daharoni/photodiode-lvds-receiver/docs/schematic/connector.md

# Connector sheet (as built, revision 4, decision 14)

Generated by `hardware/pcb/receiver-module/gen/connector.py`. Spec: `rev-a-sheet-specs.md` section 6 (revision 4, 2026-10-09). Nothing here is simulated or measured. Labels: VERIFIED / PROPOSED / UNRESOLVED. Citations as in the spec and `docs/research/decision-14-draft-usbc-single-connector.md` (TC = USB Type-C R2.5, WE = Wuerth rev 003.000, LVDS104 = TI SLLS396G, TPD = TI SLVSBO7O).

## Hierarchical pins
Outputs VBUS, CC1_SENSE, CC2_SENSE; bidirectional USB_DP, USB_DN, CAN_P, CAN_N (CANH/CANL; renamed from CAN_H/CAN_L 2026-10-16 so the KiCad diff-pair router pairs them), AUX; inputs LVDS_P, LVDS_N, RSSI, HV_MON, 3V3, 3V3_D (RSSI, HV_MON, 3V3, 3V3_D only feed test points TP50-TP53, as before). Removed in revision 4: +5V_CABLE, AUX2.

## J50 (AharoniLab_Connector:632723300011, Wuerth 24-pin horizontal Type-C receptacle; WE p.1, p.3 VERIFIED)
Footprint is the library symbol's own (`Wuerth_632723300011`). All four VBUS pins (A4, A9, B4, B9) on `VBUS`; all GND pins (A1, A12, B1, B12) on GND; shield S1 (the four shell posts, eight S1 pads) directly on GND since 2026-10-22 (C181 1 nF and R170 1 M DNP removed, PROPOSED; see the revision note below). Plug orientation does not matter (TC Table 3-10 p.83): N to SSTXp and P to SSTXn on both pairs (flipped 2026-10-09, see the fan-out note below).

| Pin | Net | Pin | Net |
|---|---|---|---|
| A2 SSTXP1 | LVDS_OUT2_N (U50 2Z) | B11 SSRXP1 | CAN_P |
| A3 SSTXN1 | LVDS_OUT2_P (U50 2Y) | B10 SSRXN1 | CAN_N |
| A5 CC1 | CC1 (R181 Rd, R185 tap, U51 D1+) | B5 CC2 | CC2 (R184 Rd, R188 tap, U52 D3+) |
| A6 DP1, B6 DP2 | USB_DP (tied) | B2 SSTXP2 | LVDS_OUT1_N (U50 1Z) |
| A7 DN1, B7 DN2 | USB_DN (tied) | B3 SSTXN2 | LVDS_OUT1_P (U50 1Y) |
| A8 SBU1, B8 SBU2 | AUX_CAB (tied) | A10 SSRXN2 | CAN_N |
| A11 SSRXP2 | CAN_P | | |

The ties are made by same-name local labels on the pins (nets USB_DP, USB_DN, AUX_CAB, VBUS, CAN_P, CAN_N); layout rule, not schematic: Dp/Dn ties within 3.5 mm of J50 (TC Table 3-4 note 1 p.77). A5/B5 are labelled CC/VCONN by Wuerth (WE p.3) and wired as CC1/CC2 (PROPOSED reading). Whether J50 is top- or mid-mount: UNRESOLVED.

## Parts
| Ref | Part | Note |
|---|---|---|
| J50 | 632723300011 | above |
| J51 "DEBUG / scope" | Conn_01x06 | 1 GND, 2 LVDS_DBG_N (U50 pin 11, 3Z), 3 LVDS_DBG_P (U50 pin 12, 3Y), 4 CAN_P, 5 CAN_N, 6 AUX (pair flipped 2026-10-16, VERIFIED against the exported netlist; otherwise PROPOSED) |
| U50 | SN65LVDS104PW (TSSOP-16) | A = LVDS_P, B = LVDS_N; 1Y/1Z -> J50 B3/B2, 2Y/2Z -> J50 A3/A2 (output swap and polarity flip 2026-10-09, see below), 3Z/3Y -> J51 2/3 (3Z = LVDS_DBG_N on pin 2, 3Y = LVDS_DBG_P on pin 3), 4Y/4Z no_connect; EN1-EN3 to 3V3, EN4 to GND (enables active high, LVDS104 section 9.4 Table 2, VERIFIED); VCC (4) 3V3 with C184 100 nF 0402 + C185 1 uF 0603; 23 mA typ / 35 mA max (p.5) |
| R180 | 100R 0.1 % 0603, fitted | across U50 A/B; the buffer has no on-chip termination (LVDS104 p.16 Fig. 25). Absorbs the old DNP bench pad of the same designator |
| R177 | 100R 0603, DNP | across LVDS_DBG_P/N (J51 scope load). UNRESOLVED: whether an unloaded output 3 is acceptable |
| U51 | TPD6E05U06 (USON-14, footprint Texas_R-PUSON-N14) | lower end of J50, I/O side facing J50, pin 14 uppermost: 14 = CC1 (A5), 13 no_connect (spare), 12 = LVDS_OUT2_P (A3, U50 2Y), 11 = LVDS_OUT2_N (A2, U50 2Z), 9 = CAN_P (B11), 8 = CAN_N (B10); swapped 2026-10-22, was 9 = CAN_N, 8 = CAN_P |
| U52 | TPD6E05U06 | upper end of J50, same orientation: 14 = LVDS_OUT1_P (U50 1Y, to B3), 13 = LVDS_OUT1_N (U50 1Z, to B2), 12 = CAN_P (A11), 11 = CAN_N (A10), 9 = CC2 (B5), 8 = AUX_CAB (A8/B8) |
| R181, R184 | 5.1k 1 % | Rd on CC1, CC2 (Type-C R2.0 Table 4-25 p.236) |
| R185/R187/C182 | 100k / 100k / 100 nF | CC1 tap -> CC1_SENSE |
| R188/R189/C183 | 100k / 100k / 100 nF | CC2 tap -> CC2_SENSE |
| R186 | 1k | AUX_CAB -> hierarchical AUX |
| R182, R183, C180 | 60.4R 1 %, 4.7 nF, DNP | CAN split termination, single-module bench only |
| TP50-TP55 | TestPoint | 3V3, 3V3_D, RSSI, HV_MON, GND, GND |

U51/U52 pins 1, 2, 3, 4, 6, 7 are NC pins in TI SLVSBO7O rev O (Aug 2024) Table 4-3 p.5: "Not connected; used for optional straight-through routing. Can be left floating or grounded." They are not internally connected to the I/O pins (VERIFIED, datasheet). Straight-through routing means the protected trace enters the I/O pad and leaves under the package body through the opposite NC pad (TI Fig. 7-11 p.17 layout example, drawn for the TPD4E05U06). Since 2026-10-16 the lab-library symbol (AharoniLab_Misc:TPD6E05U06, lab library branch tpd6e05u06-straight-through-pins, PR pending) draws the six NC pins as hidden passive pins stacked on the I/O pins (1 on 14, 2 on 13, 3 on 12, 4 on 11, 6 on 9, 7 on 8; KiCad library convention KLC S4.3), so each NC pad carries the same net as its opposite pad. Netlist (VERIFIED): U52 pads 1/2/3/4/6/7 = LVDS_OUT1_P / LVDS_OUT1_N / CAN_P / CAN_N / CC2 / AUX_CAB; U51 pads 1/3/4/6/7 = CC1 / LVDS_OUT2_P / LVDS_OUT2_N / CAN_P / CAN_N (6/7 swapped 2026-10-22; were CAN_N / CAN_P); U51 pad 2 shares the unconnected net of the spare pin 13 (the no_connect flag sits on the stacked pair; ERC 0/0). Layout rule (PROPOSED): route each protected line connector pad -> clamp I/O pad -> under the body -> opposite pad -> onward; this is what the 2026-10-09 "straight top-layer traces in pad order" note intended. The straight-through pads add 12 pad connections to the DRC unconnected list until routed.

ESD channel split by position (hand edit 2026-10-09, after placement started; generators frozen): the revision-4 split (U51 = both TX pairs + both CC, U52 = both CAN pairs + SBU) made half the protected lines run the length of the J50 pad rows past the other device before reaching their clamp, because the two plug orientations put the same function at opposite ends of the receptacle. U51 now clamps the lower-end pins (A5, A3/A2, B10/B11) and U52 the upper-end pins (B2/B3, A11/A10, B5, A8/B8), each pin level with its pad: A-row SMD pads get straight top-layer traces in pad order, B-row through-hole pins arrive on an inner layer with a via at the clamp pad, and pair polarity follows the pad order (ESD channels are identical). Nets unchanged; ERC 0/0; 223 components. PROPOSED.

Fan-out output swap (hand edit 2026-10-09): U50 output 1 (pins 16/15, the upper pair on the TSSOP) now feeds the upper end of J50 (B2/B3 through U52) and output 2 (pins 14/13) the lower end (A2/A3 through U51), so the two pairs no longer cross between U50 and the clamps. Polarity flip at J50 (Daniel, same day): N to SSTXp and P to SSTXn on both pairs. The lower pair now matches the package order (2Y above 2Z onto A3 above A2) with no crossing from U50 through U51 to the pads, all on the top layer. The upper pair reaches U52 uncrossed (1Y on pin 14, 1Z on pin 13) and swaps between the clamp pins and the B2/B3 barrels, where the lines already leave the top layer to get past the A-row pads. The polarity is consistent on both pairs, so plug orientation still does not matter; the cable carries the fan-out output inverted, and with LVDS_P low for a logic one (frontend.md) SSTXp is high for a one. The FPGA-end inversion constant moves accordingly (gateware, breakout docs). PROPOSED.

## Rules and citations
- Fan-out margin: TLV3605 VOD 250/350/450 mV (TLV p.7) against the buffer threshold +-100 mV: 150 mV at minimum VOD (VERIFIED arithmetic). Fail-safe static high with no TLV3605 power (LVDS104 p.15-16). Supply 3V3 up to about 101 mA total (66 mA estimate + 35 mA), inside the TPS79901 200 mA rating (rating not rechecked: UNRESOLVED). The ECP5 end is still terminated on-die (DIFFRESISTOR 100, `docs/research/ulx3s-lvds-input.md`); R180 sits at U50, not the FPGA.
- CC taps: 100k/100k keeps the pin below 3.3 V with 5.5 V VCONN on the unused CC (2.75 V, TC R2.5 p.155); a compliant source maximum 2.04 V becomes 1.02 V (TC R2.0 Table 4-36 p.241); the tap lowers effective Rd by about 2.5 %, Thevenin 50 k with 100 nF is 5 ms.
- SBU/AUX: single-ended, <= about 1 MHz (TC Table 3-24 p.113); a driven AUX line against TC section 4.3 p.150 (SBU open or weakly pulled down) is accepted; firmware holds AUX high-Z until LINK_ALL or the host class is known. UNRESOLVED: laptop alternate-mode SBU drive, SBU voltage limits.
- CAN: no termination on the module (SLLA270 p.4, p.8 Fig. 10); bus on both RX pairs gives about 45 ohm in parallel (PROPOSED). 125 kbit/s PROPOSED.
- ESD (TPD Table 5.4 p.7, VERIFIED): 0.47 pF typ, VRWM 5.5 V; place within a few mm of J50 (TPD p.5). UNRESOLVED: unidirectional clamp near -0.7 V against cable ground drop on CAN; USON-14 footprint versus the TI drawing.
- ULX3S targets gp/gn[8..13] (bank 7) then [14..21]: VERIFIED, ULX3S v3.1.7 p.2; Lattice FPGA-TN-02032 v1.4 p.14, p.26.
- HV rule: no bare APD_BIAS pad; HV_MON (about Vout/101) is the only HV observation point (PROPOSED).
- Cable rule and labelling text are on the sheet (passive full-featured USB 3.2 Gen 1, 3 A, e-marked, <= 2 m; the SuperSpeed pairs carry proprietary LVDS/CAN, not USB 3).

## Mounting holes (added 2026-10-09, hand-edited after the generators were frozen)
H1-H4 `AharoniLab_Connector:MountingHole_Pad` (footprint `AharoniLab_Connector:MountingHole_2.2mm_M2_Pad_Via`) are placed in a row at the right of the sheet (x 350-396 mm, y 150 mm), each pin 1 wired 2.54 mm to a `GND` global label (this sheet ties GND with global labels, not power symbols, so there are no new #PWR references). A text note reads "Mounting holes: M2 plated, GND tie to housing (decision: 2026-10-09)". The sheet file was edited directly (generator `gen/connector.py` is frozen and does not contain H1-H4; regenerating would drop them). PROPOSED; ERC 0/0 and the netlist shows H1-H4 pin 1 on GND, nothing measured. Requires lab-library PR #62 (symbol and footprint) merged or its branch checked out. Connector sheet now has 33 components.

Revision note (2026-10-16, Daniel, KiCad GUI, for layout): J51 debug pair flipped (pin 2 = LVDS_DBG_N, pin 3 = LVDS_DBG_P); nets CAN_H/CAN_L renamed CAN_P/CAN_N and USB_DM renamed USB_DN (no electrical change; CAN_P is CANH, U64 pin 7, CAN_N is CANL, U64 pin 6); U51/U52 straight-through NC pins stacked on the I/O pins (see the ESD note above). Net names elsewhere in this file use the new names.

Revision note (2026-10-22, Daniel): (A) J50 shell tied directly to GND (PROPOSED). C181 (1 nF) and R170 (1 M, DNP) were deleted from this sheet and the PCB; the eight J50 S1 pads are on net GND and the net /Connector/SHIELD no longer exists. Rationale: a compliant Type-C cable already ties shield to GND inside each plug (USB Type-C spec Table 3-10 note 6, as cited in `docs/research/usbc-connector-and-cable.md` line 91), so the RC never isolated anything; 1 nF is about 24 ohm at the 6.63 MHz QSCR field (arithmetic, ESL ignored), a poor bond for the cable braid around the SuperSpeed pairs; ESD on the shell should go straight to the plane. Layout rule (PROPOSED): every shell post to the GND planes with a solid (not thermal-relieved) zone connection on every layer; the plated post barrels tie the planes, no extra vias (reworded 2026-10-22, review P7), housing bonded at the connector end. Connector sheet 33 -> 31 components (board 223 -> 221). After a zone refill (kicad-cli pcb drc --refill-zones on a copy) the shield pads connect to the GND pours with 0 unconnected S1 items; the zones were not refilled in the file. ERC 0 violations. (B) Routing-only change in the KiCad GUI: on U51 the CAN clamp channels were swapped, so pin 9 (and stacked NC pin 6) = CAN_P (J50 B11) and pin 8 (and stacked NC pin 7) = CAN_N (J50 B10). J50 pin nets are unchanged and the clamp channels are identical and independent, so it is electrically neutral. U52 unchanged.

## Validation (revision 4, 2026-10-09, kicad-cli 10.0.5, root project)
D50 VBUS transient suppressor (added 2026-10-25, decision 34, hand edit with KiCad closed, PROPOSED): `AharoniLab_Passive:SMF5.0A`, unidirectional TVS, 200 W, VRWM 5 V, VBR 6.4 to 7.0 V, VC 9.2 V at 21.7 A, SOD-123FL (footprint `AharoniLab_Diode_SMD:D_SOD-123F`; lab PR #66). Pin 1 (cathode) on a `VBUS` local label, pin 2 (anode) on a GND global label, drawn left of the J50 pin-label column at (226.06, 121.92). Numbers VERIFIED against docs/datasheets/smf5.0a-panjit.pdf (Panjit SMF5.0A series REV.13; the Littelfuse SMF part is the intended vendor, LCSC C151296). Breakdown stays above the eFuse OVLO trip (5.76 to 6.20 V) and the clamp is below the TPS2596 21 V absolute maximum. ERC 0/0 after the edit; the Connector sheet designator range gains D50-D59.

ERC: 0 errors, 0 warnings. Netlist: 29 components on /Connector/ at that date (J50, J51, U50-U52, R170 [removed 2026-10-22], R177, R180-R189, C180-C185 [C181 removed 2026-10-22], TP50-TP55; 27 after the removal). Net checks: VBUS = J50 A4/A9/B4/B9, Power U5 pin 4, R35, C33, Controller U61 pin 5; USB_DP = J50 A6/B6 and U61 pin 1; USB_DN = J50 A7/B7 and U61 pin 3; CC1_SENSE = R185, R187, C182, U60 pad 9; CC2_SENSE = R188, R189, C183, U60 pad 10; AUX = R186, R204, J51 6; CAN_P = J50 A11/B11, U52 12/14, J51 4, R182, U64 7. Not simulated or measured. Revision history: revision 2 (decision 12) and revision 3 (decision 13) described the 12-pin J50 and +5V_CABLE, all removed here.
