daharoni/photodiode-lvds-receiver/docs/schematic/rev-a-sheet-specs.md

# Rev A schematic specifications, sheet by sheet

**Frozen 2026-10-09 (layout started): the generators are disabled (`hardware/pcb/receiver-module/gen/FROZEN`); this spec is now updated to describe GUI edits rather than drive regeneration.**

Status labels: VERIFIED (cited datasheet or measurement), PROPOSED (design intent), UNRESOLVED (open). Nothing on this page is measured or simulated. These specs are the brief for populating `hardware/pcb/receiver-module/*.kicad_sch`; the as-built notes live in `docs/schematic/<sheet>.md`. Authority: `docs/decision-log.md` (14 standing corrections), `docs/calculations/apd-bias-design.md`, `docs/research/ulx3s-lvds-input.md`.

Conventions for every sheet:
- Symbols only from the lab library (`${AHARONI_LAB_KICAD_LIB}`); generic R/C/L get an explicit footprint. Default passives 0603 (`R_0603_1608Metric_N`, `C_0603_1608Metric_N`); 0402 only for local decoupling at fast ICs; HV parts 1206/1210 as noted.
- GND is a global label on every sheet. Rails arrive as hierarchical labels (VBUS on Power, 3V3, 3V3_D, APD_BIAS).
- Routing targets (PROPOSED, Daniel 2026-10-09): 90 ohm differential for the four SuperSpeed pairs between U50/J50 and for `CAN_P`/`CAN_N` to J50 (they ride on 90 ohm USB-C cable pairs; TC R2.5 cable pair impedance), 90 ohm differential for `USB_DP`/`USB_DN` between J50 and U61/R193/R194; intra-pair length match within 1 mm (UI 20 ns; relaxed 2026-10-22 to 2.5 mm on DIFF90 only, CAN/USB/LVDS_P/N not skew-checked, see the PCB README); 100 ohm differential for `LVDS_P`/`LVDS_N` from U20 to the R180 termination at U50 (short run). Stackup chosen 2026-10-09: JLCPCB JLC06161H-3313, 6 layers; the trace geometries (DIFF90/USB90/CAN90 0.145/0.15 mm, DIFF100 0.11/0.15 mm) are 2D-solver values in `hardware/pcb/receiver-module/README.md`, PROPOSED until confirmed in the JLCPCB calculator.
- Nets at or above 50 V are prefixed `HV_` (plus `APD_BIAS`); the project netclass `HV` (set in the .kicad_pro by the orchestrator) uses a 1.0 mm clearance.
- Every sheet carries a text block "Design intent" with the status labels, and every value that comes from a datasheet or the calculation docs cites it in the as-built note.
- Reference designator ranges (so sheets never collide): Power U1-U9/R1-R49 (R35-R39 used by U5, see 1.1; R40-R44 free)/C1-C49 (C32-C33 used by U5)/D1-D9/L1-L9/Q1-Q9/J1-J2/RV1-RV2/TH1/FB1-FB2/TP1-TP9; Front end U10-U19/R50-R79/C50-C79/D10-D19/JP10-JP19/TP10-TP19; Slicer U20-U29/R80-R99/C80-C99/TP20-TP29; Monitor U30-U39/R100-R149/C100-C129/D30-D39/JP30-JP39/RV30-RV39/TP30-TP39; Connector J50-J59/H1-H9 (mounting holes, reserved for this sheet; H1-H4 used)/R170-R189/C180-C189/D50-D59 (added 2026-10-25 for the VBUS TVS D50, decision 34)/U50-U59/TP50-TP59 (revision 4 extends R180-R189 down to R170-R179 for the shield and J51 termination; R170 and C181 were removed 2026-10-22 with the shield tie to GND; U50 widens to U50-U59 for the two ESD arrays; R150-R169 stay unallocated); Controller U60-U69/R190-R229 (R200-R202, R215, R216 freed by revision 4)/C190-C219 (C193, C205 freed; C206-C207 stay the DNP D+/D- caps)/D60-D69/J61/SW60-SW61 (RESET, BOOT)/TP60-TP69. The Slicer's R56-R59/C53-C55/R87/C87 style parts belong to the Front End/Slicer ranges above and are not touched by the Connector sheet.

Hierarchical nets (revision 4): rails `3V3`, `3V3_D`, `APD_BIAS` (Power -> users); `VBUS` (Connector -> Power and Controller; the single 5 V input, decision 14); `DAC_HV`, `HV_DIS` (Controller -> Power); `HV_MON` (Power -> Controller, Connector); `TIA_CTRL` (Controller -> Front End); `TIA_TAP` (Front End -> Monitor, RSSI pick-off); `SDET_P` (Front End -> Slicer; `SDET_N` is built on the Slicer sheet and is not hierarchical); `VCM_REF` (Monitor -> Front End, Slicer); `RSSI` (Monitor -> Controller, Connector); `DAC_TH` (Controller -> Slicer); `VTH_MON` (Slicer -> Controller); `SHDN_N`, `LE_HYS` (Controller -> Slicer); `LVDS_P/N` (Slicer -> Connector; now the input of the fan-out buffer U50); `CAN_P`, `CAN_N` (Controller <-> Connector); `AUX` (Connector <-> Controller, one net: SBU1 and SBU2 tied); `USB_DP`, `USB_DN` (Connector <-> Controller, bidirectional); `CC1_SENSE`, `CC2_SENSE` (Connector -> Controller, divided CC levels to ADC pins). Removed in revision 4: `+5V_CABLE`, `PWR_SRC`, `AUX2`, the Controller -> Power `VBUS`. `+5V` is the internal rail (U5 OUT) inside the Power sheet and is not a hierarchical net. Root: PWR_FLAG `#FLG04` moves from the `+5V_CABLE` net to the `VBUS` net; `#FLG60` (inside the Controller sheet) is removed so there is exactly one flag on VBUS.

| Net | From | To | Revision 4 status |
|---|---|---|---|
| `VBUS` | Connector (J50 VBUS pins) | Power (U5 IN), Controller (U61 pin 5) | new direction; was Controller -> Power |
| `USB_DP`, `USB_DN` | Connector (J50 Dp1/Dp2 tied, Dn1/Dn2 tied) | Controller (R193/R194 side) | new hierarchical pins |
| `CC1_SENSE`, `CC2_SENSE` | Connector (CC taps) | Controller (IO4, IO5) | new |
| `AUX` | Connector (R186 after the SBU tie) | Controller (IO7 via R204) | kept; `AUX2` removed |
| `LVDS_P`, `LVDS_N` | Slicer | Connector (U50 A/B) | unchanged name |
| `CAN_P`, `CAN_N` | Controller | Connector (both RX pairs, U51/U52 clamps) | unchanged name |
| `+5V_CABLE`, `PWR_SRC` | | | removed |

**Revision 4 (decision 14, 2026-10-09, approved by Daniel):** one 24-pin USB-C receptacle (Wuerth 632723300011, horizontal) replaces the 16-pin USB-C J60 and the 12-pin system header J50; the TPS259631DDAR eFuse replaces the TPS2121 mux U5; the SN65LVDS104PW fan-out U50 drives both SuperSpeed TX pairs; CAN is bused on both RX pairs; SBU1 and SBU2 are tied as `AUX`; CC1 and CC2 are read on IO4 and IO5. Removed: TPS2121 two-source mux, `+5V_CABLE`, `PWR_SRC`, VBUS_SENSE divider, J60, the 12-pin J50, AUX2. Source: `docs/research/decision-14-draft-usbc-single-connector.md` (adopted) and `docs/research/usbc-connector-and-cable.md`, `usbc-power-path.md`, `lvds-fanout-and-foreign-host.md`. Everything PROPOSED unless labelled; nothing simulated or measured. The decision-13 USB-standalone requirement is kept (realised by this single connector).

**Revision 3 (decision 13, 2026-10-09; the power-mux parts are superseded by revision 4):** USB-standalone power and programming: TPS2121 source mux U5 on the Power sheet (cable priority, USB-C fallback), RESET/BOOT switches, 22 ohm D+/D- series resistors, VBUS_SENSE on IO4 and PWR_SRC on IO5. `+5V` becomes `+5V_CABLE` on the cable side; `+5V` remains the merged internal rail (mux OUT). Facts and citations: docs/research/usb-standalone-power.md. All of it PROPOSED, nothing simulated or measured.

**Revision 2 (decision 12, 2026-10-08):** the VCA821 VGA, AGC loop, detector coupon, +/-3.7 V and 5V_A rails are removed; the chain is TIA -> AC coupling -> OPA855 x7 -> low-pass -> AC coupling to a 1.65 V baseline -> TLV3605. The Control sheet becomes the Monitor sheet (reference and RSSI); the Detector sheet is deleted. Sections 2, 3, 4 and 7 below are rewritten; section 5 is gone. Facts: docs/research/post-amp-slicer.md.

**Revision 1 (decision 11):** the external-MCU header is replaced by an on-module ESP32-C6 controller sheet (section 7) with on-board I2C DAC/ADC, a CAN link in the module cable (section 6), a 3V3_D rail (section 1.5) and an HV disable gate (section 1.4). Facts and citations: docs/research/module-controller.md.

---

## 1. Power sheet (`power.kicad_sch`)

Pins: in VBUS, DAC_HV, HV_DIS; out 3V3, 3V3_D, APD_BIAS, HV_MON. (Revision 2: the LM27762 +/-3V7 block, the 5V_A bead/caps, PGOOD_VGA and TP1 are removed. Revision 4: `+5V_CABLE` and `PWR_SRC` are removed.)

### 1.1 Input: eFuse U5 (TPS259631DDAR)
- U5 `AharoniLab_Power:TPS259631DDAR`, footprint `AharoniLab_Package_SO:Texas_DDA0008B_SO-PowerPAD-8` (the exact footprint name is TO BE CONFIRMED by the lab-library PR; candidate geometry from bundled `Package_SO:HSOP-8-1EP_3.9x4.9mm_P1.27mm_EP2.41x3.1mm` or `Package_SO:TI_SO-PowerPAD-8`, compare against the DDA land pattern, TPS2596 SLVSET8A p.46: UNRESOLVED until the PR). [Resolved 2026-10-09: lab-library PR #61 supplies `AharoniLab_Package_SO:Texas_DDA-R-PDSO-G8_SO-PowerPAD-8_3.9x4.9mm_P1.27mm_EP2.4x3.1mm` (power.md); the land pattern versus the TI drawing stays a G4 footprint check.] New lab-library symbol and footprint required. Variant chosen for x1 auto-retry (TPS2596 Device Comparison p.3); fixed-clamp variants rejected (a sustained 12 V input would dissipate about 1.6 W in the FET, arithmetic). Pin map (TPS2596 p.4, VERIFIED per the draft): 1 GND, 2 dVdt, 3 EN/UVLO, 4 IN, 5 OUT, 6 FLT, 7 ILM, 8 OVLO, exposed pad GND. Abs max on IN 21 V (TPS2596 p.1, p.5).
- IN (pin 4) = `VBUS` directly (hierarchical input, source on the Connector sheet). OUT (pin 5) = `+5V`, the internal rail used by U1, U3 (via the L2 pi filter) and U4; C1 10 uF 0805 and C2 100 nF stay on `+5V`.
- Divider (all 1 %, 0603): R35 357 k from IN to EN/UVLO, R36 43.2 k from EN/UVLO to OVLO, R37 100 k from OVLO to GND. Thresholds (PROPOSED, calculated with datasheet tolerances and 1 % resistors, not simulated; draft section 3d and `docs/research/usbc-power-path.md` item 1): overvoltage cut-off 5.76-6.20 V rising (below the 7.0 V abs max of the TPS79901, TPS799 SBVS056L p.4); UVLO 4.06-4.32 V rising, 3.72-4.00 V falling.
- ILM (pin 7): R38 1.21 k 1 % to GND, never open: ILIM 0.68 / 0.76 / 0.84 A min/typ/max (TPS2596 Eq. 5 p.22, +-10.4 %; PROPOSED arithmetic). The ILM node is also a test point TP3 "IMON" (about 0.79 V/A, usbc-power-path.md 1.4). The 0.76 A limit is a real current limit, not a USB budget: a laptop port still decides the USB 0.5 A budget.
- dVdt (pin 2): C32 47 nF X7R 10 V 0603 to GND: about 0.94 V/ms, 5.3 ms ramp, about 23 mA inrush into the assumed 25 uF on +5V (25 uF is an estimate, PROPOSED, measure in G1).
- VBUS input capacitor C33 4.7 uF 25 V X5R 0805, as close to IN as possible. C34 removed.
- FLT (pin 6): open-drain, test point TP4 "FLT"; optional R39 100 k pull-up, DNP (draft: to +5V; the brief said 3V3_D). UNRESOLVED: both rails are off while the eFuse is cut off, so a pull-up to either reads 0 V and cannot separate fault from no power; a pull-up to VBUS would read correctly. Fit only for bench use, pick the rail at generator time and check the FLT pin abs max (not read). FLT is NOT routed to the ESP32 (unpowered during cut-off). VBUS-present is implied by the MCU running; no VBUS monitor in Rev A (the ADS1115 AIN3 stays the ADC zero check).
- Margin (PROPOSED arithmetic, draft 3d): a Type-C source is 4.75-5.5 V; a compliant 3 A cable drops at most 75 mV loop at 0.3 A (TC R2.5 4.4.1 p.151), so the module sees at least about 4.66 V against UV rising 4.06-4.32 V. A non-compliant 28 AWG 3 m cable would drop about 0.38 V at 0.3 A (computed), leaving about 4.37 V against the 4.32 V maximum rising threshold: UNRESOLVED, the reason for the cable rule (decision 14: <= 2 m certified passive full-featured; 3 m only after a bench check).
- Removed: TPS2121 U5, old R35/R36 priority divider, old R37 ST pull-up, old R39-R42 OV dividers, C34, nets `+5V_CABLE` and `PWR_SRC`, PWR_FLAG on `+5V_CABLE` (the flag moves to `VBUS` at the root). TPS2121 settling/inrush G1 items are replaced (gates.md).
- Budget: worst case about 0.19 A (0.24 A with 25 % margin) from `+5V`, against the 0.5 A USB default (docs/research/usb-standalone-power.md section 1.5; datasheet maxima plus an assumed 70 % LT8365 efficiency, not measured), plus up to 35 mA on 3V3 for U50 (LVDS104 SLLS396G p.5, all four outputs loaded). Radio must stay disabled. UNRESOLVED: whether a bus-powered hub holds a module to 100 mA; document "use a laptop root port or a powered hub".
- Fallback only if Daniel withdraws the new-part approval (not planned): TPS2121 with IN1 = VBUS and IN2, OV2, CP2, PR1, ST tied to GND (draft section 3d).

### 1.2 3V3: TPS79901DDCT (U1)
- IN = +5V with 1 uF 0603 at the pin; EN tied to IN; GND.
- FB divider: VOUT = VFB x (1 + R1/R2), VFB 1.193 V typ (TPS799 SBVS056L). R1 17.8 k, R2 10.0 k, 1 %, 0603 -> 3.316 V. CFB 1 nF across R1 (value UNRESOLVED, see power.md). OUT = 3V3: 2 x 4.7 uF 0805 X7R 10 V.
- Load estimate: OPA857 26.8 mA max + OPA855 (SBOS622D, check Iq at 3.3 V) + TLV3605 17.5 mA max + OPA2320 ~2 mA ~ 65 mA. PROPOSED.

### 1.5 3V3_D digital rail: TPS7A2033PDBV (U4)
- As built: IN = +5V with 1 uF; OUT = 3V3_D with 10 uF 0805 + 1 uF; EN tied to IN. Radio must stay disabled (300 mA LDO). PROPOSED.

### 1.4 APD bias: LT8365EMSE (U3)
- As built per `docs/calculations/apd-bias-design.md` sections 3.2 and 4, with the HV disable gate (Q3 on EN/UVLO, gate pulled up to 3V3_D, driven by HV_DIS, J1 "HV FORCE ON" DNP jumper) and the HV_MON divider. Unchanged in revision 2; input from +5V (U5 OUT, the eFuse output in revision 4). Revision 3: USB-alone, HV_DIS default-off and the DAC_HV safe-end rule are unchanged; firmware starts HV at the low-bias end of DAC_HV in steps, watching HV_MON and supply sag (a faulted HV start can trip a USB port; PROPOSED). The LT8365 EN/UVLO (R22/R23, rising 3.15-3.80 V) does not guard against USB sag in the legal range.

---

## 2. Front end (`frontend.kicad_sch`)

Pins: in APD_BIAS, 3V3, TIA_CTRL, VCM_REF; out SDET_P, SDET_N, TIA_TAP.
- Stage 2 filter: R50 10 k 1206 (>= 200 V) from APD_BIAS to `HV_K`; C50 10 nF >= 400 V C0G 1210 from HV_K to GND, at the cathode. D10 S12023-10: 1 A = `TIA_IN`, 3 K = HV_K, 2 CASE = GND. D11 (FDS010 bench fallback, DNP) was dropped from Rev A on 2026-10-09 (Daniel); reference D11 is retired. Standing correction 2.
- U10 OPA857 (SBOS630D): IN (15) = TIA_IN; VS+ (9, 10, 11) = 3V3 with 2 x 100 nF 0402 + 1 uF 0603; GND pins and PAD = GND; Test_SD (13) = GND; Test_IN (14) = 3V3; NC (16) no_connect. CTRL (2) = hierarchical input `TIA_CTRL` from the ESP32 (logic 1 = 20 k, 0 = 5 k; VIH 2 V) with R57 100 k pull-up to 3V3 so an unprogrammed ESP32 gives 20 k; JP10 SolderJumper_3 (common = CTRL, sides 3V3 / GND) stays for bench forcing, open by default. OUT (8) = `TIA_OUT`, OUTN (5) = `TIA_REF`.
- RSSI pick-off: `TIA_TAP` = TIA_OUT through R58 1 k (so the Monitor sheet's peak detector loads the TIA lightly); hierarchical output.
- Coupling into the post-amp (research doc section 4): C51 100 nF from TIA_OUT to `PA_IN`; R51 1 k from PA_IN to VCM_REF (corner 1.6 kHz; the research asks for >= 10 us time constant: 1 k x 100 nF = 100 us, fine). TIA_REF (OUTN) is left unused except for TP12 (single-ended post-amp; the differential option is noted on the sheet as UNRESOLVED).
- U11 OPA855IDSGR (SBOS622D; library branch add-opa855): non-inverting gain 7: IN+ = PA_IN; RF R53 301 ohm from OUT to IN-, RG R54 49.9 ohm from IN- to `PA_REF` where PA_REF = VCM_REF decoupled by C53 1 uF (so the gain is referenced to the baseline, not GND; the stage output idles at VCM_REF); check the datasheet's recommended RF/RG for G = 7 and use those values if they differ, citing the page. [Status note 2026-10-09, value unchanged: SIMULATED (ngspice 47, TI OPA855 Rev A) RF 301 / RG 49.9 is as stable as the datasheet test values 453 / 75 (77 deg PM both, moderately trustworthy, model AC polarity quirk; no parasitics or tolerances); UNRESOLVED until measured (G1). See docs/simulation/README.md Sim 1.] VS+ = 3V3 with 100 nF 0402 + 1 uF 0603 at the pin; VS- = GND; PD (power-down) pin: check polarity in the datasheet and tie it to the "enabled" level (via R 10 k) ; exposed pad per datasheet. OUT = `PA_OUT`. Place a 0 ohm DNP bypass R55 from PA_IN to PA_OUT? No: keep it simple, no bypass.
- Low-pass: R56 49.9 ohm from PA_OUT to `LPF_OUT`, C54 47 pF C0G to GND (corner 68 MHz; research asks for 60-80 MHz; PROPOSED). Then the comparator coupling: C55 100 nF LPF_OUT -> `SDET_P`; R59 1 k SDET_P -> VCM_REF. The threshold side `SDET_N` (VCM_REF plus the DAC_TH trim) is built on the Slicer sheet, so the Front End outputs only SDET_P and TIA_TAP (hierarchical outputs).
- Test points: TP10 PA_OUT, TP11 SDET_P, TP12 TIA_REF; no HV test points.
- Text: design intent (decision 12), clip thresholds (9 uA pp at 20k, 36 uA at 5k, TIA saturation 60 uA), OPA857 at 6 pF (SIMULATED: stable; 20k mode 13.8 % overshoot, 12.6 ns to 2 %, 5k clean; model fidelity at 6 pF not validated; UNRESOLVED until measured, G1; docs/simulation/README.md Sim 2), HV keep-out, APD polarity.

---

## 3. Slicer (`slicer.kicad_sch`)

Pins: in SDET_P, VCM_REF, DAC_TH, 3V3, SHDN_N, LE_HYS; out LVDS_P, LVDS_N, VTH_MON.
- U20 TLV3605RVKR (SNOSDA2F): IN+ (4) = SDET_P (arrives already coupled and returned to VCM_REF on the Front End sheet); IN- (6) = `SDET_N` = threshold node: R84 1 k from VCM_REF to SDET_N (matches the IN+ return, bias-current cancellation), DAC_TH injected through R85 100 k into SDET_N (authority about +/-16 mV around VCM_REF when the DAC spans 0-3.3 V with VCM_REF at 1.65 V: trim = (DAC - 1.65) x 1k/101k; state the number), C84 10 nF from SDET_N to GND (keeps IN- quiet). VTH_MON = SDET_N through R86 10 k (hierarchical output to the ADC).
- External hysteresis 2-4 mV (research doc section 4): R87 from OUT+ (LVDS, ~350 mV swing into the 100 ohm termination R180 at the fan-out buffer U50 on the Connector sheet, a few cm away; revision 4) to IN+ with the IN+ source impedance being the 1 k return in parallel with the coupling path; compute R87 for ~3 mV (about 100 k with a 1 k source; show the arithmetic on the sheet and label PROPOSED; footprint 0603). LE/HYS pin: R82 to GND footprint DNP (internal hysteresis off = floating; the smallest internal step ~8 mV is too large), R83 0 ohm DNP to LE_HYS for the latch option, as before.
- VCCI (2) = 3V3 with 100 nF 0402 + 1 uF; VCCO (1) = 3V3 via R80 0 ohm with 100 nF 0402 + 1 uF; VEE and EP = GND; SHDN (7) = SHDN_N with R81 10 k pull-up to 3V3; OUT+ (12) = LVDS_P, OUT- (10) = LVDS_N.
- Revision 4 note: `LVDS_P`/`LVDS_N` now go to the Connector sheet's fan-out input U50 (A/B). The 100 ohm termination (R180, 0.1 %) sits across U50 A/B (the buffer has no on-chip termination, LVDS104 p.16 Fig. 25), so the old DNP 100 ohm bench pad on the Connector sheet is absorbed into the fitted R180. The load is still 100 ohm, so the R87/C87 hysteresis tap and the 3.0 mV window are unaffected. Layout: short 100 ohm differential route to U50. No schematic change on this sheet except the text notes (termination moved). PROPOSED.
- TP20 SDET_N, TP21 SDET_P (DNP).
- Text: baseline slicing rationale (8b/10b DC balance), bias current 1-5 uA x 1 k = 1-5 mV offset (trimmed by DAC_TH), hysteresis arithmetic, SHDN not a guaranteed zero (standing correction 11).

---

## 4. Monitor (`control.kicad_sch` keeps its file name and uuid; Sheetname "Monitor")

Pins: in 3V3, TIA_TAP; out VCM_REF, RSSI.
- U30 OPA2320AIDR (3V3, 100 nF): unit A = VCM_REF buffer: R100/R101 10 k/10 k from 3V3 to GND, C100 100 nF at the midpoint, unity buffer -> VCM_REF (1.65 V), with C101 1 uF at the output? OPA2320 drives capacitive loads poorly: use R102 10 ohm isolation then C101 1 uF, and take VCM_REF after the resistor (note). [Status note 2026-10-09, value unchanged: SIMULATED (ngspice 47, TI OPAx320 Final 1.6) 10 ohm gives 87.6 deg PM with 1 uF; the no-isolation control is unstable; UNRESOLVED until measured (G1). See docs/simulation/README.md Sim 3.] The buffer sources the return currents of three 1 k resistors: negligible.
- RSSI peak detector (telemetry only, not precision): TIA_TAP -> D30 BAS70 (anode at TIA_TAP? The TIA output swings DOWN from OUTN on light (OPA857 inverting; check SBOS630D and state it), so detect the NEGATIVE peak: D30 cathode at TIA_TAP, anode at `RSSI_HOLD`), C102 1 nF C0G from RSSI_HOLD to GND, R103 1 M from RSSI_HOLD to VCM_REF (so with no signal RSSI_HOLD sits at 1.65 V and dips with signal; tau 1 ms), unit B unity buffer -> RSSI (hierarchical output, read by the ADS1115). Note: diode drop and the 1 k tap resistor make it a relative indicator; the ESP32 calibrates. PROPOSED.
- TP30 VCM_REF, TP31 RSSI, TP32 RSSI_HOLD.
- Everything else from the former Control sheet (VMID, VSPAN, integrator, TMUX1112, TLV3201, selectors, trimmers, clamps) is removed.

---

## 5. Detector coupon: removed (decision 12). Delete `detector.kicad_sch`, `gen/detector.py`, `docs/schematic/detector.md`.

---

## 6. Connector (`connector.kicad_sch`)

Pins: out VBUS, USB_DP, USB_DN, CC1_SENSE, CC2_SENSE; in LVDS_P, LVDS_N, RSSI, HV_MON, 3V3, 3V3_D; bidirectional CAN_P, CAN_N, AUX. (USB_DP/USB_DN are drawn bidirectional.) Revision 4, decision 14; source `docs/research/decision-14-draft-usbc-single-connector.md` sections 2-3, citations as in that draft (TC = USB Type-C R2.5, WE = Wuerth rev 003.000, LVDS104 = TI SLLS396G, TPD = TI TPDxE05U06 SLVSBO7O).

- H1-H4 `AharoniLab_Connector:MountingHole_Pad` (one passive pin "1" tied to GND by a global label), footprint `AharoniLab_Connector:MountingHole_2.2mm_M2_Pad_Via`: four M2 plated mounting holes, plated pad plus via ring, GND tie to the housing (decision 2026-10-09; PROPOSED; layout positions per the PCB placement plan). Designators H1-H9 are reserved for the Connector sheet. New lab-library symbol and footprint by lab-library PR #62 (branch `add-mounting-holes`).
- J50 `AharoniLab_Connector:632723300011` (Wuerth, 24-pin horizontal Type-C hybrid receptacle, 1.6 mm PCB; WE p.1, p.3, VERIFIED), footprint `AharoniLab_Connector:Wuerth_632723300011`. New lab-library symbol and footprint by library PR (neither exists, draft CONN 4.2). Pin names per TC Table 3-4 p.76; Wuerth labels A5/B5 "CC"/"VCONN" (WE p.3), wired as CC1/CC2 per the receptacle names (PROPOSED reading). All VBUS pins bussed, all GND pins bussed. Whether the part is top- or mid-mount is UNRESOLVED (check at layout).

| Pin | Signal | Net | Pin | Signal | Net |
|---|---|---|---|---|---|
| A1 | GND | GND | B12 | GND | GND |
| A2 | SSTXp1 | LVDS_OUT2_N (U50 2Z) | B11 | SSRXp1 | CAN_P |
| A3 | SSTXn1 | LVDS_OUT2_P (U50 2Y) | B10 | SSRXn1 | CAN_N |
| A4 | VBUS | VBUS | B9 | VBUS | VBUS |
| A5 | CC1 | CC1 (R181 Rd 5.1 k 1 % to GND; tap) | B8 | SBU2 | AUX_CAB |
| A6 | Dp1 | USB_DP (tied to B6) | B7 | Dn2 | USB_DN (tied to A7) |
| A7 | Dn1 | USB_DN (tied to B7) | B6 | Dp2 | USB_DP (tied to A6) |
| A8 | SBU1 | AUX_CAB (tied to B8) | B5 | CC2 | CC2 (R184 Rd 5.1 k 1 % to GND; tap) |
| A9 | VBUS | VBUS | B4 | VBUS | VBUS |
| A10 | SSRXn2 | CAN_N | B3 | SSTXn2 | LVDS_OUT1_P (U50 1Y) |
| A11 | SSRXp2 | CAN_P | B2 | SSTXp2 | LVDS_OUT1_N (U50 1Z) |
| A12 | GND | GND | B1 | GND | GND |

  The polarity rule (flipped 2026-10-09, see the bracketed note under U50 below): N to SSTXp and P to SSTXn on both pairs, the same on both so orientation still does not matter. Plug orientation does not matter (draft section 2.2, from TC Table 3-10 p.83 cable wiring: in all four flip combinations the module's two driven pairs land on the far end's {RX1, RX2} with polarity preserved). Layout rules (not schematic): the Dp1/Dp2 and Dn1/Dn2 ties within 3.5 mm of the receptacle (TC Table 3-4 note 1 p.77), ESD arrays within a few mm of the receptacle (TPD p.5 note). Shield: originally a separate pad net to GND through C181 1 n in parallel with R170 1 M (DNP), the convention carried over from the old J60 (C193/R202); changed 2026-10-22 (Daniel, PROPOSED): C181 and R170 removed, shell pads directly on GND (see `connector.md` revision note 2026-10-22).
- Rd and CC taps (decision 14, draft 3e; PROPOSED): R181 5.1 k 1 % from CC1 to GND and R184 5.1 k 1 % from CC2 to GND (Rd, needed to detect the source advertisement, USB Type-C R2.0 Table 4-25 p.236). Per CC pin, a tap: CC1 -> R185 100 k -> `CC1_SENSE`, R187 100 k and C182 100 nF from `CC1_SENSE` to GND; CC2 -> R188 100 k -> `CC2_SENSE`, R189 100 k and C183 100 nF from `CC2_SENSE` to GND. Reason for 100 k/100 k: the pin stays below 3.3 V even if an e-marked cable puts its 5.5 V VCONN (3.0-5.5 V, TC R2.5 p.155) on the unused CC pin (2.75 V at the pin). Arithmetic: a compliant source CC maximum 2.04 V (TC R2.0 Table 4-36 p.241) becomes 1.02 V; class voltages 0.42 / 0.94 / 1.69 V (56 k / 22 k / 10 k) become 0.21 / 0.47 / 0.85 V; thresholds 0.66 V and 1.23 V become 0.33 V and 0.615 V. The 200 k tap in parallel with 5.1 k lowers effective Rd by about 2.5 % and every class voltage with it (fold into the firmware thresholds). Thevenin 50 k with 100 nF = 5 ms time constant.
- SBU: `AUX_CAB` (A8 and B8 tied) -> R186 1 k -> hierarchical `AUX`. Cable SBU is single-ended, 32-53 ohm, <= 5 ohm DC, 2 dB loss at 0.5 MHz and 4 dB at 1 MHz (TC Table 3-24 p.113), so AUX is slow (<= about 1 MHz, PROPOSED). TC section 4.3 p.150 says a port that implements neither USB4 nor an Alternate Mode leaves SBU open or weakly pulled down (>= 950 kohm); our AUX is a driven line, noted and accepted (neither end is a compliant alternate-mode port, PROPOSED). UNRESOLVED: a laptop plugged directly might drive SBU for DisplayPort alt mode (needs USB PD discovery the module never answers); SBU voltage limits not in hand; the 1 k plus the clamp limit the exposure of the 3.3 V-only ESP32 GPIO. Firmware holds the AUX driver high-Z until LINK_ALL or the host class is known. R187 (old AUX2 1 k) is reused above; AUX2 is gone.
- Fan-out U50 `SN65LVDS104PW` (new lab-library symbol; pin map from LVDS104 p.3: EN1 1, EN2 2, EN3 3, VCC 4, GND 5, A 6, B 7, EN4 8, 4Z 9, 4Y 10, 3Z 11, 3Y 12, 2Z 13, 2Y 14, 1Z 15, 1Y 16), footprint `AharoniLab_Package_SO:TSSOP-16_4.4x5mm_P0.65mm` (exists; TI mechanical drawing not compared, UNRESOLVED, check at layout). Input: A = `LVDS_P`, B = `LVDS_N` from the Slicer, R180 100 ohm 0.1 % 0603 across A/B (fitted; the buffer has no on-chip termination, LVDS104 p.16 Fig. 25). TLV3605 VOD 250/350/450 mV (TLV p.7) against the buffer threshold +-100 mV and common-mode 0 to VCC-0.8 V (LVDS104 p.4-5): margin 150 mV at minimum VOD (VERIFIED arithmetic, draft 3b). Outputs: 1Y/1Z -> LVDS_OUT1_P/N (J50 B3/B2), 2Y/2Z -> LVDS_OUT2_P/N (J50 A3/A2), 3Y/3Z -> J51 pins 2/3, 4Y/4Z no_connect. [Swapped by hand edit 2026-10-09 (originally 1 -> A2/A3, 2 -> B2/B3): output 1 is the upper pair on the TSSOP and B2/B3 is the upper end of J50, so with this assignment the two pairs run to their clamps without crossing each other. Polarity flipped at J50 the same day (Daniel): N to SSTXp and P to SSTXn on both pairs, so the lower pair A3/A2 (n above p) matches 2Y above 2Z on the package with no crossing at all, and the upper pair takes its swap between the U52 clamp pins and the B2/B3 barrels, where the lines already change layer to get past the A-row pads. Consequence: the cable carries the fan-out output inverted on both pairs; since LVDS_P is low for a logic one (frontend.md), SSTXp is HIGH for a one. The FPGA-end polarity is a gateware constant either way; record it in the breakout/gateware docs.]
- Enables: the SN65LVDS104 enables are ACTIVE HIGH (function table, LVDS104 section 9.4 Table 2: xEN = H gives the data-following state, xEN = L gives Z; VIH >= 2 V and VIL <= 0.8 V, p.4; abs max on enables 6 V; VERIFIED, `docs/research/downloads/lvds-fanout/sn65lvds104.pdf`, SLLS396G). EN1, EN2, EN3 tied to 3V3; EN4 tied to GND (output 4 disabled and Hi-Z). Enables have no documented pull-up, so each is tied (LVDS104 p.4). Supersedes the draft's "EN3 default low": Daniel approved keeping J51 on output 3, so EN3 is high.
- Decoupling: C184 100 nF 0402 and C185 1 uF 0603 from 3V3 to GND at U50 VCC (4). Supply current 23 mA typ, 35 mA max with all four outputs loaded, 3 mA typ / 8 mA max all disabled (LVDS104 p.5, VERIFIED); with output 4 disabled the actual draw is lower but not given, so 35 mA is the bound: 3V3 estimate about 66 mA -> up to about 101 mA, inside the TPS79901 200 mA range (TPS799 SBVS056L; the 200 mA rating was not rechecked in power.md: UNRESOLVED). Fail-safe: with no TLV3605 power the buffer drives a static high on all outputs (LVDS104 p.15-16, VERIFIED); outputs Hi-Z when disabled or VCC < 1.5 V, IOS +-10 mA, outputs abs max -0.5 to 4 V (p.4-5, VERIFIED).
- CAN: `CAN_P` bused to J50 B11 and A11, `CAN_N` to J50 B10 and A10 (hierarchical, from the Controller's SN65HVD230). DNP split termination R182/R183 60.4 ohm + C180 4.7 nF stays for single-module bench use; the termination is at the FPGA-end breakout only (SLLA270 p.4, p.8 Fig. 10). Two bused cable pairs give about 45 ohm in parallel, acceptable at the slowed edges (PROPOSED).
- ESD: two `TPD6E05U06RVZ` (USON-14, 1 x 2.5 mm; 0.47 pF typ, VRWM 5.5 V, VBR 6.5-8.5 V, leakage 10 nA max, TPD Table 5.4 p.7, VERIFIED; I/O pins D1+/D1-/D2+/D2-/D3+/D3- on pins 14, 13, 12, 11, 9, 8, GND pins 5 and 10; pins 1, 2, 3, 4, 6, 7 are NC "used for optional straight-through routing, can be left floating or grounded", SLVSBO7O rev O Table 4-3 p.5, VERIFIED; since 2026-10-16 the lab-library symbol stacks them as hidden passive pins on the opposite I/O pins: 1 on 14, 2 on 13, 3 on 12, 4 on 11, 6 on 9, 7 on 8, KLC S4.3, so each NC pad carries the same net as its opposite pad and the trace can run connector pad -> I/O pad -> under the body -> opposite pad -> onward, PROPOSED layout rule, TI Fig. 7-11 p.17; U51 pad 2 shares the unconnected net of spare pin 13; the 12 extra pad connections show as DRC unconnected until routed) placed within a few mm of J50 (TPD p.5). New lab-library symbol and USON-14 footprint (copy of bundled `Package_SON:Texas_R-PUSON-N14`, compare with the TI drawing: UNRESOLVED). Channel assignment (explicit, PROPOSED; 11 channels used, one spare):

| Channel | U51 (lower end of J50) | U52 (upper end of J50) |
|---|---|---|
| D1+ (pin 14) | CC1 (A5) | LVDS_OUT1_P (U50 1Y; to SSTXn2 B3) |
| D1- (pin 13) | spare (no_connect) | LVDS_OUT1_N (U50 1Z; to SSTXp2 B2) |
| D2+ (pin 12) | LVDS_OUT2_P (SSTXn1, A3, U50 2Y) | CAN_P at SSRXp2 (A11) |
| D2- (pin 11) | LVDS_OUT2_N (SSTXp1, A2, U50 2Z) | CAN_N at SSRXn2 (A10) |
| D3+ (pin 9) | CAN_N at SSRXn1 (B10) | CC2 (B5) |
| D3- (pin 8) | CAN_P at SSRXp1 (B11) | AUX_CAB (SBU, A8/B8) |

Revision note (2026-10-16, Daniel, KiCad GUI): J51 debug pair flipped (2 = LVDS_DBG_N, 3 = LVDS_DBG_P); CAN_H/CAN_L renamed CAN_P/CAN_N (CANH/CANL) and USB_DM renamed USB_DN so the KiCad diff-pair router pairs them, no electrical change; the straight-through NC pins of U51/U52 are stacked on the I/O pins (ESD bullet above).

Layout note (2026-10-09, hand edit after placement started): the original split (U51 = both TX pairs and both CC, U52 = both CAN pairs and SBU) was replaced by a split by position along the J50 pad rows, because the two cable orientations put the same function at opposite ends of the receptacle (A2/A3 and B11/B10 at one end, B2/B3 and A11/A10 at the other). Each device now sits at one end of the pin rows and clamps only the pins next to it, so every protected line runs connector pad -> clamp pad -> destination without a detour past the other device. Nets are unchanged; only which clamp sits on which pad moved. Both devices are placed with the I/O side (pins 14 to 8, top to bottom) facing J50, each level with its end of the pad rows. Pin order follows the pads: the A-row pads are SMD at 0.5 mm pitch and get straight top-layer traces, so they are assigned to the pins level with them and in the same top-to-bottom order (U52: A11/A10 on 12/11, A8 on 8; U51: A5 on 14, A3/A2 on 12/11). The B-row pins are through-hole and reach their clamp pins by an inner-layer trace and a via at the pad, so their alignment matters less (U52: B2/B3 on 14/13, B5 on 9; U51: B10/B11 on 9/8). ESD channels are identical, so pair polarity is free: U51 carries N above P and L above H because that is the order of A3/A2 and B10/B11 at the lower end of the receptacle.

  Excluded: TI ESD122 (VRWM +-3.6 V) and Nexperia PUSB3FR4 (VI max 3.3 V) clamp or conduct below the 5 V levels on CC, SBU and CAN. UNRESOLVED: unidirectional clamps conduct near -0.7 V; with up to 0.4 V of cable GND drop check the CAN common-mode excursion against that clamp. USBLC6-2SC6 on D+/D- stays on the Controller sheet (full speed; place it near J50 at layout).
- J51 Conn_01x06 "DEBUG / scope header" (Daniel kept it, 2026-10-09; PROPOSED pin map): 1 GND, 2 LVDS_DBG_N (U50 pin 11, 3Z), 3 LVDS_DBG_P (U50 pin 12, 3Y), 4 CAN_P, 5 CAN_N, 6 AUX (pair flipped 2026-10-16 for layout, VERIFIED against the exported netlist). R177 100 ohm DNP across pins 2/3 (UNRESOLVED whether an unloaded output 3 is acceptable; LVDS104 is characterised with 100 ohm loads). RSSI, HV_MON, 3V3, 3V3_D stay on test points TP50-TP55 (3V3, 3V3_D, RSSI, HV_MON, GND x2).
- Removed: the Wuerth 61201221621 12-pin J50, R187's AUX2 role, `+5V_CABLE`, AUX2, the old J51 pin map, the DNP 100 ohm bench pad R180 (R180 is now the fitted U50 input termination).
- Designators on this sheet: R170 shield 1 M DNP (removed 2026-10-22), R177 J51 100 ohm DNP, R180 U50 termination, R181 Rd CC1, R182/R183 CAN DNP, R184 Rd CC2, R185 CC1 series, R186 AUX, R187 CC1 shunt, R188 CC2 series, R189 CC2 shunt; C180 CAN DNP, C181 shield (removed 2026-10-22), C182 CC1 tap, C183 CC2 tap, C184 and C185 U50 decoupling; U50 fan-out, U51 and U52 ESD; J50, J51. Passive sizes: 0603 default, 0402 for C184, 0805 bulk. No collision with the Slicer (R80-R99/C80-C99, so R87/C87 and R56-R59/C53-C55 are in other ranges).
- Text: cable table, cable rule (passive full-featured, USB 3.2 Gen 1, 3 A, e-marked, <= 2 m certified; 3 m only after a bench check of the specific cable: DC continuity of the SS wires then a scope of LVDS and CAN; TC Table 3-1 p.44, TC 3.4.1.1 p.83, TC 4.4.1 p.151), labelling ("USB-C: USB 2.0 and 5 V only on a host; SuperSpeed pairs carry proprietary LVDS/CAN, not USB 3"; the module is not USB 3 compliant), CAN rule (no module termination, 125 kbit/s PROPOSED), HV rule.

---

## 7. Controller (`controller.kicad_sch`)

Pins: in 3V3_D, HV_MON, RSSI, VTH_MON, VBUS, USB_DP, USB_DN, CC1_SENSE, CC2_SENSE; out DAC_TH, DAC_HV, HV_DIS, SHDN_N, LE_HYS, TIA_CTRL; bidirectional CAN_P, CAN_N, AUX. (Revision 4: PWR_SRC in, VBUS out and AUX2 are removed; VBUS becomes an input.)
- As built (revision 1) with these changes: MCP4728 OUTA -> `DAC_A` test pad only (spare; DAC_GAIN is gone), OUTB = DAC_TH, OUTC = DAC_HV, OUTD = `DAC_D` test pad. ADS1115: AIN0 = HV_MON, AIN1 = RSSI, AIN2 = VTH_MON, AIN3 = GND through its RC (spare, the ADC zero check). GPIO map: HV_DIS = IO0, SHDN_N = IO1, I2C IO2/IO3, IO4 = CC1_SENSE and IO5 = CC2_SENSE (revision 4), LDAC IO6, AUX IO7 (through R204 1 k), LE_HYS IO14, IO15 no_connect (strapping pin), TIA_CTRL = IO20 (output, Hi-Z at reset is fine because the Front End pull-up makes it 20 k), CAN TX/RX IO19/IO18 (swapped 2026-10-10 for layout; was IO18/IO19), DAC_RDY IO22, STATUS LED IO23, USB IO12/13, UART IO16/17, BOOT IO9, IO8 pull-up, IO21 no_connect (AUX2 and its R187 are gone; free for later, for example an LVDS-enable override: UNRESOLVED, not proposed). Remove the LOS and PGOOD_VGA labels and the VSPAN/VG/VMID inputs.
- Revision 4 USB: J60 (16-pin USB4105) is removed; the receptacle is J50 on the Connector sheet. USB_DP and USB_DN arrive as hierarchical inputs. U61 USBLC6-2SC6 stays on `USB_DP`/`USB_DN` with its VBUS pin 5 on the hierarchical input `VBUS`; R193/R194 22 R (and DNP C206/C207) unchanged on the ESP32 side. R200/R201 (Rd), R202/C193 (shield), R215/R216/C205 (VBUS_SENSE) and PWR_FLAG #FLG60 are removed from this sheet (Rd and shield moved to the Connector sheet with new designators; the root carries the single PWR_FLAG #FLG04 on VBUS). UNRESOLVED: USBLC6-2SC6 VBUS-pin clamp behaviour not verified (ST datasheet not read); VBUS surge protection is the eFuse U5 (21 V abs max, TPS2596 p.5), not the USBLC6.
- CC sense: `CC1_SENSE` -> U60 pad 9 (IO4, ADC1_CH4), `CC2_SENSE` -> U60 pad 10 (IO5, ADC1_CH5), replacing the VBUS_SENSE and PWR_SRC connections; the 100 k/100 k/100 nF networks are on the Connector sheet. The only ADC range read is ATTEN2, 0-1.9 V with total error +-23 mV after calibration (ESP32-C6 datasheet v1.5 Table 5-6 p.66); it covers the 1.02 V maximum at the pin. Referred to the CC pin the error is +-46 mV against class-edge margins of about 20-25 mV at the pin after the halving, so classification is thin: firmware requires three consecutive agreeing reads across more than tRpValueChange (10-20 ms, TC R2.0 Table 4-31 p.239-240). UNRESOLVED: whether a finer attenuation range exists and its accuracy (check the TRM ADC chapter before layout). IO4/IO5 are MTMS/MTDI strapping pins that only select SDIO sampling edges (MINI-1 datasheet Table 4-4 p.14); SDIO unused, PROPOSED harmless. UNRESOLVED: ESP32 clamp-injection current for a fault on the CC taps (no separate GPIO abs max, input high max VDD + 0.3 V, Table 5-4 p.65).
- D+/D- series R193/R194 22R (ESP32-C6 Hardware Design Guidelines (HDG) PDF p.18 section 1.3.13: reserve 22/33 ohm and capacitors to ground; MINI-1 datasheet v1.5 Fig. 9-1 p.40 leaves them TBD). C206 and C207 (DNP, C_0402_1005Metric_N, value TBD on the first board) from USB_E_DP and USB_E_DN (named USB_DP_E/USB_DN_E until 2026-10-22) to GND on the module side of R193/R194. PROPOSED. UNRESOLVED: effect of 22 ohm with the USBLC6 untested; auto-reset (below) untested through them.
- Buttons (new lab part, library PR required: AharoniLab_Switch category, symbol PTS810, footprint AharoniLab_Switch_SMD:SW_SPST_PTS810): SW60 RESET from EN to GND, SW61 BOOT from BOOT (IO9) to GND. TP60/TP61 stay in parallel. R190 10k + C190 1u is the reset debounce and the recommended EN RC (MINI-1 datasheet p.40, HDG p.10); no series resistor, no extra capacitor on IO9. Download Boot is GPIO9 = 0 with GPIO8 = 1 at EN rising (MINI-1 datasheet Table 4-3 p.13; HDG p.15 Table 4), VERIFIED. Fit both buttons even though RTS/DTR auto-reset exists (TRM v1.2 PDF p.1030 Table 32.3-2): recovery for empty flash or a disabled USB PHY (HDG p.30). UNRESOLVED: EN-side ESD diode (optionally a DNP TPD1E10B06 footprint); the eFuse dVdt ramp (about 5.3 ms estimated) versus the 10 ms EN RC.
- CAN transceiver U64 SN65HVD230D: R199 (RS to GND) changes from 10 k to 100 k. Reason: slower edges for stubs up to 3 m. With 10 k the datasheet rise time is 80/120/160 ns (HVD230 SLOS346O p.8) and the SLLA270 p.9 rule (stub <= 1/3 of the critical length at 5 ns/m) allows only about 2.7 m at the minimum edge; with 100 k the rise time is 600/800/1200 ns (HVD230 p.8) and the same rule allows at least 20 m, with t(LOOP) 535-990 ns still about 12 % of the 8 us bit at 125 kbit/s (datasheet numbers VERIFIED, arithmetic PROPOSED). Bench-verify (G4). HVD230 CANH/CANL tolerate -4 to 16 V and +-25 V transient (p.5) and have 20-50 kohm input resistance per pin (p.7), three orders above a USB 3 receiver termination of 18-30 ohm (TUSB1002 p.8, secondary source), so a USB 3 host should not detect a receiver (PROPOSED; USB 3.2 spec not obtained, UNRESOLVED).
- Pin map additions: 9 IO4 CC1_SENSE; 10 IO5 CC2_SENSE; IO15 and IO21 no_connect.
- Firmware states (decision 14, PROPOSED; detail in `firmware/esp32/README.md`): `cc_class` (`default`, `1.5A`, `3.0A`, `none`) and `cc_orient` (`cc1`, `cc2`, `none`) are logged hints; `usb_host` = USB Serial/JTAG SOF seen (TRM v1.2 section 32.5 p.1035). The definitive "system" indicator is LINK_ALL from the FPGA master, listened for at every boot (about 1.5 s or longer). Mode table: LINK_ALL yes -> `bus`; LINK_ALL no, SOF yes -> `usb` standalone (stepped HV start); neither, class 1.5 A -> `usb` until LINK_ALL arrives, then `bus`; neither, no Rp -> `usb` with a warning. CAN TX stays silent (RS high or listen-only) until bus traffic or the FPGA master is seen, so a lone module on a laptop never transmits into the host's SS receive pair. Rp class and orientation never gate HV; the ESP32 must not clear HV_DIS on the basis of these inputs alone. The eFuse limit (about 0.76 A) can reset the module, so the boot log records the reset reason. UNRESOLVED: firmware policy for the D+ pull-up backdrive into an unpowered host (override register, TRM p.1042); self-test cannot prove the comparator or LVDS output without an FPGA or optical source; ground offset between laptop and FPGA supply not analysed.
- Text: update the pin map table and the role text (decision 12: firmware range trim = DAC_HV + TIA_CTRL from RSSI and FPGA validity; module runs unprogrammed at 20k and the resistor-set bias [superseded 2026-10-22, decision 21: no resistor-set bias exists, an unprogrammed module is dark]; decision 14 USB and CC role).

---

## 8. Root (`root.kicad_sch`, revision 4)

- Sheet-symbol pins and wires follow the hierarchical-net table above. Connector drives `VBUS` to Power (U5 IN) and Controller (U61 pin 5); `USB_DP`/`USB_DN`, `CC1_SENSE`/`CC2_SENSE` and `AUX` run Connector <-> Controller; `LVDS_P`/`LVDS_N` Slicer -> Connector; `CAN_P`/`CAN_N` Controller <-> Connector.
- PWR_FLAG `#FLG04` on the `VBUS` net (power_out is the eFuse OUT inside Power; VBUS itself needs the flag at the root). `#FLG60` removed. Nets `+5V_CABLE`, `PWR_SRC`, `AUX2` and the old Controller -> Power `VBUS` wire are deleted.
- Generator order unchanged: power, frontend, slicer, control, connector, controller, root.
