daharoni/photodiode-lvds-receiver/docs/schematic/controller.md

# Controller sheet (`controller.kicad_sch`, as built, revision 4 / decisions 12, 13 and 14)

Generator: `hardware/pcb/receiver-module/gen/controller.py`. Spec: `docs/schematic/rev-a-sheet-specs.md` section 7.

## Role (PROPOSED)
Slow trims and housekeeping only, never the data path: range trim (DAC_HV toward the Q(M) optimum; TIA_CTRL 20k/5k scheduling from RSSI and FPGA validity), threshold trim (DAC_TH, read back on VTH_MON), HV gating (HV_DIS; HV_MON readback), module identity and status over CAN. Hierarchical pins: in 3V3_D, HV_MON, RSSI, VTH_MON, VBUS, CC1_SENSE, CC2_SENSE; out DAC_TH, DAC_HV, HV_DIS, SHDN_N, LE_HYS, TIA_CTRL; bidirectional USB_DP, USB_DN, CAN_P (CANH/CANL; renamed from CAN_H/CAN_L 2026-10-16 so the KiCad diff-pair router pairs them), CAN_N, AUX (revision 4: PWR_SRC in, VBUS out and AUX2 removed; VBUS is now an input; USB_DP/USB_DN are drawn bidirectional as on the Connector sheet).

Unprogrammed ESP32 (decision 21): the signal path is firmware-free but the module is dark. TIA_CTRL floats and the Front End pull-up gives 20 k; SHDN_N pull-up keeps the comparator on. HV_DIS is pulled up on the Power sheet, so an unprogrammed module has NO APD bias and decodes nothing; bench jumper J1 (HV FORCE ON, Power sheet) forces it on, and is fitted only after a first firmware boot has provisioned the DAC (decision 20). Facts and citations: `docs/research/module-controller.md` (section numbers below). Status labels: VERIFIED (datasheet cited), PROPOSED, UNRESOLVED. Nothing here is measured or simulated; ERC and netlist export only (kicad-cli 10.0.5, scratch copy of the project with the root pointing at this sheet).

## Parts
| Ref | Part | Notes |
|---|---|---|
| U60 | ESP32-C6-MINI-1 | 3V3_D with C191 10u 0805 + C192 100n 0402 at pad 3; EN: R190 10k + C190 1u + TP60 + SW60 RESET to GND; BOOT (IO9): R191 10k + TP61 + SW61 BOOT to GND; IO8: R192 10k |
| U61 | USBLC6-2SC6 | on USB_DP/USB_DN (hierarchical, from J50 on the Connector sheet); pin 5 = hierarchical input VBUS (U61 only); D+/D- via R193/R194 22R, DNP C206/C207 (0402, value TBD) from USB_E_DP/USB_E_DN to GND on the ESP32 side. Net names (2026-10-22, so KiCad pairs them): U61 -> R193/R194 is USB_ESD_DP/USB_ESD_DN (previously unnamed), R193/R194 -> U60 is USB_E_DP/USB_E_DN (previously USB_DP_E/USB_DN_E); all in USB90. Layout (Daniel, 2026-10-22): R193/R194 and C206/C207 sit at U60 pads 18/17, U61 stays at J50, per the HDG p.18 "close to the chip" (PROPOSED). 22R: ESP32-C6 Hardware Design Guidelines p.18 section 1.3.13 (reserve 22/33 ohm and capacitors to ground), MINI-1 datasheet v1.5 Fig. 9-1 p.40 leaves them TBD: PROPOSED; effect with USBLC6 untested: UNRESOLVED. USBLC6 VBUS-pin clamp behaviour not verified (ST datasheet not read); VBUS surge protection is the Power-sheet eFuse U5 (21 V abs max, TPS2596 p.5). J60, R200/R201 (Rd), R202/C193 (shield), PWR_FLAG #FLG60 and the VBUS_SENSE parts are removed (the Rd and shield moved to the Connector sheet). Place U61 near J50 at layout |
| SW60, SW61 | AharoniLab_Switch:PTS810SJM250SMTRLFS, footprint SW_SPST_PTS810 | RESET (EN to GND), BOOT (IO9 to GND); fitted although RTS/DTR auto-reset exists (TRM v1.2 p.1030 Table 32.3-2) for recovery from empty flash or a disabled USB PHY (HDG p.30). Download boot = GPIO9 0 with GPIO8 1 at EN rising (MINI-1 datasheet Table 4-3 p.13; HDG p.15 Table 4): VERIFIED. R190/C190 is the recommended EN RC (MINI-1 datasheet p.40, HDG p.10); no series resistor, no capacitor on IO9. UNRESOLVED: EN-side ESD diode; the eFuse dVdt ramp (about 5.3 ms estimated) versus the 10 ms EN RC. Library part is on branch add-tactile-switch |
| (Connector sheet) | CC taps 100k/100k/100 nF | CC1_SENSE -> U60 pad 9 (IO4, ADC1_CH4), CC2_SENSE -> pad 10 (IO5, ADC1_CH5); the VBUS_SENSE divider R215/R216/C205 is removed. Only the 0-1.9 V ATTEN2 range is read, +-23 mV after calibration (ESP32-C6 datasheet v1.5 Table 5-6 p.66); referred to the CC pin +-46 mV against class-edge margins of about 20-25 mV, so classification is thin and firmware requires three agreeing reads across more than tRpValueChange (TC R2.0 Table 4-31 p.239-240). UNRESOLVED: finer attenuation range (check the TRM ADC chapter); clamp-injection current for a fault on the taps (input high max VDD + 0.3 V, Table 5-4 p.65) |
| U62 | MCP4728T-E_UN | 0x60; OUTA/B/C/D = DAC_A (test pad TP68, spare) / DAC_TH / DAC_HV / DAC_D (test pad TP69) each through 100R + 100n (R210-R213, C201-C204) |
| U63 | ADS1115IDGSR | 0x48 (ADDR = GND); AIN0..3 = HV_MON, RSSI, VTH_MON, GND (AIN3 spare, tied to GND through R209) each through 10k + 10n (R206-R209, C197-C199; C200 DNP since 2026-10-23, it had both pins on GND because AIN3 is tied to GND through R209); ALERT/RDY no_connect |
| U64 | SN65HVD230D | RS = R199 91k to GND (was 100k until 2026-10-23, decision 32; SN65HVD230 slope control: the datasheet gives 10k = about 15 V/us and 100k = about 2 V/us as examples and V(Rs) > 0.75 VCC enters standby, so 100k sat at the top of the characterised range; 91k keeps the slow slope with margin; PROPOSED. Earlier, was 10k: rise time 600/800/1200 ns, HVD230 SLOS346O p.8, so the SLLA270 p.9 stub rule allows at least 20 m against about 2.7 m at 10k; t(LOOP) 535-990 ns is about 12 % of the 8 us bit; datasheet numbers VERIFIED, arithmetic PROPOSED; bench-verify at G4); Vref_OUT no_connect; CAN_P/CAN_N hierarchical; no termination on the module |
| D60 | LED + R203 1k | status, IO23 |

## Pin map (U60 pad: GPIO -> net) - PROPOSED
5 IO2 SDA; 6 IO3 SCL; 8 EN; 12 IO0 HV_DIS; 13 IO1 SHDN_N; 15 IO6 LDAC; 16 IO7 -> R204 1k -> AUX; 17 IO12 USB_D- ; 18 IO13 USB_D+; 19 IO14 -> R205 0R (DNP) -> LE_HYS; 22 IO8 strap; 23 IO9 BOOT; 24 IO18 CAN_RX; 25 IO19 CAN_TX (swapped by hand edit 2026-10-10 for layout; TWAI TX/RX are GPIO-matrix signals, both plain GPIOs); 26 IO20 -> R214 2.2k -> TIA_CTRL (hierarchical output; the net at pin 26 is Net-(U60-GPIO20), R214 pin 1 is on /TIA_CTRL; the pull-up is on the Front End; R214 added 2026-10-23 because TIA_CTRL was a bare GPIO tie onto the JP10 solder-jumper net, B = 3V3, A = GND, and a bridged jumper against a GPIO driven the other way shorted the pin: 2.2k limits that to about 1.5 mA, PROPOSED); 27 IO21 no_connect (AUX2 removed along with the old R214, whose designator is reused above, free for later: UNRESOLVED, not proposed); 28 IO22 DAC_RDY; 29 IO23 STATUS; 30 IO17 RXD0 (TP63); 31 IO16 TXD0 (TP62); 9 IO4 CC1_SENSE (hierarchical input); 10 IO5 CC2_SENSE (hierarchical input). IO15 and IO21 are no_connect. IO4/IO5 are strapping pins (MTMS/MTDI) that only select SDIO sampling edges (MINI-1 datasheet Table 4-4 p.14); SDIO unused, PROPOSED harmless.

Firmware states (PROPOSED; `firmware/esp32/README.md`): `cc_class` and `cc_orient` are logged hints, `usb_host` = USB Serial/JTAG SOF seen (TRM v1.2 section 32.5 p.1035); the definitive system indicator is LINK_ALL from the FPGA master. CAN TX stays silent until bus traffic or the FPGA master is seen. The ESP32 must not clear HV_DIS on the basis of CC levels alone. UNRESOLVED: firmware policy for the D+ pull-up backdrive into an unpowered host (TRM p.1042); the self-test cannot prove the comparator or LVDS output without an FPGA or optical source; ground offset between laptop and FPGA supply not analysed; the eFuse limit (about 0.76 A) can reset the module, so the boot log records the reset reason.

## Deviations from the spec
- IO10 and IO11 do not exist on the MINI-1 (MINI datasheet v1.5 Table 3-1, p10-11: 22 GPIOs). LDAC moved to IO6 (pad 15) and AUX to IO7 (pad 16). These are the JTAG MTCK/MTDO pins; USB-Serial-JTAG is the debug path, so external JTAG is given up. PROPOSED.
- ESP32-C6 (U60), USBLC6 (U61) and SN65HVD230 (U64) power pins sit on the opposite side of the symbol from what a first reading suggests (3V3/VBUS/VCC on top, GND at the bottom); wiring follows the library symbols.
- IO15 is a strapping pin, so TIA_CTRL uses IO20 (the old LOS input). The TP numbering stays within TP60-TP69; the status LED has no test pad.
- The ADS1115 ALERT/RDY pin is a no_connect (spec item: IO23 is the LED).
- DAC rows use local nets DACO_A..D before the RC filter; the filtered OUTA/OUTD nets are `DAC_A` (TP68) and `DAC_D` (TP69).

## ERC
Revision 4 root ERC (kicad-cli 10.0.5, 2026-10-09): 0 errors, 0 warnings. Netlist: 55 components on /Controller/. VBUS = U61 pin 5 (with J50 A4/A9/B4/B9, Power U5 IN, R35, C33); USB_DP = U61 pin 1 and J50 A6/B6; USB_DN = U61 pin 3 and J50 A7/B7; CC1_SENSE = U60 pad 9; CC2_SENSE = U60 pad 10; AUX = R204 pin 2 and R186; SW60 pins 1/2 = GND / EN; SW61 = GND / BOOT. Not measured or simulated.

## Review MINOR set, 2026-10-23 (decision 32; hand edit with KiCad closed, PROPOSED)
- R199 100k -> 91k (see the U64 row). C200 10n -> DNP (see the U63 row; R209 stays). New R214 2.2k 0603 (AharoniLab_Passive:R_Small_US, AharoniLab_Resistor_SMD:R_0603_1608Metric_N) between U60 IO20 and TIA_CTRL. Reference designators used on this sheet now include R214.
- Decided, no change: R33 100k pull-up stays on 3V3_D (see power.md, Revision 5). Deferred: VBUS TVS ahead of the eFuse (needs a lab-library part).
- ERC 0 errors, 0 warnings after the edit (whole project); the netlist counts above are from 2026-10-09 and gain one part (R214).

## UNRESOLVED
USB series resistor values; auto-reset into download mode over USB (confirm on first board); firmware range-trim and TIA_CTRL scheduling algorithm; (DAC_TH safe default direction and DAC_HV EEPROM default: resolved by decision 20, a blank MCP4728 gives code 0 = maximum bias and a -16 mV threshold offset, HV_DIS keeps HV off and the firmware provisions the EEPROM at first boot; verification by the Read command, DS22187E 5.6.9 p.37, General Call Read returns only address bits); measured 3V3_D current; antenna keep-out numbers and -1 versus -1U; VBUS back-feed against the 5 V rail; FPGA-end CAN termination (120 ohm, or 2 x 60 ohm + 4.7 nF, SLLA270 p8).
