daharoni/photodiode-lvds-receiver/docs/schematic/power.md

# Power sheet as-built (`power.kicad_sch`, Rev A0, revision 4)

Generated by `hardware/pcb/receiver-module/gen/power.py` (spec: `rev-a-sheet-specs.md` section 1; bias values: `docs/calculations/apd-bias-design.md` sections 2, 3, 4, 6). Nothing here is simulated or measured; ERC and netlist only confirm connectivity. Datasheets: TPS799 SBVS056L ("TPS"), TPS2596 SLVSET8A ("EF", eFuse U5; page numbers as cited in the spec), TPS7A20 SBVS338H Jul 2024 ("T20", fetched from the library symbol URL, not in docs/datasheets/), OPA855 SBOS622D ("OPA855", load estimate only), LT8365 Rev. A ("LT"). Page numbers are PDF pages.

## Layout
Top-left block (revision 4): U5 TPS259631DDAR eFuse with the R35/R36/R37 UVLO/OVLO chain, R38 ILM (TP3 IMON), C32 dVdt, C33 on VBUS, FLT with TP4 and DNP pull-up R39; hierarchical input VBUS. Top band: +5V (U5 OUT) caps, U1 3V3 and U4 3V3_D side by side; local label +5V replaces the former hierarchical input. Bottom band (moved up 60.96 mm after the LM27762 block was removed): U3 controller (left), power stage and doubler (centre), clamp, filter stage 1 and APD_BIAS (right), HV_MON chain (top right), support networks (EN divider + Q3 gate / J1, SYNC, BIAS, RT, SS, VC, DAC leg, FBX divider, pot leg) in two rows underneath. Local labels: 3V3_D (pull-up R33), V3_FB, HV_V1, HV_PUMP, HV_RAW, HV_OUT, HV_CLAMP, 5V_HVIN, EN, SYNC, BIAS, RT, SS, VC, FBX. APD_BIAS is the HV_FILT node.

## Values and status
| Block | Value | Status / citation |
|---|---|---|
| +5V (U5 OUT) | C1 10 uF 0805 10 V, C2 100 nF | PROPOSED (spec 1.1) |
| U5 eFuse | TPS259631DDAR (library symbol footprint `Texas_DDA-R-PDSO-G8_SO-PowerPAD-8_3.9x4.9mm_P1.27mm_EP2.4x3.1mm`): IN pin 4 = VBUS, OUT pin 5 = +5V, GND pin 1 and EP pin 9 = GND | Pin map VERIFIED against TPS2596 (EF p.4); x1 auto-retry variant (Device Comparison p.3); abs max on IN 21 V (p.1, p.5). Lab-library PR #61 supplies the symbol. PROPOSED |
| U5 UVLO/OVLO | R35 357k IN -> EN/UVLO, R36 43.2k EN/UVLO -> OVLO, R37 100k OVLO -> GND, 1 % | PROPOSED, calculated not simulated: overvoltage cut-off 5.76-6.20 V rising (below the TPS799 7.0 V abs max, SBVS056L p.4), UVLO 4.06-4.32 V rising, 3.72-4.00 V falling |
| U5 limit | R38 1.21k 1 % ILM to GND; TP3 IMON on ILM | ILIM 0.68 / 0.76 / 0.84 A min/typ/max (EF Eq. 5 p.22); about 0.79 V/A on ILM. A real current limit, not the 0.5 A USB budget. PROPOSED |
| U5 dVdt | C32 47 nF X7R 10 V 0603 | about 5.3 ms ramp, about 23 mA inrush into an assumed 25 uF on +5V (estimate, measure in G1). PROPOSED |
| U5 FLT | pin 6 open-drain, TP4; R39 100k pull-up to 3V3_D, DNP | UNRESOLVED: both rails are off while the eFuse is cut off, so a pull-up cannot separate fault from no power; FLT is not routed to the ESP32; FLT pin abs max not read |
| U5 input cap | C33 4.7 uF 25 V X5R 0805 on VBUS at IN | PROPOSED. Margin (arithmetic): a compliant 3 A cable drops at most 75 mV at 0.3 A (TC R2.5 4.4.1 p.151), so the module sees at least about 4.66 V against UV rising 4.06-4.32 V; a non-compliant 28 AWG 3 m cable would leave about 4.37 V: UNRESOLVED (cable rule, decision 14) |
| U1 | R1 18.7k / R2 10.0k, VFB 1.193 V -> 3.42 V nominal (was 17.8k, 3.32 V, 2026-10-23); EN tied to IN; CIN 1 uF; COUT 2 x 4.7 uF | VFB VERIFIED (TPS p.5, EC table 1.169/1.193/1.217 V); divider PROPOSED. Window with the 2 % overall accuracy (VFB 1.169 to 1.217 V, `docs/datasheets/tps799.pdf` electrical characteristics) plus 1 % divider parts: about 3.34 to 3.50 V (was 3.25 to 3.38 V, below the OPA855 3.3 V minimum). PROPOSED |
| U1 CFB | **1 nF** (spec said 10 nF) | VERIFIED rule: CFB required, 3 pF to 1 nF for R1 parallel R2 = 250k, <5 pF for fast start, larger improves noise (TPS p.14, 8.2.2.6). 10 nF is outside the stated range. Here R1\|\|R2 = 6.4k, outside the stated 250k condition: UNRESOLVED, 1 nF is PROPOSED |
| U3 mode | SYNC floating (pulse-skip); R26 100k and R27 0R to GND DNP (Burst+SSFM, Burst); TP2 external clock | Table VERIFIED (LT p.7 SYNC/MODE); choice PROPOSED (calc doc 3.1) |
| U3 BIAS | R28 0R to GND fitted, R29 0R to 5V_HVIN DNP (fit exactly one) | "If unused tie to GND" VERIFIED (LT p.7); option PROPOSED |
| U3 passives | INTVCC 1 uF (LT p.7 "bypassed with 1 uF"), RT 84.5k, SS 0.22 uF, VC 84.5k + 1 nF C0G + 10 pF DNP, EN 20k/20k (was 200k/200k until decision 23; same 2.5 V ratio, 125 uA so the TLV431 limiter can hold the node) | VERIFIED/PROPOSED per calc doc 3.2 |
| Pi filter | C18 10 uF 50 V, L2 0.47 uH (0805 footprint), C19 10 uF 50 V, C20 4.7 uF 50 V | PROPOSED (calc doc 3.2; demo manual p.4) |
| Stage 1 + doubler | L1 10 uH (Wurth 74437324100), D1 straight from SW to HV_V1 (C5); R7 20R from HV_V1 to the D3 anode (pump-charge resistor, as LT p.30 R8 and DC2838A R10; it was wired in series with D1 until 2026-10-22, review S1); C6, D3, D4, C7 0.1 uF 200 V; R30 47R; C25 1 nF 500 V; D2 DFLS1150-7 fitted (was DNP; the LT8365 reference-circuit SW-to-GND clamp, fitted for the first bench build, 2026-10-23) | PROPOSED (calc doc 2, 3.2; LT p.30); R7 position VERIFIED against LT8365 Rev. A p.30 and DC2838A REV02 |
| FBX | R8-R11 4 x 2.05M; R12 86.6k + TH1 10k NTC; DAC leg R13 10k, C27 100 nF, R14 150k (was 442k until 2026-10-22, review S2 / decision 19: DAC alone now 50-219 V at 25 C, code 0 = maximum, LSB 41 mV); pot leg RV1 50k + R15 1M (DNP; was 274k, lowered authority to +/-13.5 V so a fitted pot cannot push the switch node past 150 V); C26 10 pF DNP | PROPOSED (calc doc 3.2, tools/apd_bias_design.py 0 FAIL) |
| Clamp | Q1 MMBTA42 pass, Q4 MMBTA42 Darlington driver (decision 24), Q2 MMBT3904 sense, R16 4.02k, R17+R18 2 x 4.99M 0805 (was 0603; 110 V each at 220 V against the 0805 150 V working rating, Yageo RC0805 spec V0 2016-07-22 p.3; decision 22) | PROPOSED (calc doc 4, 6a); topology checked in netlist below. The single-transistor version dropped Ic x 10 M / hFE at the APD side (about 3 V per 10 uA at hFE 30, invisible to HV_MON, review S5b); the Darlington divides that by a second hFE. MMBTA42 hFE at uA currents UNRESOLVED; G1 item 3b measures the residual |
| Filter 1 | R19 27k 1206 200 V, C8 10 nF 500 V C0G 1210 | PROPOSED (calc doc 4) |
| U4 | TPS7A2033PDBV 3.3 V 300 mA, IN = +5V, EN tied to IN, C29 1 uF 0603 in, C30 10 uF 0805 + C31 1 uF 0603 out -> hier output 3V3_D | Capacitors VERIFIED within the datasheet window: COUT 1 uF min / 200 uF max, effective >= 0.47 uF, CIN 1 uF (T20 p.5 Recommended Operating Conditions and notes; p.23 6.1 "single 1 uF in, single 1 uF ceramic out"). 10 uF + 1 uF therefore needs no change. Rail/load: 300 mA is the part rating (T20 p.1); load about 60 mA is an estimate (module-controller.md section 1): PROPOSED. Dissipation about (5 - 3.3) V x 60 mA = 0.1 W, RthJA(DBV) 187 C/W (T20 p.6) -> about 19 K rise, calculated. Radio MUST stay disabled (Wi-Fi TX 251-382 mA exceeds 300 mA, C6 DS Table 6-4 via module-controller.md); buck is the Rev B option. PROPOSED |
| HV disable gate | Q3 DMN2056U-7 drain on the EN/UVLO node, source GND; gate = HV_DIS through R34 1k; R33 100k pull-up to 3V3_D; J1 Conn_01x02 "HV FORCE ON" (DNP) gate to GND | PROPOSED (decision 11). Logic below. Q3 gate threshold and the EN/UVLO threshold were not rechecked against datasheets here: UNRESOLVED |
| Monitor | R20+R32 2 x 4.99M 0805 (was 0603; 110 V each, 150 V rating as above, decision 22), R21 45.3k + R45 54.9k (100.2k total, was R21 100k alone; the tap between them is OVP_REF), C28 10 nF -> HV_MON = HV_OUT/101.2 | PROPOSED; rating VERIFIED Yageo RC0805 spec V0 p.3 |
| OVP limiter (decision 23) | U6 TLV431A (SOT-23): REF on OVP_REF (0.548 x HV_MON), cathode on EN, anode GND. Trips when HV_MON = 2.263 V, i.e. HV_OUT about 228 V, pulling EN/UVLO to 1.24 V (below the 1.545 V minimum falling threshold, LT p.4) so the converter stops and soft-start resets; the output then sawtooths at the trip level instead of running away after an open FBX ladder resistor or an FBX short. R22/R23 200k -> 20k so the EN node can source the 80 uA minimum cathode current (TLV431 SLVS139Z p.5-7: I_K(min) 80 uA max, I_ref 0.5 uA max into the 24.8k tap = 0.7 V of trip error, VREF 1 %). Trip error budget about +/-3 V; switch node at 228 V = 114 V plus ring, inside 150 V | PROPOSED, calculated; VERIFIED thresholds from the two datasheets; nothing measured |

Reference numbers beyond the spec: R22/R23 EN divider, R33 gate pull-up, R34 gate series, Q3 gate FET, U4 3V3_D LDO, C29-C31 U4 caps, R24 RT, R25 VC, R26/R27 SYNC, R28/R29 BIAS, R30 R_out, R32 second monitor resistor; C9-C12 U1 caps, C18-C20 pi filter, C21 INTVCC, C22 SS, C23/C24 VC, C25 output 1 nF, C26 FBX, C27 DAC, C28 monitor. R41-R44 untouched. Reference numbers R3-R6, R31, C13-C17, C3, C4, FB1, U2 and TP1 are now unused.

## Pin to net (kicad-cli netlist, root sheet)
- U5: 1 GND and 9 EP GND; 2 dVdt C32 to GND; 3 EN/UVLO R35/R36 node; 4 IN /VBUS (C33, R35, Connector J50 A4/A9/B4/B9, Controller U61 pin 5); 5 OUT /Power/+5V; 6 FLT (TP4, R39 to 3V3_D, DNP); 7 ILM (R38 to GND, TP3); 8 OVLO R36/R37 node.
- U1: 1 IN /+5V; 2 GND; 3 EN /+5V; 4 FB V3_FB (R1/R2/C12); 5 OUT /3V3.
- U4: 1 IN /+5V (C29); 2 GND; 3 EN /+5V (tied to IN); 4 NC (no-connect flag); 5 OUT 3V3_D (C30, C31, R33 pull-up; hier output).
- Q3: 1 G net Net-(J1-Pin_1) (R34 pin 1, R33 pin 2, J1 pin 1); 2 S GND; 3 D /Power/EN (U3 pin 1 EN/UVLO, R22, R23).
- U3 pin 1 EN/UVLO = net EN = Q3 drain + R22 bottom + R23 top (200k/200k from 5V_HVIN).
- U3: 1 EN; 3 VIN 5V_HVIN; 5 INTVCC (C21); 6 NC no-connect; 7 BIAS; 8 VC; 9 FBX; 10 RT; 11 SS; 12 SYNC; 14 and 16 SW (D1 anode, L1, C6); 17 GND.
- OVP limiter (since 2026-10-22, decision 23): U6 pin 1 REF = `/Power/OVP_REF` (R21 pin 2, R45 pin 1); pin 2 K = `/Power/EN` (U3 pin 1, Q3 drain, R22, R23); pin 3 A = GND. R21 pin 1 = HV_MON, R45 pin 2 = GND.
- Stage 1 and pump (since 2026-10-22): D1 K = HV_V1 (C5, C7 top, R7 pin 2); R7 pin 1 = `Net-(D3-A)` = D3 anode only; D3 K = HV_PUMP (C6, D4 anode); D4 K = HV_RAW (C7 bottom, R30). The old net `Net-(D1-K)` (D1 K to R7) no longer exists.
- Q4: B = `Net-(Q2-C)` (R18 pin 2, Q2 collector); E = `Net-(Q1-B)` (Q1 base only); C HV_OUT. Q1: B Q4 emitter; E `Net-(Q1-E)` (R16, Q2 base); C HV_OUT. Q2: B Q1 emitter; E HV_CLAMP; C Q4 base. (Before decision 24 Q2's collector and R18 drove Q1's base directly.)

## HV disable logic (decision 11)
| HV_DIS | Q3 | EN/UVLO | HV |
|---|---|---|---|
| high, or ESP32 unprogrammed/Hi-Z (R33 pulls the gate to 3V3_D) | on | pulled to GND through Q3 | OFF |
| low (ESP32 drives it after verifying the DAC) | off | 200k/200k divider = 2.5 V at 5 V | ON |
J1 fitted: gate forced to GND = Q3 off = HV enabled regardless of firmware (bench only, set the DAC first; R34 limits the contention current with a driven-high HV_DIS to 3.3 V/1 k). If 3V3_D is absent the gate has no pull-up and floats: HV state then UNRESOLVED (the 5V rail is the only supply for U3, so 3V3_D normally comes up with it; a 3V3_D-independent pull-up to +5V was not added). PROPOSED, not simulated or measured.

## ERC
Revision 4 root ERC (kicad-cli 10.0.5, 2026-10-09): 0 errors, 0 warnings. +5V has a power_out driver (U5 OUT, pin 5), so no PWR_FLAG is needed on +5V; the root PWR_FLAG #FLG04 sits on VBUS (the Connector output is not a power_out) and #FLG60 is removed from the Controller, so VBUS carries exactly one flag. Not measured or simulated.

## Open points
- Resolved by the HV disable gate: EN/UVLO is always driven by the divider/Q3 (the old floating-EN case is gone).
- UNRESOLVED: D2 purpose not stated (LT p.30); fitted since 2026-10-23 as the reference-circuit SW-to-GND clamp for the first bench build (PROPOSED).
- HV test: nothing on this sheet was measured; layout (guard, 1.0 mm HV netclass, 200 V creepage) is not done.

## Revision 2 (decision 12, 2026-10-08)
Removed: U2 LM27762 (+3V7/-3V7), C13-C17, R3-R6, R31, TP1 (PG_VGA), the 5V_A bead FB1 with C3/C4 and its PWR_FLAG, and the hierarchical outputs +3V7, -3V7, 5V_A, PGOOD_VGA. Reason: the VCA821 VGA and its +/-3.7 V rails are gone; the OPA855 post-amp runs from 3V3. U1, U4, U3 (bias, HV disable gate Q3/J1, HV_MON) are unchanged. Hierarchical pins now: in +5V, DAC_HV, HV_DIS; out 3V3, 3V3_D, APD_BIAS, HV_MON.
3V3 load estimate: OPA857 26.8 mA max + OPA855 19.5 mA max + TLV3605 17.5 mA max + OPA2320 about 2 mA = about 66 mA, against the TPS79901 200 mA rating (TPS rating not rechecked here). OPA855 IQ: 17.8 mA typ, 16 to 19.5 mA over production limits at VS = 5 V (OPA855 SBOS622D PDF p.7, Electrical Characteristics, POWER SUPPLY); Fig. 6-27 (PDF p.12) shows about 16 to 17.5 mA across 3 to 5.25 V, so 19.5 mA is conservative. Estimate, not measured: PROPOSED.

## Revision 3 (decision 13, 2026-10-09)
Added U5 TPS2121RUXR with R35-R42, C32-C34 (see the values table). The +5V hierarchical input is gone: +5V is the internal merged rail (U5 OUT) feeding U1, U4 and U3 via L2; C1/C2 stay on it. Hierarchical pins now: in +5V_CABLE, VBUS, DAC_HV, HV_DIS; out 3V3, 3V3_D, APD_BIAS, HV_MON, PWR_SRC. Budget about 0.19 A worst case (0.24 A with margin) from +5V against 0.5 A USB default and the 1.24 A typ limit (docs/research/usb-standalone-power.md section 1.5; estimate with assumed 70 % LT8365 efficiency, not measured); radio must stay disabled. No back-feed (fast reverse blocking, <= 1 uA leakage, MUX p.7, p.15); switchover about 100 us typ (p.7), hold-up droop about 1 V estimated, not measured: PROPOSED. UNRESOLVED: whether a bus-powered hub or unconfigured device is held to 100 mA; USB-alone HV start must be stepped from the low-bias end (a faulted start can trip a USB port).

## Revision 4 (decision 14, 2026-10-09)
U5 TPS2121 is replaced by the TPS259631DDAR eFuse (see the values table). Removed: TPS2121, +5V_CABLE, PWR_SRC, old R39-R42, C34, the PR1 divider; R35-R39, C32, C33 are reused with new values and roles; new TP3 (IMON) and TP4 (FLT). Hierarchical pins now: in VBUS, DAC_HV, HV_DIS; out 3V3, 3V3_D, APD_BIAS, HV_MON. Budget about 0.19 A worst case from +5V plus up to 35 mA on 3V3 for the LVDS104 fan-out U50 (estimates, not measured); radio must stay disabled. UNRESOLVED: whether a bus-powered hub holds the module to 100 mA ("use a laptop root port or a powered hub"); USB-alone HV start is stepped from the low-bias end. The revision 3 TPS2121 text above is superseded.

## Revision 5 (review MINOR set, 2026-10-23, decision 32; hand edit with KiCad closed, PROPOSED)
- R1 17.8k -> 18.7k 1 %: 3V3 = 1.193 V x (1 + 18.7/10) = 3.42 V nominal, window about 3.34 to 3.50 V (TPS79901 VFB 1.169 to 1.217 V, 2 % overall accuracy, `docs/datasheets/tps799.pdf` electrical characteristics, plus 1 % divider parts). Reason: OPA855 VS minimum is 3.3 V (SBOS622D recommended operating conditions) and the old 3.25 to 3.38 V window dipped below it. VERIFIED against those datasheets; the arithmetic is PROPOSED, nothing measured.
- Ceiling check: OPA857 VS max 3.6 V (SBOS630D recommended operating conditions), SN65LVDS104 VCC 3.0 to 3.6 V (`docs/research/lvds-fanout-and-foreign-host.md` supply row), TLV3605 up to 5.5 V. The 3.50 V worst case clears all three.
- D2 DFLS1150-7 is now fitted (dnp no). It is the LT8365 reference-circuit SW-to-GND clamp, fitted for the first bench build.
- Checked, no change: R33 100k pull-up stays on 3V3_D, not +5V. IO0 (HV_DIS) is Hi-Z at reset (C6 datasheet Table 2-2), so the pull-up holds Q3 on; a +5V pull-up would feed 5 V into a non-5 V-tolerant ESP32 pad. If 3V3_D is absent the ESP32 is unpowered too; that case stays UNRESOLVED as above.
- Deferred: a VBUS TVS ahead of the eFuse needs a part (none in the lab library; a 5 V SMF/SMAJ class TVS). Not added. UNRESOLVED.
