daharoni/photodiode-lvds-receiver/docs/schematic/slicer.md

# Slicer sheet as-built (`slicer.kicad_sch`, revision 2, decision 12; text notes updated for decision 14)

Generated by `hardware/pcb/receiver-module/gen/slicer.py` (spec: `rev-a-sheet-specs.md` section 3; basis `docs/research/post-amp-slicer.md`). Nothing here is simulated or measured. Datasheet: TLV3604/3605/3607, SNOSDA2F, "DS" below (printed pages).

Hierarchical pins: in SDET_P, VCM_REF, DAC_TH, 3V3, SHDN_N, LE_HYS; out LVDS_P, LVDS_N, VTH_MON.

## Circuit
- IN+ (4) = SDET_P (already AC coupled and returned to VCM_REF through R59 1k on the Front End sheet). IN- (6) = SDET_N: R84 1k from VCM_REF; DAC_TH through R85 100k; C84 10n to GND; VTH_MON through R86 10k; TP20 (SDET_N). TP21 SDET_P is DNP.
- Trim authority (derived): (DAC - VCM_REF) x 1k/101k; 0 to 3.3 V with VCM_REF 1.65 V gives +-16.3 mV, 8 uV per 12-bit LSB. R84 matches the 1k on IN+ so bias currents cancel: IB -1 uA typ / +-5 uA max, IOS +-1 uA (DS p.7); research section 1.
- External hysteresis (PROPOSED): R87 5.49k in series with C87 "100pF C0G" (dielectric stated in the Value field 2026-10-23) from OUT+ to IN+. OUT+ swings 350 mVpp (VOD 350 mV typ, 250-450; VOCM 1.2 V, 1.125-1.375; DS p.7; LVDS into the FPGA's 100 ohm, `docs/research/ulx3s-lvds-input.md`). Source at IN+ during an edge = R56 49.9 || R59 1k = 47.5 ohm (the coupling cap is a short at 50 MHz). Window = 350 mV x 47.5/(5490 + 47.5) = 3.0 mV. C87 is added because a bare resistor would also feed the DC level: (1.2 - 1.65) x 1k/(1k + 5.49k) = -69 mV static shift of IN+. With C87: corner 1/(2 pi x 5.54k x 100p) = 287 kHz, tau 554 ns, 83 % of the window left after a 100 ns run (5 UI). The spec's "about 100k with a 1k source" is the slow-state value only: it gives 3.5 mV in held states but 0.17 mV at 50 MHz edges, so it was not used. UNRESOLVED: jitter and noise effect not simulated.
- LE/HYS (8) is left open (internal hysteresis 0 mV, latch off; DS p.8). Checked 2026-10-23 (review MINOR, decision 32): open LE/HYS is a datasheet-characterised condition (SNOSDA2F electrical characteristics: VHYST = 0 mV for RHYST = Floating), VERIFIED, so no change; the smallest characterised internal setting is about 8 mV (Fig. 7-4, p.16). R82 150k to GND and R83 0R to LE_HYS are DNP footprints.
- SHDN (7): R81 10k to 3V3, SHDN_N active low (VIH 1.5 V, VIL 0.4 V, DS p.8); shutdown is not a guaranteed zero output (standing correction 11).
- VCCI (2) = 3V3 with C80 100n 0402 + C81 1u; VCCO (1) = 3V3 through R80 0R with C82 100n 0402 + C83 1u; PWR_FLAG on the VCCO net (R80 is passive); supply 2.4 to 5.5 V (DS p.19). VEE and EP = GND (no pad requirement given beyond the ground plane).
- Revision 4 (decision 14): LVDS_P/LVDS_N now go to the fan-out buffer U50 on the Connector sheet. The 100 ohm termination R180 (0.1 %, fitted) sits across U50 A/B, a few cm away (the buffer has no on-chip termination, LVDS104 SLLS396G p.16 Fig. 25), and the ECP5 end keeps its on-die termination. The load seen by the TLV3605 is still 100 ohm, so the R87/C87 hysteresis tap and the 3.0 mV window are unchanged. No schematic change here, only the sheet text; nothing on this sheet references the old DNP bench pad (it was on the Connector sheet). PROPOSED.
- Polarity: light on pulls SDET_P below the baseline (OPA857 output swings down, SBOS630D p.19), so LVDS_P is low for a one; invert or swap pairs at the FPGA.

## U20 pin to net
1 VCCO = 3V3 through R80 (Net-(U20-VCCO)); 2 VCCI = 3V3; 3, 5, 9, 11 VEE = GND; 4 IN+ = SDET_P; 6 IN- = SDET_N (Net-(U20-IN-)); 7 SHDN = SHDN_N (R81 to 3V3); 8 LE/HYS = Net (R82 DNP to GND, R83 DNP to LE_HYS); 10 OUT- = LVDS_N; 12 OUT+ = LVDS_P (R87 to C87 to SDET_P); 13 EP = GND.

## ERC
Scratch copy of the directory with the old root: only hier_label_mismatch for the new pins SDET_P, DAC_TH, VCM_REF, VTH_MON (removed: SDET, VTH).

## Open items
UNRESOLVED comparator input noise and delay below 10 mV overdrive (DS has none), IB at VCM = 1.65 V, jitter added by the hysteresis network.
