daharoni/photodiode-lvds-receiver/docs/decision-log.md

# Decision log

Entries dated 2026-10-08 (user session) except where a date is given. Labels are PROPOSED unless noted.

## Decisions

1. **Analog-first.** AGC and slicing are analog; MCU/ADC hooks are optional. Rationale: user decision, lowest latency and independent of firmware.
2. **Single PCB, hierarchical sheets.** Rapid iteration instead of many coupons.
3. **ULX3S first FPGA target.** Available now. LVDS input on the 3.3 V banks VERIFIED (docs/research/ulx3s-lvds-input.md): ECP5 differential inputs run from VCCAUX and DIFFRESISTOR=100 exists on banks 7 and 2/3, so the TLV3605 pair goes straight to gp/gn[8..13] or [14..21] with no receiver IC and no external termination.
4. **Shielded housing and swappable filter.** 6.63 MHz QSCR field is in-band; one module serves 630 nm and 765 nm.
5. **Rails +/-3.7 V; APD_BIAS 100–220 V (superseded PD_BIAS >= 6.5 V on 2026-10-08).** See corrections 4 and 14 and decision 8.
6. **All new parts via lab-library PR.** No project-local symbols; library at ~/Projects/kicad-lab-library.
7. **Headstage co-designed with receiver; no backward compatibility requirement.** Emitter wavelength, radiant intensity, drive and modulation are co-design variables (NIR preferred); the link budget is joint. Miniscope Zero emitter facts are baseline only.
8. **Detector: silicon APD selected (2026-10-08).** The link budget (docs/calculations/link-budget.md) shows a bare FDS010 PIN into the OPA857 is 18–23 dB optical short of Q = 6 at 35 cm lateral with any headstage-power-compatible emitter, because photocurrent (1–3 nA) is far below TIA noise (8–26 nA). Étendue caps optics at ~2× for a ±45° field of view. An APD with M ≈ 50 plus a modestly brighter NIR emitter closes the link with margin. Daniel approved the APD path. Consequences: the 6.5–15 V MAX15032 bias block is replaced by a 150–200 V temperature-compensated APD bias supply; the FDS010 remains a drop-in fallback only if a compatible footprint is kept; part selection is tracked in docs/research/apd-selection.md. PROPOSED until a part and bias design are chosen. 2026-10-09: the FDS010 bench-fallback footprint D11 was dropped from Rev A (Daniel); the FDS010 remains a bench-only reference in requirements.md. 2026-10-23 (review A1/A2, decision 31): "modestly brighter" is withdrawn. The corrected direct-path budget (link-budget.md, revision 2026-10-22) needs about 11 to 12 mW/sr on axis over 140 degrees for Q = 6 at 35 cm lateral with the bare S12023-10, about 4.5 to 4.8x the reference QBLP601 at 50 mA; optics on the direct path, the reflective arena and receiver tiling are credits against that (PROPOSED, unmeasured). The APD choice itself stands: a PIN needs 15 to 23x more light at the built 70 MHz noise bandwidth.

9. **APD bias supply: on-board LT8365 boost + charge-pump stage (2026-10-08).** Daniel prefers to handle as much as reasonable on our own PCB rather than a purchased HV module. Rev A therefore carries an LT8365-based 100–220 V generator (datasheet Rev. A and DC2838A demo manual Rev. 0 archived in docs/datasheets/), a two-stage RC cathode filter, series current limit, NTC temperature-tracking divider with a DAC-trim hook, and a footprint/pads for an external HV module as bench fallback. Design calculations in docs/calculations/apd-bias-design.md. PROPOSED until measured. 2026-10-23 (review B3): the external-HV pads were never drawn; Rev A has no external HV input and no bare APD_BIAS or HV_K pad (decision 10). The only bench provision is J1 "HV FORCE ON" (DNP), which forces the gate on. An external supply for a bench build would have to be wired to the C50/R50 side by hand. Accepted as is.

10. **Rev A schematic choices (2026-10-08, PROPOSED).** Captured in docs/schematic/rev-a-sheet-specs.md and the per-sheet as-built notes:
   - The analog LOS comparator (TLV3201 on VSPAN) is a status output only and does not freeze the AGC integrator. Reason: a weak eye at power-up would set LOS, freeze the integrator and leave the gain unable to rise (startup deadlock found during sheet population). With no signal the loop runs VG toward its upper bound, which is the SEARCH state in the architecture state table. The FPGA's HOLD_N (via a TMUX1112 switch in the integrator input path) is the only freeze; a DNP 0 ohm resistor keeps the LOS-freeze option for bench experiments. The VG upper bound versus the VCA821 0-2 V gain-control range is UNRESOLVED (BAS70 clamps footprinted, DNP).
   - Gain and threshold sources are 3-pin headers (VINT / pot / DAC and VMID / pot / DAC) because they change on the bench; the detector coupon and the OPA857 gain select use solder jumpers.
   - APD bias filter split: clamp + 27 k/10 nF on the Power sheet, 10 k/10 nF at the cathode on the Front End sheet; HV nets are prefixed HV_ and sit in the project net class HV (1.0 mm clearance). HV_MON (10 M/100 k, Vout/101) is the only HV observation point; no bare APD_BIAS pad.
   - No SAMD51 on Rev A: a 6-pin MCU header carries DAC_GAIN, DAC_TH, DAC_HV and HV_MON with 100 k pull-downs (polarity UNRESOLVED).
   - Standard KiCad power symbols (power:PWR_FLAG, power:GND) are allowed alongside the lab library, as in the lab's CaRacterize project.

11. **Module controller: ESP32-C6 on each receiver, CAN to the FPGA side, no BLE (2026-10-08, PROPOSED).** Daniel is moving away from the SAMD51 and wants each module to carry an ESP32 as its single point of contact with the FPGA side (module identification, future-proofing); the ESP32 then talks to everything slow on the module. Consequences: (a) on-board MCP4728 12-bit I2C DAC (DAC_GAIN, DAC_TH, DAC_HV trims) and ADS1115 16-bit I2C ADC (HV_MON, VSPAN, VG, VMID monitors) driven by the ESP32 over local I2C, replacing the external-MCU header; (b) CAN_P/CAN_N in the per-module cable next to the LVDS pair through a 3.3 V transceiver, cables joined star-fashion at the FPGA end, low bit rate so stubs are tolerable (physical-layer limits in docs/research/module-controller.md); the ULX3S's own ESP32 or an FPGA soft core is the master; (c) HOLD_N stays a direct FPGA wire so the AGC freeze does not depend on firmware; (d) SHDN_N, LE_HYS, HV_EN and LOS/PGOOD readback move to ESP32 GPIO; (e) a separate 3V3_D LDO rail for the ESP32 keeps its current steps off the analog 3V3; (f) the radio is unpopulated in use, so the shielded housing needs no RF window; BLE was considered and rejected (shielding, TX noise next to the TIA, and a wired bus already exists). Analog-first is unchanged: the ESP32 is not in the signal path and the module works with the ESP32 unprogrammed (manual trimmers, HOLD_N wire).

12. **Fixed-gain post-amplifier and baseline slicer replace the VCA821 VGA, analog AGC loop and peak detectors (2026-10-08, PROPOSED, approved by Daniel).** Chain: OPA857 TIA -> AC coupling -> OPA855 fixed gain x7 -> 60-80 MHz low-pass -> AC coupling with matched <= 1 k returns to a 1.65 V reference -> TLV3605 with 2-4 mV external hysteresis -> LVDS. Slow range control is done by the ESP32 (APD bias via DAC_HV, OPA857 20k/5k select on a GPIO) using an RSSI peak detector read by the ADS1115 and the FPGA's 8b/10b validity. Basis (docs/research/post-amp-slicer.md): with 8b/10b the eye centre is the AC-coupled baseline, so no threshold tracking is needed; the OPA855 recovers from rail clipping in 3 ns (UI 20 ns) and clipping is symmetric about the baseline, so the comparator keeps slicing up to the TIA's own 60 uA saturation; one fixed setting covers ~39 dB of signal range and firmware adds ~32 dB; the comparator sees 105-175 mVpp at the operating point so its +/-5 mV offset and unspecified input noise stop mattering. Daniel's note: received intensity changes only as fast as the animal moves, slow relative to a firmware trim loop, so an analog AGC buys nothing. Removed: VCA821, LM27762 +/-3.7 V rails, 5V_A, the detector coupon (OPA356 x2, BAS70 x2, OPA2320), VMID/VSPAN/integrator/TMUX1112/TLV3201 and HOLD_N (cable pin becomes AUX2). Kept: analog slicing; the signal path runs with the ESP32 unprogrammed at 20k; the APD bias does not, it is enabled only by the provisioned ESP32 (reworded 2026-10-22, decisions 20 and 21; the "fixed M" never existed in hardware, M comes from the DAC-set bias). Standing corrections 1, 4, 5, 7, 8, 9 are superseded (kept below for history); correction 11 still applies. Hard rule 1 is read as "slicing stays analog; range control is a firmware trim". 2026-10-23 (review A2, decision 31): the "~39 dB" and "~32 dB" figures are electrical (20 log current) dB; in optical power the single setting covers 10 to 12 dB unclipped from the Q = 6 floor to the post-amp clip, about 19 dB to OPA857 saturation, and firmware adds 18 to 19 dB at the strong end only (M 100 to 5 and 20k to 5k both lower gain). The weak end is fixed by M <= 100 at 20k, so fade margin equals emitter margin. The Q-optimal M at the sensitivity limit is 83 to 112, capped at the datasheet's 100, not 35 to 60 (link-budget.md revision 2026-10-22, PROPOSED).

13. **USB standalone power and programming (2026-10-09, PROPOSED until G1 measurements, approved by Daniel; the TPS2121 mux, PWR_SRC, VBUS_SENSE, J60 and J50 parts are superseded by decision 14).**
   - What: a TI TPS2121 priority power mux (U5) merges the system-cable 5 V (+5V_CABLE, IN1, priority) and USB-C VBUS (IN2, fallback) into the internal `+5V` rail. RESET (EN) and BOOT (IO9) tactile switches, 22 ohm series resistors on D+/D- (R193/R194, with DNP capacitor footprints), a VBUS_SENSE divider on IO4 and the mux status PWR_SRC on IO5. Detail: docs/schematic/rev-a-sheet-specs.md revision 3; facts and citations: docs/research/usb-standalone-power.md.
   - Why: Daniel's requirement (2026-10-09): "anyone should be able to plug a module into a random laptop over USB, program it and verify it, with no FPGA attached". The native USB Serial/JTAG supports ESPHome-style browser flashing and host-driven reset/download (TRM v1.2 p.1030), and the self-test needs power without the cable. When both sources are plugged in the TPS2121 powers the module from the cable, and its reverse-current blocking keeps either source from being back-driven (SLVSEA3F p.7, p.15; PROPOSED, to be measured).
   - Alternatives rejected: two LM66100 ideal diodes (no native priority, CE compares against VIN so the higher rail wins and the band between is undefined; 6 V abs max can be exceeded by a hot-plug ring; two new library parts). Schottky OR-ing (no priority, the higher rail wins, costs 0.3-0.45 V at the load, no soft start or current limit; the Vf figure is typical Schottky behaviour, not read from a datasheet).
   - Consequences: new lab-library category `AharoniLab_Switch` (symbol PTS810, footprint SW_SPST_PTS810, 3D model) by library PR; `+5V` is renamed `+5V_CABLE` on the cable side (Connector -> Power) and `+5V` stays the merged internal rail; new hierarchical nets VBUS (Controller -> Power) and PWR_SRC (Power -> Controller). Worst-case input about 0.19 A (0.24 A with margin) against the 0.5 A USB default: the radio must stay off. HV rules unchanged: HV_DIS default off, HV starts only when the ESP32 drives HV_DIS low, and in USB-alone mode firmware starts HV from the low-bias end of DAC_HV in steps because a faulted HV start can trip a USB port. UNRESOLVED items listed in docs/research/usb-standalone-power.md section 7 (esptool auto-reset through 22R and the USBLC6, mux settling and inrush, cable-rail chatter, USB spec limits, ground offset). Gate: G1 measurements (docs/bringup/gates.md).

14. **Single 24-pin USB-C connector per module (decision 14, 2026-10-09, PROPOSED until G1 and G4 measurements, approved by Daniel).**
   - What: one 24-pin full-featured USB-C receptacle (Wuerth 632723300011, horizontal) per module replaces the 16-pin USB-C J60 and the 12-pin system header J50. It carries VBUS/GND (5 V), D+/D- (ESP32-C6 USB Serial/JTAG, Dp1 tied to Dp2 and Dn1 to Dn2), the module LVDS on both SS TX pairs through an SN65LVDS104PW fan-out buffer (U50), CAN_P/CAN_N bused on both SS RX pairs [nets renamed CAN_P/CAN_N and USB_DN 2026-10-16 for KiCad diff-pair routing; no electrical change], and SBU1/SBU2 tied as AUX. Mated through a passive full-featured C-to-C cable. A TI TPS259631DDAR eFuse (U5) replaces the TPS2121 and is the only 5 V input stage. CC1/CC2 are read on IO4/IO5. Detail: docs/schematic/rev-a-sheet-specs.md revision 4; adopted draft and facts: docs/research/decision-14-draft-usbc-single-connector.md (with usbc-connector-and-cable.md, usbc-power-path.md, lvds-fanout-and-foreign-host.md).
   - Why (Daniel, 2026-10-09): one connector and one standard cable per module; plug orientation must not cost ECP5 LVDS pairs (with the pairs duplicated and CAN bused, all four flip combinations land correctly on the far end, TC R2.5 Table 3-10 p.83; PROPOSED analysis); USB stays a line to a computer. System picture: CAN + LVDS between the FPGA and the modules, USB only toward a computer (one hub on the FPGA-end breakout board; the ULX3S cannot be a USB host).
   - Daniel's approvals (2026-10-09): (1) horizontal receptacle, Wuerth 632723300011; (2) TPS259631DDAR eFuse replaces the TPS2121 (OV cut-off 5.76-6.20 V, UVLO rising 4.06-4.32 V, ILIM 0.76 A typ, calculated, not simulated); (3) J51 kept as a scope header on the fan-out buffer's spare output 3; (4) cables: <= 2 m certified passive full-featured (USB 3.2 Gen 1, 3 A, e-marked); 3 m only after a bench check (SS-wire continuity then scope) of a specific passive cable.
   - Supersedes in decision 13: the TPS2121 two-source mux, `+5V_CABLE`, PWR_SRC, the VBUS_SENSE divider (R215/R216/C205), the 16-pin J60 and the 12-pin J50, AUX2. Keeps decision 13's requirement (a module can be plugged into a random laptop, programmed and verified with no FPGA) and its RESET/BOOT switches, 22 ohm D+/D- resistors and HV discipline (HV_DIS default off; stepped start in USB-alone mode). R199 (SN65HVD230 RS) goes 10 k -> 100 k for slower CAN edges on 3 m stubs.
   - Standing corrections: the list below is unchanged.
   - New lab-library parts (library PRs): Wuerth 632723300011 symbol and footprint, SN65LVDS104PW symbol, TPS259631DDAR symbol and a PowerPAD SOIC-8 footprint, TPD6E05U06RVZ symbol and USON-14 footprint, in addition to decision 13's AharoniLab_Switch.
   - Host link (open, a separate decision): how the ULX3S/FPGA end talks to a computer is NOT decided here (draft open item 8). Daniel's preference to evaluate first: the Cypress FX3 (CYUSB3014 family, GPIF II) which the lab knows from the Miniscope DAQ. Other options are recorded in the draft (USB 2.0 or USB 3.0 FIFO bridge, Ethernet PHY, single-board computer).
   - Open items: draft section 6 (items 1-16): 3 m cable existence; laptop foreign-host bench test with two hosts; eFuse thresholds/inrush; CC ADC classification margin; footprint checks; CAN with 14 stubs; CAN-to-LVDS crosstalk; host link; breakout board design. All UNRESOLVED until measured (G1, G4 in docs/bringup/gates.md).

15. **Layout-phase decisions (2026-10-09 to 2026-10-10, Daniel, PROPOSED; recorded 2026-10-12 from the commits and as-built notes).** Layout started 2026-10-09 and the schematic generators were frozen (`gen/FROZEN`); schematic changes since are KiCad GUI hand edits with ERC 0/0 after each. (a) Board: 75 x 50 mm placeholder outline; JLCPCB 6-layer JLC06161H-3313, ENIG, impedance control, ordered on the high-precision via tier (min via 0.25 mm/(0.35/0.4 mm)) because the Wuerth J50 B-row holes are below the standard-tier minima; JLCPCB's DFM accepted the `hardware/pcb/j50-dfm-test` board with that option, and `receiver-module.kicad_dru` waives the three hole rules for J50 only. (b) Four M2 plated mounting holes H1-H4 tied to GND (Connector sheet). (c) D11, the FDS010 bench-fallback footprint, dropped (entry 8). (d) ESD channels of U51/U52 reassigned by position along the J50 pad rows; U50 output 1 drives B2/B3 and output 2 drives A2/A3; LVDS polarity flipped at J50 on both pairs (N to SSTXp, P to SSTXn) so the pairs route uncrossed: the cable carries the fan-out output inverted, SSTXp is high for a logic one, and the FPGA-end inversion is a gateware constant. Nets and orientation independence unchanged. (e) CAN_TX moved to IO19 (pin 25) and CAN_RX to IO18 (pin 24) for layout (TWAI goes through the GPIO matrix). (f) First-pass placement of all 223 footprints by `tools/pcb_place.py` (fast chain on the top centre line, HV island on the back edge, ESP32 on the bottom; `docs/pcb/placement-plan.html`); nothing routed. Detail: `hardware/pcb/receiver-module/README.md`, `docs/schematic/connector.md`, `controller.md`, `frontend.md`.

16. **J50 shell tied directly to GND (2026-10-22, Daniel, PROPOSED).** C181 (1 nF) and R170 (1 M, DNP) are deleted; the J50 S1 pads (four shell posts) are on GND, the net `/Connector/SHIELD` is gone, and the board has 221 components (Connector sheet 31). Rationale: a compliant Type-C cable already ties shield to GND inside each plug (USB Type-C spec Table 3-10 note 6, as cited in `docs/research/usbc-connector-and-cable.md` line 91), so the RC never isolated anything; 1 nF is about 24 ohm at the 6.63 MHz QSCR field (arithmetic, ESL ignored), a poor bond for the cable braid around the SuperSpeed pairs; ESD on the shell should go straight to the plane. Layout rule (PROPOSED; reworded 2026-10-22 after review P7, Daniel): every shell post pad connects solid, not thermal-relieved, to the GND pour and planes on every layer; the plated post barrel (0.6 x 1.2 mm slot) already ties all six copper layers, so no extra vias are needed (the original wording said "several vias each"; eight were added and removed the same day, decision 28). Housing bonded at the connector end. ERC 0 violations; after a zone refill the S1 pads connect to the GND pours (0 unconnected S1 items); nothing measured. Same day, routing only: the U51 CAN clamp channels were swapped in the GUI (pin 9/6 = CAN_P, pin 8/7 = CAN_N); J50 nets unchanged and the channels are identical, so it is electrically neutral. Detail: `docs/schematic/connector.md`.
17. **S12023 APD pinout corrected: pin 1 = anode, pin 3 = cathode (2026-10-22, design review finding B1, VERIFIED).** The lab-library symbols S12023-10 and S12023-05 had pin 1 = K and pin 3 = A. The Hamamatsu outline KAPDA0136EC (KAPD1007E19 p.4, pin diagram in bottom view, confirmed by Daniel) draws the diode between terminals 3 and 1 with the bar on the 3 side. As wired, the APD would have been forward-biased from HV_K through R19 + R50 into the OPA857 input. Fix: pin numbers swapped on the K and A pins in the library (branch `fix-s12023-pinout`, commit 1cfe5d7) and in the embedded symbol in `frontend.kicad_sch`; D10 rotated 180 degrees about its can axis on the board so the anode pad stays beside U10 and the existing HV_K/TIA_IN tracks are reused; footprint pad geometry unchanged. Standing correction 2 (cathode to positive bias, anode to TIA IN) is unchanged in intent and now true in the netlist (D10 pin 3 = HV_K, pin 1 = TIA_IN). The full review is in `docs/review/2026-10-22-rev-a-review/`.
18. **R7 (20 ohm) moved from the boost rectifier path to the pump-charge path (2026-10-22, design review S1, VERIFIED).** LT8365 Rev. A p.30 (R8) and the DC2838A REV02 schematic (R10) both put the 20 ohm between the stage-1 capacitor node V1 and the anode of the pump diode; D1 runs straight from SW to V1. Rev A had R7 in series with D1, so it carried the full inductor peak current (about 0.3 A in DCM at 400 kHz and 0.2 W, an estimate from energy balance) and raised the SW pin by about 6-7 V per cycle against the 150 V absolute maximum, while the flying-capacitor C6 recharge through D3 had no damping or current limit. `docs/calculations/apd-bias-design.md` section 2 had misread the DC2838A (now corrected) and section 3.2 already called R7 "pump R as DC2838A R10". Fix: Power sheet rewired (D1 K = HV_V1; R7 pin 2 = HV_V1, pin 1 = D3 anode = `Net-(D3-A)`, which replaces `Net-(D1-K)` in the HV netclass pattern list); the board followed the same day (Daniel, commit 40262da: R7 vertical between the HV_V1 row and D3, C5 and C7 moved; four 1.25 mm HV pad clearance items around them remain to be cleared). Value unchanged (20 ohm, 0805).
19. **DAC leg R14 442k -> 150k so the production bias range is 50-219 V from the DAC alone (2026-10-22, design review S2, PROPOSED, calculated).** RV1/R15 are DNP in production, so the 104-215 V range in the calc doc (which assumed the pot leg fitted at mid) was not what a built board does: with Rd = 452 k the DAC alone spanned 106.6-166.5 V at 25 C, and a unit with VBR near the 200 V maximum could not be biased. Vout = Vfb(1 + Rt/Rb + Rt/Rd) - Vdac Rt/Rd with Vfb = 1.6 V (LT8365 Rev. A p.3), Rt = 8.2 M, Rb = 96.6 k at 25 C; the tempco depends only on Rb, so lowering Rd alone widens the span without touching the NTC design: Rd = 160 k (R13 10k + R14 150k) gives code 0 = 219.4 V, mid = 134.9 V, full scale = 50.3 V, LSB 41 mV, slope still 0.642 V/C. The firmware floor stays 100 V. R15 (DNP) goes from 274k to 1M so a bench-fitted pot adds only +/-13.5 V (274 k would have allowed 267 V at wiper 0, switch node over 150 V). Consequence for S3: a blank MCP4728 (code 0) now means about 220 V, so the EEPROM provisioning before HV_DIS is released is mandatory. Script `tools/apd_bias_design.py` rewritten for the pot-DNP case (parameter `pot_fitted`), 0 FAIL; its output is pasted in `docs/calculations/apd-bias-design.md` section 5. Nothing measured.
20. **Blank-DAC power-up state closed by the interlock and firmware self-provisioning, no hardware change (2026-10-22, design review S3, Daniel, PROPOSED).** The MCP4728 loads its EEPROM at power-on and the factory EEPROM is code 0 on every channel (DS22187E Table 4-2 p.24, section 4.2 p.23, VERIFIED), so a blank part puts DAC_HV at 0 V = maximum bias (about 220 V after decision 19) and DAC_TH at 0 V = a 16.3 mV threshold offset below VCM_REF (R85/R84 divider, calculated). Daniel's call: HV cannot turn on without the ESP32 (R33 pulls HV_DIS high; only firmware drives it low, after writing DAC_HV = 0xFFF and reading it back), so no hardware is added and there is no EEPROM programming step outside the board. Conditions written into firmware/esp32/README.md: (1) boot step 4 provisions the EEPROM itself when it reads blank or wrong (C = 0xFFF, B = 0x800, VREF = VDD) and faults only if the re-read still differs; (2) J1 "HV FORCE ON" is fitted only on a board whose firmware has run once (self-test step 3 pass); (3) the ESP32 brownout level is set at or above 2.3 V so the ESP32 resets and releases HV_DIS before the MCP4728 (VPOR 2.0 V typ, 2.2 V max, DS p.4) reloads its EEPROM, exact sdkconfig option UNRESOLVED; (4) a set POR bit in a Read reply while HV is on raises HV_DIS. The "DAC pin Hi-Z at reset" text in the calc doc was wrong for this part and was removed under decision 19. Gate G1 gains a first-boot check. Nothing measured.
21. **"Decodes with the ESP32 unprogrammed" reworded: the signal path is firmware-free, the bias enable is a firmware interlock (2026-10-22, design review S4, Daniel).** As built (netlist, VERIFIED): TIA_CTRL's pull-up gives 20k, SHDN_N's pull-up keeps the comparator on, the fan-out and LVDS pair need nothing from the ESP32, and after decision 20 the provisioned DAC EEPROM centres the threshold at power-up; but R33 pulls HV_DIS high, Q3 holds the LT8365 off and only firmware drives HV_DIS low, so an unprogrammed module has no APD bias and decodes nothing. Hard rule 1 (CLAUDE.md), decision 12, architecture, the guide, controller.md and the firmware README now say so: "slicing is analog and the signal path from APD to LVDS needs nothing from the ESP32; the APD bias is enabled only by the provisioned ESP32, so an unprogrammed module is safe but dark". The alternative, a resistor-set bias through the pot leg with J1 fitted, was rejected: it conflicts with decision 20 (J1 only after a firmware boot) and R15 at 1 M. No hardware change.
22. **R17, R18, R20 and R32 (4.99 M) move from 0603 to 0805 for voltage rating (2026-10-22, design review S5a, Daniel, VERIFIED rating).** At 220 V each of the two series resistors in the Q1 base feed and in the HV_MON divider holds 110 V. Thick-film 0603 parts are rated 75 V working; the Yageo RC0805 specification (Version 0, 2016-07-26, p.3, docs/datasheets/yageo-rc0805.pdf) gives 150 V maximum working and 300 V overload for 0805, so the four parts become 0805 (value 4.99 M 1 % unchanged; example MPN RC0805FR-074M99L). The FBX ladder (4 x 2.05 M, 55 V each) stays 0603. Footprint change in the schematic and re-placement on the board by Daniel in the GUI. The second half of S5, the base-starved clamp (bias drop Ic x 10 M / hFE at the APD side, invisible to HV_MON), is still open: a MOSFET pass device in place of the MMBTA42 was proposed and not decided; G1 measures the bias at the APD side against injected current.
23. **Hardware over-voltage limiter on the HV supply: TLV431A on the HV_MON tap pulls LT8365 EN low at about 228 V (2026-10-22, design review S6, Daniel, PROPOSED, calculated).** An open resistor in the 8.2 M FBX chain or an FBX short makes the converter run at its limit; with about 50 nF on the output it rises about 25 V/ms, so the 150 V diodes avalanche about 3 ms after the fault, faster than firmware polling of HV_MON, and with J1 fitted nothing would stop it. Fix: R21 (100k) split into R21 45.3k and R45 54.9k, the tap `OVP_REF` = 0.548 x HV_MON; U6 TLV431A (VREF 1.24 V, 1 %; SLVS139Z June 2024 p.3, 5-7) with REF on the tap, cathode on `EN`, anode on GND pulls EN/UVLO to 1.24 V, below the LT8365 1.545 V minimum falling threshold (Rev. A p.4), when HV_OUT reaches 2.263 V x 101.2 = 228 V; the converter stops, SS resets and the output sawtooths at the trip level. Error budget about +/-3 V; switch node 114 V plus ring at the trip. R22/R23 200k -> 20k (same 2.5 V ratio) so the EN node sources the 80 uA minimum cathode current. The HV_MON ratio becomes 1/101.2. The Zener-string-into-FBX option from the review was rejected: Zener leakage into the FBX summing node moves the set-point 8 V per uA. TLV431 symbol added to the lab library (branch `add-tlv431`, AharoniLab_Power); U6 and R45 placed and routed by script next to R21 with the EN link on F.Cu to the Q3 drain; ERC 0/0, DRC 52, parity clean. G1 item 3c verifies the trip. Nothing measured.
24. **Clamp pass transistor made a Darlington: Q4 MMBTA42 drives Q1's base (2026-10-22, design review S5b, Daniel, PROPOSED, calculated).** Q1 carries the whole APD current and its base was fed only through R17 + R18 = 10 M, so the APD-side bias fell by Ic x 10 M / hFE below HV_OUT, invisible to HV_MON: with hFE about 30 at tens of uA (MMBTA42 guarantees 40 at 1 mA; the low-current value is UNRESOLVED) that is 3 V at 10 uA and 20 V at 60 uA, i.e. ambient light through the filter would collapse the bias and corrupt the M estimate. Options weighed: lowering Rb (fault current through Rb plus the clamp exceeds the APD's 200 uA maximum below about 3 M, and 3 M still leaves 6 V at 60 uA), a MOSFET source follower (no current-dependent drop, but the +/-20 V gate needs a gate-source Zener for an HV_OUT short while the cathode capacitors hold 220 V, two new library parts, loop not simulated), and the Darlington (one more MMBTA42 already in the library, gain about hFE squared, drop about 0.7 V at 60 uA plus a fixed 2 x Vbe absorbed by the per-unit trim, no new failure modes). Daniel chose the Darlington for Rev A; the MOSFET is the Rev B option if G1 item 3b shows the residual matters. Netlist: Q4 B = Net-(Q2-C) (R18, Q2 collector; added to the HV netclass patterns), Q4 E = Net-(Q1-B) (Q1 base only), Q4 C = HV_OUT. Board (script): Q4 SOT-23 at (23.60, 6.73) right of Q1; HV_OUT extended from Q1's collector through Q4's pad gap to Q4's collector and re-routed to R20 around the east side (the old diagonal removed); the 10 M node reaches Q4's base through a new via at (22.66, 4.20) on SIG_IN from the existing via at (14.05, 3.40), and Q4's emitter reaches Q1's base through a new via at (21.30, 8.40) on SIG_IN to the existing via at (17.53, 5.60); Q4 added to the "hv escape inside own courtyard" DRC exception. HV-class vias on these two nets go from 3 to 5 (review P4 asks for 0; left for the PCB pass). ERC 0/0, DRC 52, parity clean. Nothing measured.
25. **D10 pad spacing waiver: 1.0 mm pads on the S12023 TO-18 footprint, gaps below the project HV rule accepted with conformal coating (2026-10-22, design review P1, Daniel, PROPOSED, measured in CAD).** The three TO-18 leads sit on a 2.54 mm circle, so no pad size can meet the project's 1.5 mm external / 2 mm-from-TIA_IN rule (calc doc section 7 rule 1) or the IPC-2221 1.25 mm uncoated figure between the 220 V cathode pad and the case (GND) pad; the `hv same footprint pads` DRC exception hides this. Fix: lab-library footprint pads 1.2 -> 1.0 mm on the unchanged 0.7 mm drill (PR #65; annular ring 0.15 mm, the JLCPCB standard-tier minimum), pad 1 square per KLC. Gaps from the cathode pad (pcbnew shape distances, VERIFIED): case pad 0.80 mm (was 0.60), anode pad 1.54 mm (was 1.34); zones on all six layers 1.00 mm. Both gaps exceed the 0.4 mm coated figure, so the assembly rule is clean and conformal-coat the solder side at D10 with the window clear (G4). The waiver is written next to the DRC exception and in calc doc rule 1. Rejected: a grounded guard track between the cathode and anode pads (adds capacitance to the TIA input against a DC leakage the AC-coupled chain does not see). Whether the can sits flush on the pads (metal header at GND over the cathode annulus) is handled with review P2. DRC 52, parity clean.
26. **Cathode capacitor at the can, HV_K radial exit, D10 on a 1.5 mm insulating spacer (2026-10-22, design review P2, Daniel, PROPOSED, measured in CAD).** C50 sat 6.78 mm of trace from the cathode pad against calc rule 6 ("<= 3 mm"), and the HV_K diagonal entered the can at 45 degrees with 1.65 mm of 220 V copper under the grounded flange. Facts: KAPD1007E19 p.4 (outline KAPDA0136EC, VERIFIED) shows a 5.4 mm flange, 0.45 mm leads 13.5 mm long and no standoff, so a flush-seated metal header (the case, GND) sits over the cathode pad's own annulus and over any exit track; the pad is 1.27 mm from the can axis and the flange reaches 2.7 mm, so some copper is always under it. The D10 courtyard (3.45 mm radius) plus a 1210 half-courtyard keeps C50's centre at least 5.1 mm from the axis, so the 3 mm figure is unreachable. Done: C8, R50 and C50 re-placed in a column at x 4.60 left of D10 (script, KiCad closed); C50's HV_K pad 4.43 mm from the cathode pad (4.59 mm of trace), two GND vias in its ground pad; HV_K leaves the pad radially along y 25 (0.93 mm under the flange plus the pad); rule 6 amended to "as close as the courtyard allows, radial exit". The flange question is closed mechanically: D10 is mounted on a 1.5 mm insulating TO-18 spacer (part UNRESOLVED; height is the datum for the window in the enclosure), giving air above the 1.25 mm uncoated figure between header and copper and also lifting the header off the annulus from decision 25. Electrical effect of the shorter loop is percent-level (about 4 nH versus 265 ohm of junction reactance at 100 MHz, PROPOSED), the gain is pickup. Rejected for now: a 100 pF C0G at the pin (16 ohm at 100 MHz, adds little next to the 10 nF path 4.4 mm away); a 1 nF is the bench option if G1 shows the cathode return matters. DRC 52, 0 unconnected, parity clean, ERC 0/0.
27. **OPA855 cell re-laid out: U11 rotated so the input pins face the feedback parts, plane windows under the signal pins, TP10 moved to LPF_OUT (2026-10-22, design review P3, Claude while Daniel was out, PROPOSED, simulated).** Review P3: no plane window under IN-/FB/OUT (SBOS622D 9.4.1, Fig. 9-12), R53/R54 2.5 to 4.5 mm from the pins, TP10 a 2.5 mm stub plus a 1 mm pad on OUT ahead of R56. Simulation first (docs/simulation/README.md, section "OPA855 with layout parasitics"): 0.5 pF on IN- and OUT costs 1.7 degrees of phase margin (77.1 to 75.4), 1.0 pF 3.4 degrees; the visible effect is closed-loop peaking near 1 GHz (0.4 dB at 0.5 pF, 1.8 dB at 1.0 pF) and 0.2 ns-edge overshoot, which the 68 MHz R56/C54 low-pass hides from the comparator; the review's 10 to 15 degree estimate is not reproduced. So the layout change is hygiene, not a stability rescue. Done (script, KiCad closed): U11 rotated to 270 degrees, so pins 1-4 (FB, NC, IN-, IN+) face up toward R53/R54, which stay at (26.17, 22.67) and (26.17, 21.12); FB track 1.38 mm (was 2.5), IN- node 3.15 mm (was 4.97), IN+ 4.65 mm to C51. Output side: R56 vertical directly below pin 6 (OUT node 1.55 mm, was 1.7 plus the stub), C54 beside it, C52 beside pins 7/8 with a GND via and its own 3V3 via, GND via 0.9 mm from pin 5. TP10 moved from the OUT node to LPF_OUT (schematic hand edit in frontend.kicad_sch: symbol and wire shifted onto the LPF_OUT wire with a junction; ERC 0/0) and placed on the LPF_OUT run at (30.5, 27.4), so the probe loads the filtered node, not the amplifier output. Two rule areas, no copper pour on all six layers: OPA855_IN_WINDOW x 24.85-27.5, y 20.4-24.35 (pins 1-4, R53, R54, their tracks) and OPA855_OUT_WINDOW x 25.6-27.0, y 25.6-27.8 (pin 6 and the OUT track to R56); the EP keeps its plane vias. DRC 52 (no new items), 0 unconnected, parity clean. G1 still measures the margin on the board.
28. **Ground-return vias: C5, U3 exposed pad, J50 shell posts, U50/C56/C57 (2026-10-22, design review P5, P7, P8, Claude while Daniel was out, PROPOSED, partial).** Placed by a script that tests every candidate spot against all copper and holes on all layers (clearance 0.21 mm, 0.32 mm to diff pairs, 1.3 mm to HV nets, hole-to-hole 0.45 mm) before adding a 0.45/0.25 via and a short link track. P5: C5's GND pad goes from 1 via to 3 (added at (62.82, 4.90) and (62.15, 5.79)); the U3 exposed pad from 2 to 5 (added at (46.40, 10.36), (46.40, 11.08), (46.45, 12.40); the right-hand column is blocked by the 1.25 mm HV pad rule from pads 14/16 on the SW node). The 0.15 mm pour neck and moving C5 toward D1 are left for Daniel (his island). P7: all eight J50 S1 pads set to solid zone connection (the four starved-thermal items are gone, DRC 52 -> 48). Eight GND vias beside five of the six posts were added and then removed the same day at Daniel's call: the plated post barrels already tie every layer, so the solid pad connection is the whole fix and decision 16 is reworded accordingly. P8: vias at U50 pin 8 (0.45 mm), C57 and C56 GND pads (0.44 mm). No legal spot within 2.2 mm for U50 pin 5 (LDAC on In2, LVDS_P), C184/C185 (DAC_HV on B.Cu, SDA/SCL on In2), U51 pin 5 (CAN_P, LVDS_OUT2_N), U52 pins 5/10, U4 pin 2 and C30/C31 (HV_OUT/HV_RAW within the 1.0 mm HV clearance on F.Cu above the bottom-side LDO), C196 (LVDS_DBG pair, CAN_TX), C1 (3V3 tracks), U62 pin 10: each needs a local re-route or a part nudge, left for Daniel. DRC 48, 0 unconnected, parity clean. Nothing measured.
29. **HV vias on the clamp base nets accepted (2026-10-22, design review P4, Daniel, PROPOSED).** Net-(Q1-B) and Net-(Q2-C) (within about 2 V of HV_OUT) have five 0.45/0.25 vias and about 14 mm of track on In2 (SIG_IN) under the HV island (decisions 15 and 24). Daniel kept them. Exposures, none measured: layer-to-layer, 220 V across the 0.1088 mm 2116 prepreg to the GND_In3 pour (no 3V3 pour under the island) is about 2 kV/mm against typical FR4 breakdown above 20 kV/mm (JLCPCB publishes no figure); lateral, the HV netclass keeps 1.0 mm to other In2 copper and the plane antipads 1.0 mm around each via; coupling, the track-to-In3 capacitance is about 1 pF, into a node the R50/C50 filter rolls off 300x at the 500 kHz switching frequency. The reviewer's own note was that the risk is low and the problem was the README claim "no HV-class net has a via", now corrected; calc doc rule 2 says when HV vias are allowed. IPC-2221 has no layer-to-layer clearance row, so the margin rests on laminate breakdown, PROPOSED.
30. **All vias epoxy filled and capped at order (2026-10-22, design review P6, Daniel, PROPOSED).** 155 of the 209 vias sit inside SMD pads (ESP32 thermal pad, every exposed pad, twelve 0402 capacitor pads, most 0603 GND pads, eight test points; reviewer count by hit-test), and "vias tented" cannot apply inside a pad opening: an open 0.25 mm drill in a pad wicks paste down the barrel. Daniel's call: order with JLCPCB's "Epoxy Filled & Capped" via covering for every via (the 0.45/0.25 via is inside the stated 0.15 to 0.55 mm range, docs/pcb/jlcpcb-fab-settings.md section 1; price UNRESOLVED until the quote). The G4 pre-order item now lists it with two checks at quote time: the DFM accepts 0.25/0.45 with filling on the high-precision tier, and the price. Known residual: a 0.45 mm capped via still takes most of a 0.56 x 0.62 mm 0402 pad, so those twelve caps stay a solder-joint watch item at assembly (reviewer's point, accepted). No via is moved off a pad.
31. **Link budget corrected to the built chain; emitter working point; larger APD and dual footprint not adopted (2026-10-23, design review A1/A2, Daniel, PROPOSED, nothing measured).** Daniel accepted the independent redo in docs/calculations/link-budget.md ("Revision 2026-10-22"): (a) the old emitter target was priced at an impossible 229 % wall-plug efficiency; (b) the built noise bandwidth is about 70 MHz (OPA857 about 100 MHz into the 68 MHz R56/C54 low-pass), not 35 MHz, worth 2.2 to 2.5 dB optical at the APD's best gain plus 0.5 dB for the 6 pF noise curve; (c) the Q-optimal M at the sensitivity limit is 83 to 112, capped at the datasheet's 100; (d) the range figures were electrical dB and firmware extends the strong end only. Direct path alone, bare S12023-10, 35 cm lateral at 50 cm height: Q = 6 needs about 11 to 12 mW/sr on axis over 140 degrees (43 to 46 mW of on-state flux), 4.5 to 4.8x the reference QBLP601 at 50 mA. Decision 8 (APD) stands. Three credits Daniel raised are recorded as PROPOSED terms with their assumptions, not as margin: optics on the direct path (étendue-limited, 2x at +/-45 degrees, 4x at +/-30, 8.5x at +/-20; optics cannot raise the diffuse term); the reflective arena (integrating-sphere estimate; for a 50 cm open-top cube at 0.5 to 0.7 wall reflectance the diffuse term on the die is 24 to 57 nW per 43 mW of flux through the filter, 1.6 to 3.7x the 15 nW direct term; counting the open top as a sixth dark face halves it; wall reflectance at 850 nm UNRESOLVED); and receiver tiling with FPGA selection (at 50 cm height it buys at most 3.2 dB geometrically, its real value is removing orientation and shadowing from the margin). Working emitter assumption for the headstage co-design: a 1 W class 850 nm LED at 30 to 100 mA on-state (45 to 150 mW average electrical at 50 % duty) if optics and arena deliver, up to 200 mA if not; driver sized for 500 mA; Vf 3.0 V and 30 % WPE ASSUMED. The "~200 mW" headstage power figure has no source (UNRESOLVED). The arena photocurrent measurement (review A4, no board needed) decides between those cases and is now a G1 pre-board item. Larger APD: the S3884 (1.5 mm, 10 pF, same bias family) was evaluated and not adopted for Rev A: the OPA857 20k mode at 10 pF settles in 21.5 ns, more than one UI, with 2.2 dB peaking at 52 MHz (SIMULATED, docs/simulation/README.md Sim 2), so the +3.5 dB area gain is cancelled; it is a Rev B option only with a discrete TIA. A dual TO-18/TO-5 D10 footprint was rejected: the TO-5 lead circle (2.54 mm radius) sits under the TO-18 flange rim, putting an unused 220 V pad under the grounded can and a plated stub on the TIA input (docs/research/apd-selection.md).
32. **Review MINOR schematic set applied (2026-10-23, Daniel's "do both", PROPOSED, nothing measured; KiCad closed, text and pcbnew edits, ERC 0/0, DRC 44, 0 unconnected).** (a) 3V3 retargeted: R1 17.8k to 18.7k, U1 TPS79901 output 3.42 V nominal, window about 3.34 to 3.50 V with the 2 % overall accuracy and 1 % divider (tps799.pdf), because the old 3.25 to 3.38 V window dipped below the OPA855 3.3 V minimum (SBOS622D); ceiling checked against OPA857 3.6 V (SBOS630D) and SN65LVDS104 3.6 V. (b) OPA855 gain parts R53/R54 to 0.1 % so the gain of 7.03 cannot land below the minimum stable gain of 7; the x7 target of decision 12 is unchanged. (c) Ratings stated in the value fields because the lab symbols have no separate fields: C50 10nF 500V C0G, R50 10k 200V (1206), C54 47pF C0G, C87 100pF C0G. (d) R214 2.2k 0603 in series between U60 IO20 and TIA_CTRL, placed on F.Cu at (44.0, 34.6) over the ESP32 with the track jogged; protects the GPIO against the JP10 solder jumper. (e) R199 100k to 91k (SN65HVD230 Rs; 100k sat at the top of the characterised slope-control range, V(Rs) above 0.75 VCC is standby). (f) C200 DNP (both pins on GND since AIN3 is tied to GND through R209). (g) D2 DFLS1150-7 fitted for the first bench build. Checked and left alone: OPA857 bypass (datasheet asks for 0.1 uF at +VS, which C56/C57 are; no 10 nF in the text); TLV3605 LE/HYS open is characterised (VHYST 0 mV for RHYST floating, SNOSDA2F); R33 stays on 3V3_D (IO0 is Hi-Z at reset so the pull-up holds Q3 on, and a +5V pull-up would feed a non-5 V-tolerant pad); HV_MON loading of the ADS1115 (about 1.7 %) is calibrated in firmware; eFuse FLT stays a test point. Deferred: a VBUS TVS ahead of the eFuse needs a lab-library part (UNRESOLVED). PCB cleanups in the same commit: dangling VCM_REF and TIA_CTRL vias, two sub-0.06 mm EN stubs and one of the co-located GND vias at (52.65, 11.7) deleted; DRC 48 to 44, remaining items are the 32 mounting-hole rings, 5 silk-edge, 4 diff-pair gap, 1 starved thermal, 1 uncoupled, 1 silk overlap.
33. **DRC closed out: mounting holes without via rings, U20 pin 9 solid, LVDS and silk items accepted in writing (2026-10-25, Daniel, PROPOSED).** H1-H4 changed from `MountingHole_2.2mm_M2_Pad_Via` to `MountingHole_2.2mm_M2_Pad` (lab library, AharoniLab_Connector) in both the schematic footprint fields and the board, clearing the 32 hole_to_hole items; the plated pad still ties the screw to GND through the pour. U20 pad 9 (TLV3605 GND) set to a solid zone connection, clearing the starved thermal; other pads keep thermal reliefs for rework. The four LVDS diff-pair gap items (pad jogs into R180) and the uncoupled length (R87/C87 stub) are accepted without an exclusion, with the reasoning in the review README DRC table; the five silk-edge items (J50 and U60 outlines at the edge) and the U51/U52 silk overlap are accepted. DRC 11 items, 0 unconnected, ERC 0/0, parity 199 field notes. The G4 "DRC dispositioned in writing" item is satisfied by that table and must be re-checked against the final run before ordering. Not done, Daniel's call: no VBUS test point; no panel or rails; silkscreen text is Daniel's; the +5V pour around the regulators is Daniel's (hardware/pcb README copper section).
34. **VBUS transient suppressor D50 added: SMF5.0A unidirectional TVS at the J50 VBUS pins (2026-10-25, Daniel, PROPOSED, nothing measured).** Why: the TPD6E05U06 arrays protect CC, SBU, the USB pair and the LVDS/CAN pins (decision 14) but VBUS had nothing; the eFuse's overvoltage lockout handles a steady 6 V and reacts in microseconds, not the hot-plug ringing into C33, cable discharge or ESD on the VBUS pin. Part: industry-standard SMF5.0A, 200 W (10/1000 us), VRWM 5 V, VBR 6.4 to 7.0 V at 10 mA, VC 9.2 V at IPP 21.7 A, IR 200 uA at 5 V, ESD 30 kV, SOD-123FL (VERIFIED against the Panjit SMF5.0A series datasheet REV.13, 2024-03-06, docs/datasheets/smf5.0a-panjit.pdf; the Littelfuse SMF series is the intended vendor, LCSC C151296, its datasheet could not be retrieved). Fit: 5 V standoff sits above the 5.25 V USB maximum with 400 uA worst-case leakage class parts, breakdown stays above the eFuse OVLO trip (5.76 to 6.20 V, power.md) so the TVS never conducts in normal operation, and the 9.2 V clamp is far under the TPS2596 21 V absolute maximum (SLVSET8A). Library: lab PR #66 (branch `add-smf5.0a`, CI green) adds `AharoniLab_Passive:SMF5.0A` and `AharoniLab_Diode_SMD:D_SOD-123F`; the receiver working copy of the library is checked out on that branch until Daniel merges it. Schematic: D50 on the Connector sheet, cathode to a VBUS local label, anode to GND (ERC 0/0); designator range D50-D59 added to the Connector sheet. PCB: footprint parked on F.Cu at (71.55, 17.17) next to the VBUS entry (its cathode pad happens to land on the existing VBUS via at (71.35, 18.58)); Daniel places and routes it. DRC 11, 0 unconnected, parity 199 field notes.

## Standing corrections (from the prior design review)

Corrections 1, 4, 5, 7, 8 and 9 refer to the VCA821/AGC chain and are superseded by decision 12 (kept for history).

1. OPA857 OUT/OUTN are AC-coupled into the VCA821, never DC-wired. Rationale: OUTN is about 1.83 V; VCA821 +IN common-mode limit is +1.6 V.
2. Photodiode/APD cathode to positive bias (through the RC filter and current limit), anode to OPA857 IN; reverse bias is about cathode voltage minus 1.83 V. Rationale: sets polarity and real bias. Applies unchanged to the S12023-10 APD.
3. FDS010 capacitance is 6 pF typ at 10 V reverse bias. VERIFIED 2026-10-08 against Thorlabs 0636-S01 Rev I (March 16, 2017), docs/datasheets/fds010.pdf p.1; the older Rev E 2 pF figure is superseded. Pinout verified from the Rev I drawing (p.3): pin 1 anode, pin 2 case, pin 3 cathode.
4. +/-3.5 V is the VCA821 minimum; nominal rails +/-3.7 V (tolerance analysis pending). Rationale: margin above the minimum.
5. VCA821 RF is compensation; use datasheet networks; RG current limit about +/-2.6 mA can overload the input even at low gain. Rationale: stability and input overload.
6. Unity buffer plus diode is not a precision peak detector; the fast high/low detector is the main unresolved block, built as a disconnectable, swappable sub-circuit. Rationale: accuracy and risk isolation.
7. VSPAN subtractor: R41 VLOW->IN-, R42 OUT->IN-, R43 VHIGH->IN+, R44 IN+->GND, all 10k 0.1% matched. Rationale: ratio accuracy sets span error.
8. VMID: two matched 10k into a high-impedance buffer; threshold trim via a source selector or proper summing stage, never a resistor into a buffer output. Rationale: a resistor into a buffer output does not sum.
9. AGC is a true integrator (C in feedback), 100k/47 nF giving 4.7 ms; anti-windup acts on integrator state; freeze is not reset. Rationale: zero steady-state error and defined recovery.
10. Post-AGC span alone cannot prove signal presence; gain bounds, dwell and FPGA digital validity decide. Rationale: AGC amplifies noise to target.
11. TLV3605 SHDN is active-low; shutdown is not a guaranteed zero; LE/HYS low latches the last state; both constant LVDS states are "invalid" after an FPGA timeout on an independent clock. Rationale: avoid mistaking a stuck output for data.
12. FPGA watchdog runs on an independent local clock; reacquire CDR and framing after release; invalid-code counts are not a BER measurement. Rationale: watchdog must survive loss of recovered clock; counts miss errors.
13. SAMD51 DACs are 12-bit; OPA320 is single, OPA2320 dual. Rationale: correct resolution and part selection.
14. LM27762 positive/negative references differ (1.2 V vs 1.22 V), so rails use different divider ratios. Rationale: regulator limits. (The MAX15032 VIN+1 V bound, bias rail >= 6.5 V, applied to the PIN design and is retired with decision 8; the APD bias supply is selected in docs/research/apd-bias-supply.md.)
15. S12023-10/-05 TO-18 pins: 1 = anode, 2 = case, 3 = cathode (KAPDA0136EC pin diagram, bottom view). Rationale: the library symbol had K/A swapped until 2026-10-22 (decision 17); any new S12023 symbol or footprint must follow the drawing, and D10 on Rev A is rotated 180 degrees (tab toward the TIA).
