daharoni/photodiode-lvds-receiver/docs/datasheets/MANIFEST.md

# Datasheet archive manifest

These are the exact document revisions the design references. Any design claim (limits, typical values, pinouts, reference circuits) should cite the revision string in the table below, not just the part number. Files were downloaded 2026-10-08, verified to start with `%PDF`, hashed with SHA-256, and the revision string was read from the first pages with pdftotext. Downloaded files were treated as untrusted data and never executed.

| Part | File | Source URL | Revision/date string found | Retrieved (2026-10-08) | SHA-256 | Notes |
|---|---|---|---|---|---|---|
| OPA857 | opa857.pdf | https://www.ti.com/lit/ds/symlink/opa857.pdf | SBOS630D – DECEMBER 2013 – REVISED AUGUST 2016 | 2026-10-08 | ff31b2056049d38ecc709cf0d963f014972ca6c049194e74f7ce6ccf4430e07d | 34 pages |
| VCA821 | vca821.pdf | https://www.ti.com/lit/ds/symlink/vca821.pdf | SBOS407D – DECEMBER 2007 – REVISED MAY 2016 | 2026-10-08 | 3625a3a86b6b8dec2d3a1e91d238b196600ab8e44b6e64aee2926793f52628ef | 50 pages |
| TLV3605 | tlv3605.pdf | https://www.ti.com/lit/ds/symlink/tlv3605.pdf | SNOSDA2F – AUGUST 2020 – REVISED JUNE 2024 | 2026-10-08 | 7a062e2afdf47d828384d63f64d226c2ebce1b73db35f0667b5421ab8244f299 | Covers TLV3604/TLV3605/TLV3607; 35 pages |
| LM27762 | lm27762.pdf | https://www.ti.com/lit/ds/symlink/lm27762.pdf | SNVSAF7C – AUGUST 2016 – REVISED OCTOBER 2025 | 2026-10-08 | 465db259d11b3b2fe202661b21e1e664065ff8873056a984aa9f967a9fbdc6e0 | 30 pages |
| TPS799 (TPS79901) | tps799.pdf | https://www.ti.com/lit/ds/symlink/tps799.pdf | SBVS056L – JANUARY 2005 – REVISED FEBRUARY 2022 | 2026-10-08 | 6f15dd5753263303526ae3fb491751094cfc1512d51e7eb6b6306d02afc74f25 | 49 pages; revision history also lists "Revision L (September 2021)" |
| OPA356 / OPA2356 | opa356.pdf | https://www.ti.com/lit/ds/symlink/opa356.pdf | SBOS212A – NOVEMBER, 2001 | 2026-10-08 | 6d474fd4f44aabc1aa87aa3bf77ff53d9140fcd21132cf50ba46944f42fb6b4e | Old, legacy-format datasheet (20 pages); this is what TI currently serves |
| OPA320 / OPA2320 | opa320.pdf | https://www.ti.com/lit/ds/symlink/opa320.pdf | SBOS513F – AUGUST 2010 – REVISED DECEMBER 2016 | 2026-10-08 | 6ad9e31b95374c9bd582b821c528c91cb5813772e74e68f80cf81d0c10772b13 | 58 pages |
| TIDUAZ1 (TI reference design) | tiduaz1.pdf | https://www.ti.com/lit/ug/tiduaz1/tiduaz1.pdf | TIDUAZ1 – November 2015 | 2026-10-08 | d15ed9493375121a153d9f8f4791499ac5db714ef6b6af92c741f7c21793e3cc | 34 pages |
| Lattice ECP5/ECP5-5G sysIO Usage Guide (FPGA-TN-02032) | fpga-tn-02032.pdf | https://www.latticesemi.com/api/document/download?id=50464 (resolved from the ashx `document_id=50464` link, whose ashx path returned 404) | FPGA-TN-02032 1.4, January 2023 | 2026-10-08 | 47830ffc0c7a879c8458431a1861c82a7656d0015092826337a317a6b08ee5cc | 30 pages |
| Hamamatsu S5971 / S5972 / S5973 series | s5972.pdf | https://www.hamamatsu.com/content/dam/hamamatsu-photonics/sites/documents/99_SALES_LIBRARY/ssd/s5971_etc_kpin1025e.pdf | Cat. No. KPIN1025E10, Nov. 2019 ("current as of November, 2019") | 2026-10-08 | 436ce653adaf06e7e243b5d7db2e5273c19a24d16b895279a06ad3089439301f | One datasheet for the whole S5971/S5972/S5973 family; 5 pages; URL found via search, not from Hamamatsu's site index. The S5973 is listed at 1 GHz (VR = 3.3 V) |
| ULX3S schematic | ulx3s-schematics-v317.pdf | https://raw.githubusercontent.com/emard/ulx3s/master/doc/schematics_v317.pdf | Rev: 3.1.7 (title block, file ulx3s.sch; no date field populated) | 2026-10-08 | 0de010629af589ccaf7e72afeb413c4e2d1402ea75bd2b3a65dd110cf1933856 | 11 pages; highest-numbered schematics_v3xx.pdf in emard/ulx3s doc/ at retrieval. The repo is emard/ulx3s, not radiona/ulx3s |
| MAX15032 | max15032.pdf | user-supplied, retrieved by user 2026-10-08 | 19-4232; Rev 0; 8/08 | 2026-10-08 | 4673902dc85d77732d157d0a9c7a6552b2b437a9a2b8474b3b69f3ce92cad3d9 | Maxim-era original, 10 pages; analog.com direct download had failed |
| Thorlabs FDS010 | fds010.pdf | user-supplied, retrieved by user 2026-10-08 | 0636-S01, Rev I, March 16, 2017 | 2026-10-08 | 9ddfb35ecbe458a89cfd34c6a86d5372f66178557ccb23be1a219ce4def427e3 | 4 pages; capacitance 6 pF (Typ.) at 10 V; newer than Rev E (April 2010) |
| LT8365 | lt8365.pdf | user-supplied (analog.com), retrieved by user 2026-10-08 | LT8365 Rev. A | 2026-10-08 | c511973eed4b53a96d2e74d71d3646c59664bad470799bd469ba8db4efcd5025 | 150 V boost/SEPIC/inverting converter, 30 pages; APD bias candidate |
| DC2838A demo manual | dc2838a-demo-manual.pdf | user-supplied (analog.com), retrieved by user 2026-10-08 | DEMO MANUAL DC2838A Rev. 0 | 2026-10-08 | 7e69992a576d25f35dec23ff82ca1fb046d55e12a6d581e75f59f8a8df5c0746 | LT8365 250 V charge-pump boost demo, 6 pages |
| DC2838A schematic | dc2838a-schematic.pdf | user-supplied (analog.com), retrieved by user 2026-10-08 | 710-DC2838A Rev 02 PCA schematic | 2026-10-08 | 0bfed480a823ce337775f65d5ed2fd26409fdfae2a73be539e1a6ceffbd3b39c | 1 page |
| ESP32-C6-MINI-1 / MINI-1U module | esp32-c6-mini-1.pdf | https://www.espressif.com/sites/default/files/documentation/esp32-c6-mini-1_mini-1u_datasheet_en.pdf | Datasheet Version 1.5 | 2026-10-08 | 26691033f31cbebf623842c16624e61151b152533c13a850c091c8e858c510a2 | 53 pages; module controller |
| ESP32-C6 series | esp32-c6-datasheet.pdf | https://www.espressif.com/sites/default/files/documentation/esp32-c6_datasheet_en.pdf | Datasheet Version 1.5 | 2026-10-08 | 372a5b42b2900c83ef4309149c8835e9ae2d1be19244995bf2fb83af4dc5edf1 | 86 pages; chip-level pin tables (QFN32 in the module) |
| SN65HVD230/231/232 | sn65hvd230.pdf | https://www.ti.com/lit/ds/symlink/sn65hvd230.pdf | SLOS346O – MARCH 2001 – REVISED APRIL 2018 | 2026-10-08 | e98fc0c59168c035d7958111924dae7e21e46ab45bdfd6400aef048299d6d716 | 43 pages; 3.3 V CAN transceiver |
| TCAN330/332/334/337 (+G) | tcan334.pdf | https://www.ti.com/lit/ds/symlink/tcan334.pdf | SLLSEQ7F – DECEMBER 2015 – REVISED MAY 2025 | 2026-10-08 | bb89f067e6a7902867bf6b82eaab762167f403ae8464a29ec4f318ab0c71628f | 47 pages; alternative CAN transceiver, SOIC-8 or SOT-23 |
| MCP4728 | mcp4728.pdf | https://ww1.microchip.com/downloads/en/DeviceDoc/22187E.pdf | DS22187E (2010) | 2026-10-08 | 7e6515c45a02ffe4ad7506f3347cce7714cdd56659ff2fb22b858fc0472f381e | 68 pages in the PDF; 12-bit quad DAC with EEPROM |
| ADS1113/4/5 | ads1115.pdf | https://www.ti.com/lit/ds/symlink/ads1115.pdf | SBAS444E – MAY 2009 – REVISED DECEMBER 2024 | 2026-10-08 | eefff4d412ce2dcd7e659f47238edc9b2fa02e5971f2625af730502033701834 | 57 pages |
| TI app note SLLA270 | slla270.pdf | https://www.ti.com/lit/an/slla270/slla270.pdf | SLLA270 – January 2008 | 2026-10-08 | 10c315a683fa60954ba005d3392097a2e30cddcbf1eef10119a70d592b54ca81 | 15 pages; Controller Area Network Physical Layer Requirements (bus length, stub, termination) |
| OPA858 | opa858.pdf | https://www.ti.com/lit/ds/symlink/opa858.pdf | SBOS629B – APRIL 2018 – REVISED MAY 2025 | 2026-10-08 | 1ef6fb4a2199550fb81ff220c5b6fde83439651f6d01eb60c4a2c37e43eef4d0 | 38 pages; decompensated (gain >= 7) FET-input amplifier; post-amplifier candidate, research only (docs/research/post-amp-slicer.md) |
| THS4541 | ths4541.pdf | https://www.ti.com/lit/ds/symlink/ths4541.pdf | SLOS375B – AUGUST 2014 – REVISED FEBRUARY 2024 | 2026-10-08 | 89116b7887557237335675481ed80c5f3570b4d920d0b882393a877fb1796765 | 66 pages; fully differential amplifier, the OPA857 datasheet's reference partner; post-amplifier candidate |
| LMH6629 | lmh6629.pdf | https://www.ti.com/lit/ds/symlink/lmh6629.pdf | SNOSB18I – APRIL 2010 – REVISED DECEMBER 2014 | 2026-10-08 | 5c37f7b1b67bdd90eeef7b37839a5d8d898a41882d5efd5f7331ecf6e4ade2ff | 48 pages; selectable minimum gain 4 or 10; post-amplifier candidate |
| OPA855 | opa855.pdf | https://www.ti.com/lit/ds/symlink/opa855.pdf | SBOS622D – JULY 2018 – REVISED MAY 2025 | 2026-10-08 | c4f3b2ce2730ec03f1db499b335897c2bc94e0474b4891b2d86772850c55d374 | 41 pages; decompensated (gain >= 7) bipolar amplifier; post-amplifier candidate |
| ESP32-C6 Technical Reference Manual | esp32-c6-trm.pdf | https://www.espressif.com/sites/default/files/documentation/esp32-c6_technical_reference_manual_en.pdf | Technical Reference Manual Version 1.2 (PDF creation date 2026-03-22) | 2026-10-09 | e08d5b61ebcfa2a78f9735e3f721817cb1dc2df9cf05096d2f0399eaba9f1734 | 1394 PDF pages; used for Chapter 32 USB Serial/JTAG (printed pp.1027-1036), Chapter 9 boot control, Chapter 6 eFuse (docs/research/esp32-usb-tooling.md). Raw download kept in docs/research/downloads/esp32-c6-trm/ |
| TPS2120 / TPS2121 | tps2121.pdf | https://www.ti.com/lit/ds/symlink/tps2121.pdf | SLVSEA3F – AUGUST 2018 – REVISED AUGUST 2020 | 2026-10-09 | b2f5950f596dc2c4ca33e4ebac27fd35e4dcc68ea63e173466123e1118e91a06 | 45 pages; priority power mux, VQFN-HR RUX (TPS2121); USB/cable source selection (docs/research/usb-standalone-power.md). Cited page numbers are printed = PDF pages |
| LM66100 | lm66100.pdf | https://www.ti.com/lit/ds/symlink/lm66100.pdf | SLVSEZ8A – MARCH 2019 – REVISED JUNE 2019 | 2026-10-09 | 83c17370a97b85ecebe20605da0b955d4ff6f9a474e9692b611a6685d7ad0f00 | 23 pages; ideal diode, compared and rejected in docs/research/usb-standalone-power.md |
| ESP32-C6 Hardware Design Guidelines | esp32-c6-hw-design-guidelines.pdf | https://docs.espressif.com/projects/esp-hardware-design-guidelines/en/latest/esp32c6/esp-hardware-design-guidelines-en-master-esp32c6.pdf | "Release master", cover date Oct 09, 2026 (no version number; the "master" docs build changes) | 2026-10-09 | e5a97cc11e1d72c57d5ece7930d8c5b9723dd1a6ec8d6e8030df0f2b63118ef3 | 34 pages; page numbers cited are PDF pages (the printed footer numbers differ) |
| ECP5 / ECP5-5G Family Data Sheet (FPGA-DS-02012) | ecp5-ds-02012.pdf | https://www.latticesemi.com/api/document/download?id=50461 | FPGA-DS-02012 v3.4 | 2026-10-09 | 26570f8bb2b800123120829cacd75d818d7a985d573797610521b5bda2e293c3 | 115 PDF pages; LVDS input levels (Table 3.13), absolute maximum (Table 3.1), used by docs/research/lvds-fanout-and-foreign-host.md. Moved here from docs/research/downloads/lvds-fanout/ on 2026-10-09 |
| Yageo RC0805 chip resistor | yageo-rc0805.pdf | https://atta.szlcsc.com/upload/public/pdf/source/20241220/00AD28EFA6A844A28EB4F5A6DA9DB82F.pdf (LCSC-hosted copy of the Yageo specification; yageo.com served HTML instead of the PDF) | Yageo RC0805 specification, Version 0, 2016-07-26 | 2026-10-22 | baa3aa0412b3d5bba7e102cf8c7e3f213b90f0449e5dbfb3ec0a8d1cf227d5fc | 6 pages; p.3 Characteristics: Maximum Working Voltage 150 V, Maximum Overload Voltage 300 V. Cited for R17/R18/R20/R32 (decision 22) |
| TLV431 | tlv431.pdf | https://www.ti.com/lit/ds/symlink/tlv431.pdf | SLVS139Z – JULY 1996 – REVISED JUNE 2024 | 2026-10-22 | 6999c7cde8d7d7684045d82f6655e2dc37bf604ee913a693a2cc71f186b6ae2e | 58 pages; p.3 DBZ pinout (1 REF, 2 CATHODE, 3 ANODE), p.5-7 EC table: VREF 1.24 V (A grade 1 %), I_ref 0.15/0.5 uA, I_K(min) 55/80 uA. Cited for the HV over-voltage limiter U6 (decision 23) |
| SMF5.0A (VBUS TVS, D50) | smf5.0a-panjit.pdf | https://www.panjit.com.tw/upload/datasheet/SMF5.0A_SERIES.pdf | SMF5.0A_SERIES-REV.13, March 6, 2024 (Panjit; the Littelfuse SMF series datasheet, the primary vendor, LCSC C151296, could not be retrieved on 2026-10-25: littelfuse.com, Mouser and LCSC mirrors returned HTML) | 2026-10-25 | 23bc9b233d890a6b983a6d719d3fb9c8bec028d33570494bb7fd99655f2bac94 | 5 pages; SMF5.0A row p.1 (VRWM 5 V, VBR 6.4-7.0 V at 10 mA, IR 200 uA, PPP 200 W, VC 9.2 V at IPP 21.7 A, marking HE); SOD-123FL outline and pad layout p.4 |

## Not retrieved

None. (MAX15032 and FDS010 were supplied by the user.)
