daharoni/photodiode-lvds-receiver/docs/review/2026-10-22-rev-a-review/approach-and-readiness.md

# Rev A review: overall approach, system consistency, readiness (2026-10-22)

Reviewer scope: approach and system-level consistency only (not pin-level or trace-level). Repo read-only. Labels: VERIFIED = checked against a cited doc/datasheet/file in this review; PROPOSED = my reasoning or arithmetic (inputs stated); UNRESOLVED = could not be settled from documents. My arithmetic script: `/private/tmp/claude-503/-Users-daharoni-Projects-photodiode-lvds-receiver/729f0522-0bd4-4b22-86e6-0dd98284920e/scratchpad/work-approach/lb.py` (stdlib Python; outputs quoted below). Nothing here is measured.

## Executive summary

1. I found no BLOCKER inside my scope: the analog-first architecture is coherent, the HV-off-by-default gate is fail-safe by construction, and the USB-C foreign-host analysis is careful. The board can be ordered as an experiment board; the open question is whether the OPTICAL LINK closes, which this board cannot answer by itself.
2. MAJOR: the link-budget headline ("APD + a modestly brighter NIR emitter closes the link", decision 8) rests on an energy-conservation error in the APD sweep (30 mW/sr over a 140 degree beam "from 25 mW average electrical" implies 229 % wall-plug efficiency) and on a 35 MHz noise bandwidth where the as-built chain has about 70 MHz. My redo: Q = 6 at 35 cm lateral needs about 6-12 mW/sr (23-46 mW optical flux), i.e. roughly 40-180 mW average electrical per emitter against the stated ~200 mW whole-headstage budget, with the best APD gain at M about 86-114 (at or above the S12023-10 M max of 100), not M 35-60.
3. MAJOR: the "39 dB single-setting + 32 dB firmware" range figures are electrical (20 log I) dB. In optical power they are about 16-25 dB (fixed setting) and about 16 dB (firmware). Firmware range control only extends toward STRONG light; at the weak end there is no knob left, so fade margin equals emitter margin.
4. MAJOR (spec consistency): "module decodes with the ESP32 unprogrammed" (CLAUDE.md hard rule 1, decision 12, architecture) is false as built unless the DNP bench jumper J1 is fitted: an unprogrammed ESP32 means HV_DIS is pulled high, so the APD bias is OFF and there is no signal. HV safety design is right; the claim needs rewording and a gate item.
5. Readiness: ERC clean and routing complete, but G4 pre-order items are only partly done (JLCPCB impedance calculator not run, 52 DRC items not dispositioned in docs, no FPGA-end breakout board, no defined G1 optical test source, no enclosure), and four authority/derived docs still say "nothing is routed".

## Findings

### MAJOR

**A1. Link-budget emitter power is not physically consistent; the APD "closes the link" claim is overstated.**
- Location: docs/calculations/link-budget.md, APD sweep Table B and "What this means" item 4; decision-log entry 8; requirements row 2 ("modestly brighter NIR emitter").
- Saw: "S12023-10 30 mW/sr 140deg ... I = 33.3 mA, Pavg 25.0 mW" with the footnote "targets at 0.9 mW/sr/mA". 0.9 mW/sr/mA is the SFH 4715AS figure (+-45 degree class, 900 mW/sr at 1 A, link-budget.md assumptions table), applied here to a 140 degree beam.
- Why it matters (PROPOSED arithmetic, lb.py): flux of a cos^m beam = Ie x 2 pi/(m+1), m = 0.646 (the doc's own value for 140 degrees). 30 mW/sr gives 115 mW optical flux; the doc's drive is 33.3 mA x 1.5 V = 50 mW peak electrical, so the implied wall-plug efficiency is 229 %. The only 140 degree emitter datasheet in the doc (QBLP601-2IR4, 1.0 mW/sr at 20 mA, 1.5 V assumed) gives flux 3.8 mW from 30 mW, i.e. 12.7 % efficiency, versus the 30 % "WPE ASSUMED (optimistic)" in the same doc. At 12.7-30 % efficiency the 30 mW/sr case costs 190-450 mW average electrical, not 25 mW. Also 30 mW/sr is 12x (10.8 dB) the reference QBLP601 at 50 mA (2.5 mW/sr), which is not "modest".
- My Q=6 requirement (see link-budget table below): 11.5-12 mW/sr with the as-built 70 MHz noise bandwidth (5.9 mW/sr with the doc's 35 MHz), flux 44-46 mW (23 mW), average electrical at 50 % duty 73-76 mW at 30 % efficiency or 169-176 mW at 13 % (38 / 88 mW for the 35 MHz case). The stated headstage budget is "about 200 mW average for the whole headstage (~500 mW wireless power)" (link-budget.md). So closure at 35 cm lateral looks marginal to infeasible with an LED of QBLP601-class efficiency unless the coverage target, optics (etendue allows 2x at +-45 degrees), or receiver count changes.
- Fix: correct Table B (derive current from flux and a measured/datasheet efficiency, not from mW/sr/mA of a different part); restate decision 8's consequence as "needs ~10x the reference emitter intensity, ~45 mW optical flux at 35 cm lateral; headstage power feasibility UNRESOLVED"; get Daniel's emitter co-design numbers before claiming closure. Do not change decision 8 (APD still the right direction: the PIN needs 129-254 mW/sr, VERIFIED arithmetic in the doc), but the "modestly brighter" wording should go.
- Confidence: HIGH on the inconsistency; MED on my absolute thresholds (they depend on R = 0.47 A/W graph read, 0.9 transmission, ambient 0, and the flat-density noise scaling).

**A2. Noise bandwidth and optimum M in the budget do not match the built chain.**
- Location: link-budget.md method item 5 (B = 35 MHz, "ASSUMED"), architecture.md signal-chain item 6 ("Q(M) peaks at M 35-60"), apd-bias-design.md.
- Saw: TIA noise is scaled as 15 nA x sqrt(35/135) = 7.64 nA (low bound), and Q is computed for B = 35 MHz (0.7 x bit rate). As built: OPA857 -3 dB 99-106 MHz (SIMULATED 99 MHz at 6 pF; datasheet 105 MHz at 1.5 pF, SBOS630D p.6, VERIFIED), then a 68 MHz low-pass (R56 49.9 / C54 47 pF), so the noise equivalent bandwidth is about 65-75 MHz, not 35 MHz. No matched or 35 MHz filter exists in the chain.
- Why it matters: TIA noise rises by sqrt(2) = 1.4x (flat-density assumption, which the doc itself calls a lower bound because the e_n x C term rises with frequency; at 6 pF the datasheet-plot read is 26 nA at 135 MHz). That is about 1.5 dB optical. It also moves the Q-optimal M up: my redo finds Q-max at M = 86-106 for the 12 mW/sr case (M = 92-149 at lower signal), versus the doc's M 35-62 (30 mW/sr case) and M 93 for the QBLP601 case. The S12023-10 datasheet M max is 100 (link-budget assumptions table). Operating near M max means the bias tempco matters most (about 7 %/V of gain, calc doc 3.2; residual +-0.7 V over 15-35 C gives +-5 % gain), the per-unit VBR spread (150 typ / 200 max) matters most, and the firmware "trim toward the Q optimum" has almost no upward headroom.
- Fix: rerun `tools/link_budget.py` with B about 70 MHz and the 6 pF noise column (the doc says "not scripted"); update the Q(M) optimum statement in architecture.md; consider whether a 35-40 MHz filter in place of 68 MHz (R56/C54 swap, both 0402-class parts, no layout change) buys back the 1.5 dB at the cost of ISI (PROPOSED, trade needs the G1 eye).
- Confidence: HIGH on the bandwidth mismatch; MED on the size of the effect.

**A3. "39 dB / 32 dB" ranges are electrical dB; optical ranges are half as large, and range control only extends the strong end.**
- Location: decision-log 12, architecture.md item 6, post-amp-slicer.md section 3, gates G2 ("~39 dB single-setting window").
- Saw: "63-126x (36-42 dB)" is a current ratio (20 log). Photocurrent is proportional to optical power, so optical dB = half. PROPOSED, lb.py: Q = 6 at the OPA857 20k stage needs Ipp of about 0.22-0.29 uA (12 x 18.7-24.3 nA); the post-amp clip is 7.9-9.0 uA at 20k (1.0-1.15 Vpp over 7 x 18.2 k; datasheet VOL 1.05/1.15 V and VOH 2.35 V, SBOS622D p.6-7, VERIFIED, gives only +0.5 V low-side headroom from a 1.65 V baseline, so the doc's 9.0 uA is the optimistic end); the TIA itself saturates at 60 uA (OPA857 p.15, VERIFIED in frontend.md). So the clean-linear window is 31-32 dB electrical = about 15.5 dB optical, and the clipped-but-slicing window to 60 uA is about 49 dB electrical = about 24.5 dB optical. Firmware adds M 50 to 5 (20 dB electrical = 10 dB optical) and 20k to 5k (12 dB electrical = 6 dB optical): 16 dB optical, not 32.
- Why it matters: (a) the expected arena spread (about 3 dB optical lateral, 6 dB per halving of height, plus orientation, shadowing and tilt, which are unmeasured) is compared in the doc to the 30-36 dB figure as if optical; (b) every firmware knob lowers gain. Fade-in (weak light) has NO remedy: M is already near its maximum at the Q=6 point (A2), 20k is already the high-gain mode. The link's fade margin is therefore exactly the emitter margin at the receiver, which A1 says is the thin part.
- Fix: restate ranges in optical dB with both unit conventions; add an explicit "weak-end margin" row to the budget (dB between operating point and Q=3.09 / Q=6 floor).
- Confidence: HIGH (units), MED (clip levels until G1 clip test).

**A4. "Module decodes with the ESP32 unprogrammed" is not true without J1; no gate tests the analog-only mode.**
- Location: CLAUDE.md Purpose and hard rule 1; architecture.md signal chain item 6 ("With the ESP32 unprogrammed the module runs at the resistor-set bias and 20k") and state table (POWER-UP "ESP32 verifies DAC EEPROM, enables HV"); docs/schematic/power.md "HV disable logic".
- Saw: power.md table: "HV_DIS high, or ESP32 unprogrammed/Hi-Z (R33 pulls the gate to 3V3_D) -> Q3 on -> EN/UVLO pulled to GND -> HV OFF". J1 "HV FORCE ON" is DNP and described as "bench only". architecture.md item 11 itself says "HV stays off until HV_DIS is driven low or the J1 bench jumper is fitted". So the same document set says both things.
- Why it matters: the firm user rule (analog-first) is that slicing does not depend on firmware. As built, the APD has no bias, hence no signal, until firmware (or J1) enables it. That is the correct safety choice (HV off by default), but then the rule should read "with J1 fitted the module slices with no firmware", and a gate should prove it (blank ESP32, J1 fitted, DAC default/Hi-Z gives the 136 V resistor-set bias per calc doc 3.2, TIA 20k default, LVDS valid). Note also that with J1 fitted HV starts at the DAC pin default with no ramp and no firmware fault supervision (a faulted HV start can trip a USB port, decision 13): bench only.
- Fix: reword in CLAUDE.md/architecture/decision 12; add a G1 item "ESP32 blank, J1 fitted: decode with HV from the resistor-set bias"; fit J1 on first-article boards (a 2-pin header, no layout change).
- Confidence: HIGH.
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
