daharoni/photodiode-lvds-receiver/docs/review/2026-10-22-rev-a-review/pcb-fastpath-hv.md

# PCB layout review: fast analog path, HV bias island, APD/TIA input, LVDS to fan-out (Rev A, 2026-10-22)

Reviewer scope: placement and routing of the fast chain, the LT8365 HV island, the APD/TIA input region and the comparator LVDS output up to the fan-out. Read-only. All coordinates are doc coordinates (file minus 50,50). Measurements come from a COPY of the board (`work-fastpath/receiver-module.kicad_pcb`, zones refilled in `work-fastpath/filled.kicad_pcb`) queried with KiCad 10.0.5 pcbnew Python; scripts are in `.../scratchpad/work-fastpath/` (dump.py, clr.py, pair.py, par.py, refpl.py). Distances quoted as "gap" are copper-to-copper edge distances computed from the shapes (bisection on `SHAPE::Collide`), not centre distances.

## Executive summary

1. The fast chain is compact and clean: about 20 mm from D10 pad 3 to U20 pin 4, all on F.Cu, zero vias on any signal node of the chain (the only vias are decoupling GND/3V3), solid GND1 under every fast segment except the intentional TIA window. TIA_IN is 3.91 mm, 0.15 mm wide, one segment pair, no via, and no copper exists on any layer inside the TIA_IN_WINDOW. The HV island has 0 DRC violations against live HV rules and the nearest HV-to-other-net copper everywhere is at or above 1.0 mm (1.25 mm pad rule respected).
2. MAJOR: D10 pad 1 (HV_K, up to 220 V) is only 0.35 mm from pad 2 (case, GND) on F.Cu; the DRC rule "hv same footprint pads" (0.15 mm) hides it, and it is below even the project's own "0.4 mm external coated" figure. HV_K to the TIA_IN pad is 1.34 mm (calc doc rule says >= 2 mm). The 1.65 mm of HV_K trace also passes under the grounded can flange.
3. MAJOR: the cathode filter cap C50 is 6.78 mm of trace from the D10 K pin (calc doc 7 rule 6 asks <= 3 mm); the OPA855 has no plane cut-out under IN-/FB/OUT although SBOS622D 9.4.1 and Fig. 9-12 (p.29) ask for it, and TP10 hangs a 2.5 mm stub plus 1 mm pad on the OPA855 OUT pin ahead of R56.
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
