daharoni/photodiode-lvds-receiver/docs/research/downloads/fdsp-2.png

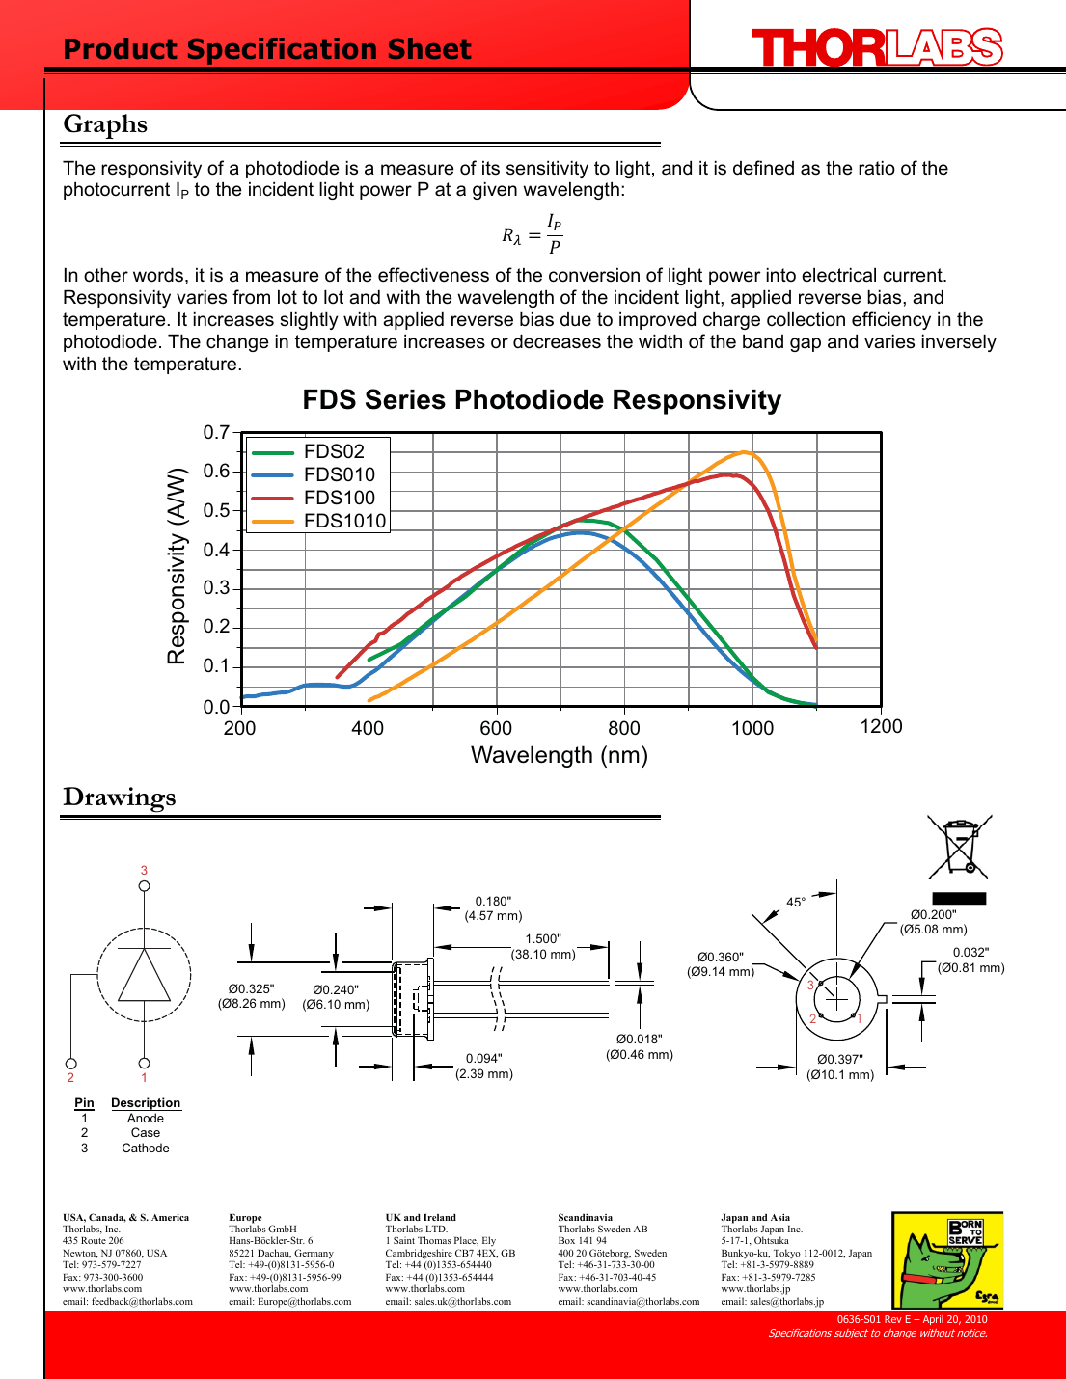
docs/research/downloads/fdsp-2.png
