daharoni/photodiode-lvds-receiver/docs/review/2026-10-22-rev-a-review/s12023-outline1-pin-diagram-1200dpi.png

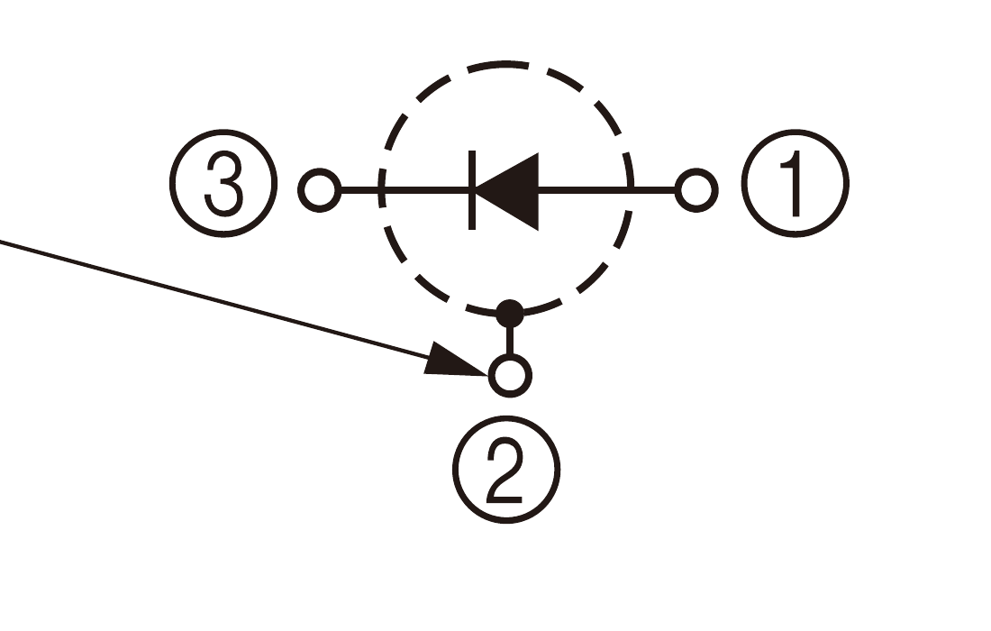
docs/review/2026-10-22-rev-a-review/s12023-outline1-pin-diagram-1200dpi.png
