daharoni/photodiode-lvds-receiver/docs/simulation/plots/opa855-parasitic-ac.png

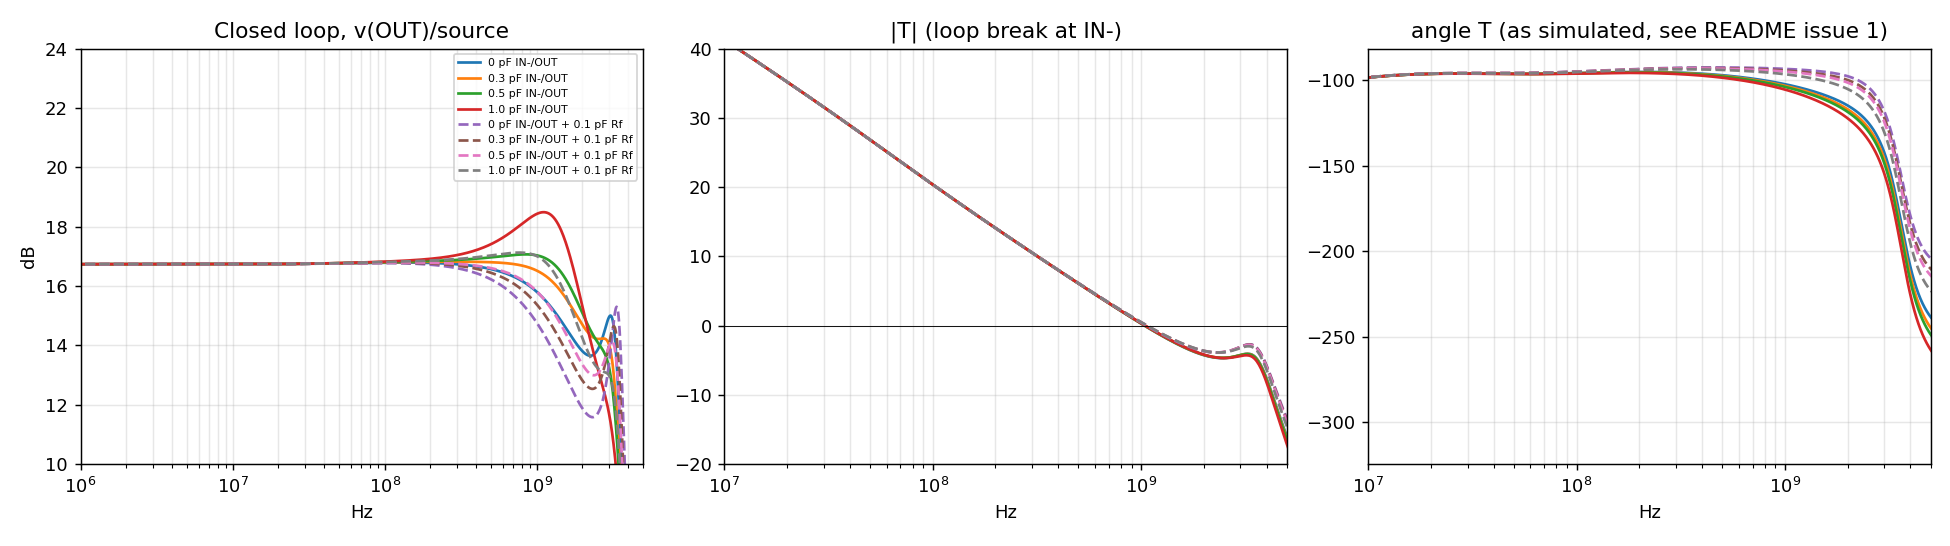
docs/simulation/plots/opa855-parasitic-ac.png
