daharoni/photodiode-lvds-receiver/docs/simulation/plots/sim1_closed_loop_ac.png

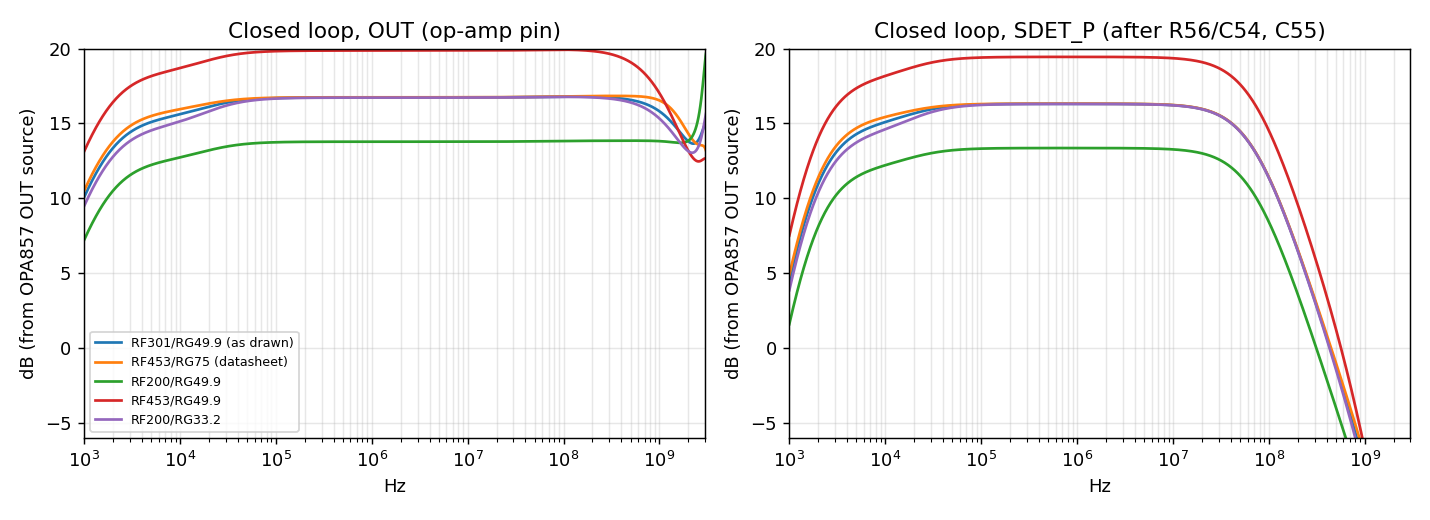
docs/simulation/plots/sim1_closed_loop_ac.png
