daharoni/photodiode-lvds-receiver/docs/simulation/plots/sim1_loop_gain.png

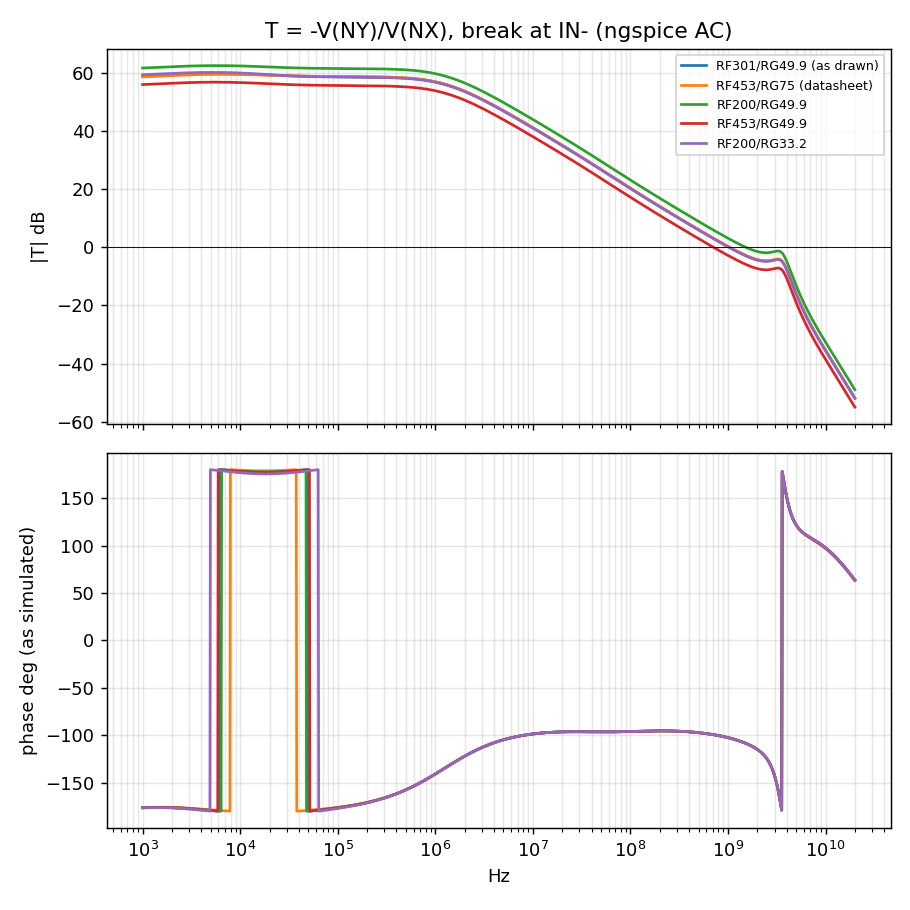
docs/simulation/plots/sim1_loop_gain.png
