daharoni/photodiode-lvds-receiver/docs/simulation/plots/sim1_transient.png

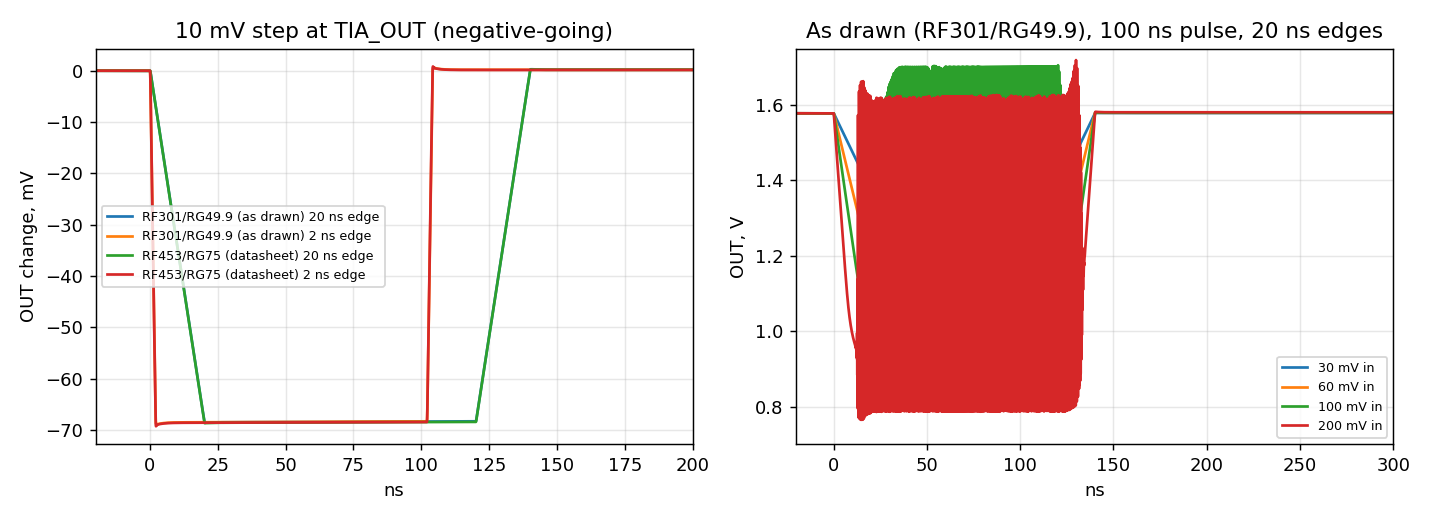
docs/simulation/plots/sim1_transient.png
