daharoni/photodiode-lvds-receiver/docs/simulation/plots/sim2_tia.png

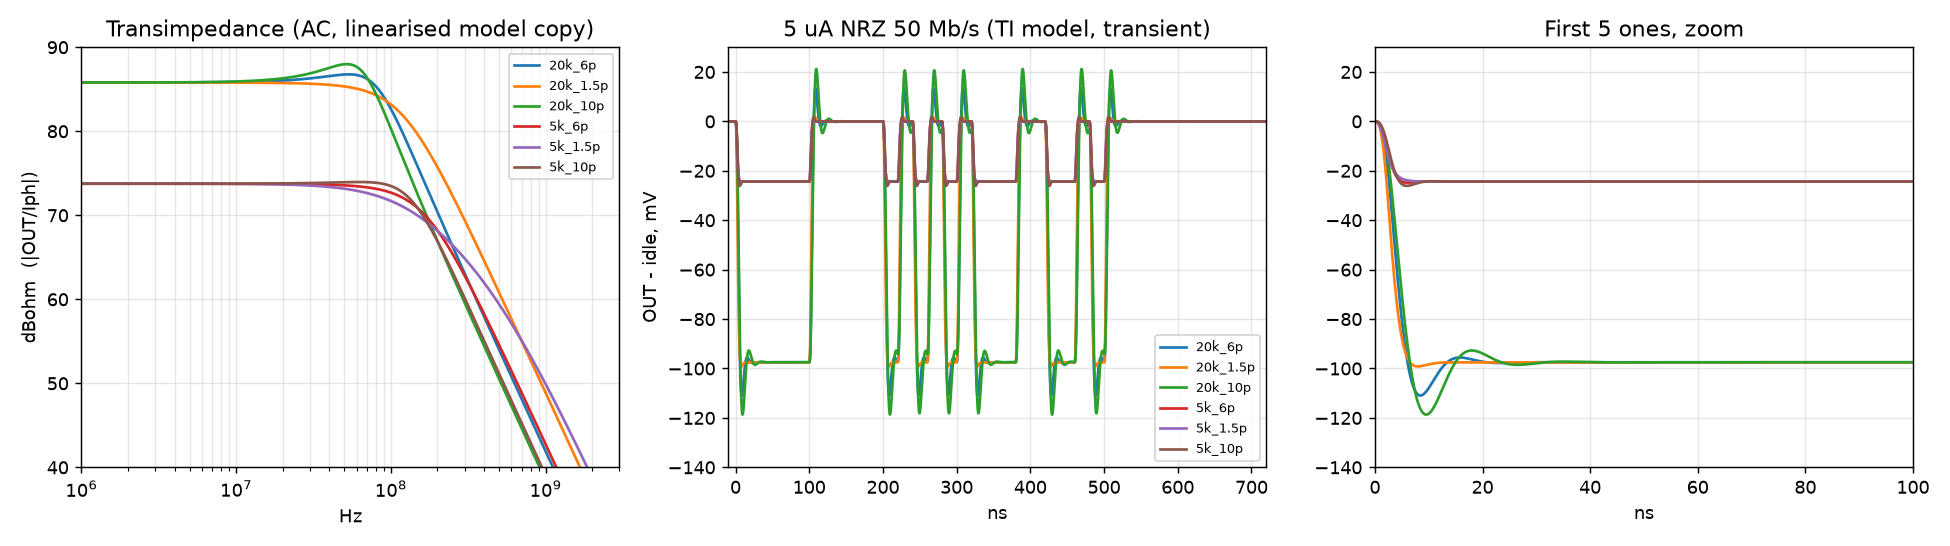
docs/simulation/plots/sim2_tia.png
