daharoni/photodiode-lvds-receiver/docs/simulation/plots/sim3_closed_loop_ac.png

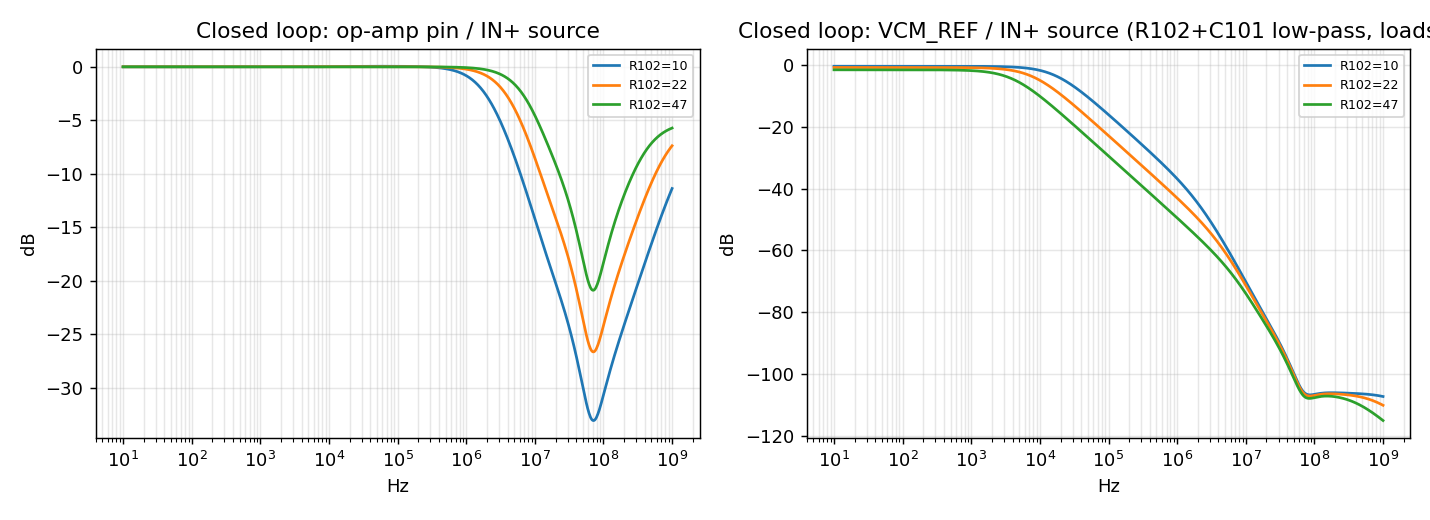
docs/simulation/plots/sim3_closed_loop_ac.png
