daharoni/photodiode-lvds-receiver/docs/simulation/plots/sim3_loop_gain.png

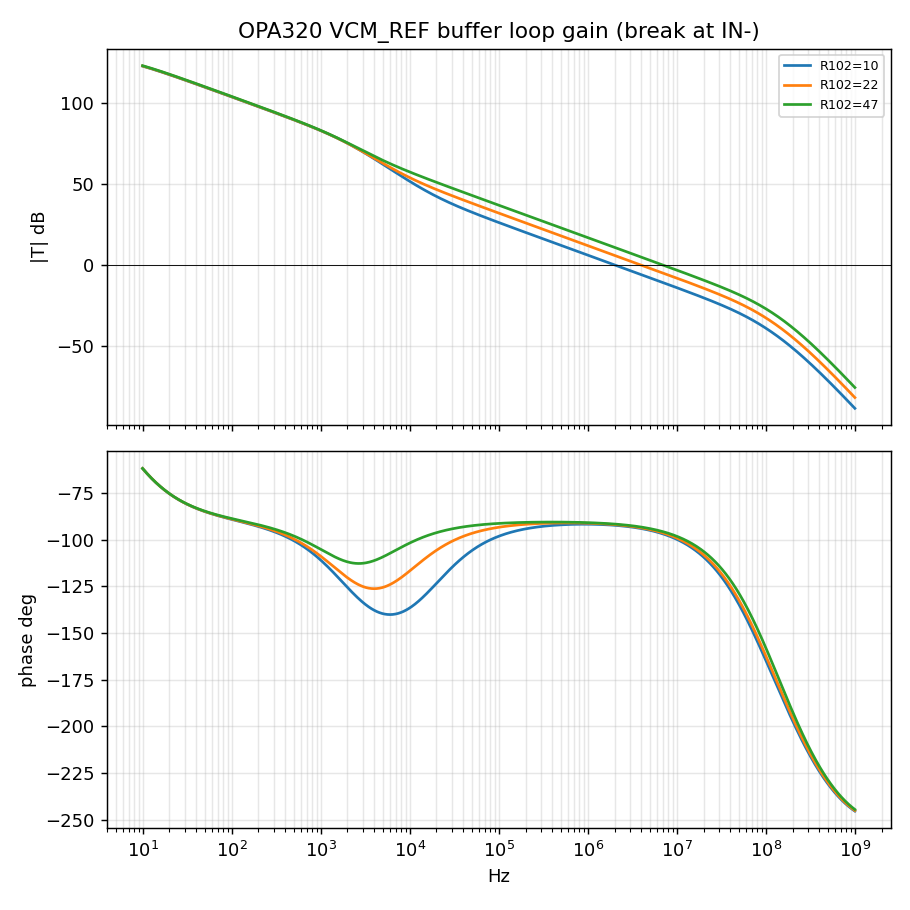
docs/simulation/plots/sim3_loop_gain.png
