daharoni/photodiode-lvds-receiver/firmware/esp32/components/app_telemetry/README.md

# app_telemetry

Status: PROPOSED; compiles (ESP-IDF v5.5.5, esp32c6, 2026-10-12, built against stand-in headers for the other agent's components); not run on hardware.

Event and stream lines go through a 12-line queue drained by a prio-1 `printer` task that writes only while `usb_serial_jtag_is_connected()` and counts drops (`app_telemetry_print_drops()`, shown by `status`); the console's own replies still use printf. CAN TLM_ANALOG/STATE/SLOW frames (only in bus mode), NDJSON stream and `status -j` line, 64-entry event ring, LED patterns, identify. dac_hv, can_tec/can_rec and selftest_last are not available from the contracts and are null or fixed (see source comments).
