daharoni/photodiode-lvds-receiver/docs/receiver-guide.html

Aharoni Lab, UCLA · Miniscope wireless uplink

# Receiver Module Field Guide

- Rev A
- Spec revision 4
- Decisions through 14
- Generated 2026-10-12 from the repo docs at commit fa05e58

This guide is derived. It is a reading aid built from docs/. The authority is docs/requirements.md, docs/decision-log.md, docs/architecture.md and docs/bringup/gates.md. If this page and those documents disagree, they win. Regenerate this page whenever they change. Nothing on this page is measured. Labels are copied from the sources and never upgraded.

01 · Start here

## What the module is

An optical receiver module for the next-generation wireless UCLA Miniscope data uplink. A silicon avalanche photodiode turns the light stream into current, a fast analog chain turns it into one LVDS pair, and that pair travels down a USB-C cable to an ECP5 FPGA (ULX3S first). Each module also carries a small ESP32-C6 that does slow housekeeping only.

Line rate is 50 Mbps with 8b/10b coding (UI = 20 ns, 40 Mbps payload). Performance beats cost. No backward compatibility with the Miniscope Zero headstage is required; the headstage emitter, driver and encoder are co-designed with this receiver. PROPOSED

50 Mbps8b/10b line rate, UI = 20 ns, 40 Mbps payload

6 sheets221 components, 144 nets, ERC 0 errors 0 warnings

100-220 Vprogrammable APD bias, temperature tracked, HV off by default

4 gatesG1 to G4 in docs/bringup/gates.md, none started

### Status on 2026-10-12

Item | State
Schematic | Complete for Rev A: six sheets (Power, Front End, Slicer, Monitor, Connector, Controller), spec revision 4. Project ERC 0 errors, 0 warnings (kicad-cli 10.0.5). Generators frozen since 2026-10-09; schematic edits now go through the KiCad GUI with the docs updated by hand.
Layout | Started. 225 footprints placed (222 components plus H1-H4) on a 75 x 50 mm placeholder outline by a first-pass script, 0 courtyard overlaps. Routing is complete (0 unconnected pads; DRC 11 items (2026-10-25: 5 silk-edge, 4 LVDS diff-pair gap, 1 uncoupled, 1 silk overlap, all accepted in writing in the 2026-10-22 review README; all vias epoxy filled and capped, decision 30). Not fabrication-approved; G4 pre-order checks are open.
Simulation | Three ngspice runs with TI models (OPA855 post-amp, OPA857 at 6 pF, VCM_REF buffer). Labelled SIMULATED, not VERIFIED. Section 08.
Measurement | Nothing is measured. No received-power measurement exists; the link budget is an estimate from LED datasheets. No bring-up gate has started.
Not yet designed | FPGA-end breakout board, enclosure, host link from FPGA to a computer. The ESP32 firmware (firmware/esp32/) and the ECP5 gateware (firmware/ecp5/) exist as skeletons with host and simulation tests; neither has run on hardware.

### Label legend

Label | Meaning
VERIFIED | Checked against a datasheet or measurement that is cited next to the claim.
PROPOSED | Design intent. Not yet proven.
SIMULATED | Result of an ngspice run with a TI macromodel. No parasitics, no tolerances, not hardware. Never counts as verified.
UNRESOLVED | Open. Needs a measurement, a datasheet that was not read, or a decision.
calculated | Arithmetic from datasheet values. Not simulated, not measured. Used alongside PROPOSED.

Citation short forms: SBOS630D is the OPA857 datasheet, SBOS622D the OPA855, SNOSDA2F the TLV3605, SLLS396G the SN65LVDS104, SLVSET8A the TPS2596x eFuse family. Page numbers are as the source docs give them.

#### Hard rule: analog first

Slicing is analog and the signal path from APD to LVDS needs nothing from the ESP32. The APD bias is enabled only by the provisioned ESP32 (decision 20, HV_DIS interlock), so an unprogrammed module is safe but dark (decision 21). The ESP32-C6 is not in the signal path. It does slow range trim (APD bias DAC, TIA 20k/5k select), monitoring, HV gating, module identity and the CAN link. This is a firm user decision (decision 1, read through decision 12). Do not propose an MCU/ADC-first architecture.

#### What changed since the old guide

The older "Engineering Field Guide" (FDS010 PIN diode, VCA821 VGA, analog AGC, peak detectors, +/-3.7 V rails, MAX15032 bias, SAMD51) is history. The decisions that replaced it:

- Decision 8 (2026-10-08): silicon APD instead of a bare PIN. The link budget showed a bare FDS010 18-23 dB short. The FDS010 D11 footprint was dropped from Rev A on 2026-10-09.
- Decision 9 (2026-10-08): APD bias made on the board by an LT8365 boost plus charge-pump doubler, not a purchased HV module.
- Decision 11 (2026-10-08): an ESP32-C6 on every module, CAN to the FPGA side, no BLE.
- Decision 12 (2026-10-08): fixed-gain OPA855 post-amp and a baseline slicer replace the VCA821, the AGC loop and the peak detectors. Standing corrections 1, 4, 5, 7, 8, 9 are superseded.
- Decision 13 (2026-10-09): a laptop can program and verify any module over USB alone. Its TPS2121 two-source mux is superseded by decision 14; the requirement is kept.
- Decision 14 (2026-10-09): one 24-pin USB-C receptacle per module replaces the 12-pin header and the 16-pin USB-C; TPS259631 eFuse replaces the TPS2121; SN65LVDS104 fans the LVDS onto both TX pairs.

### Requirements in one place

- Rate 50 Mbps, 8b/10b, soft target (higher welcome, lower acceptable). Miniscope Zero tops out near 12 Mbps. PROPOSED
- NIR emitter preferred; one module supports 630 nm and 765 nm with a swappable filter. The optical bandpass filter is mandatory because ambient light is multiplied by the APD gain M. PROPOSED
- The module sits in a 6.63 MHz QSCR wireless-power field that is in-band for the receiver, so it lives in a shielded aluminum housing. Shielding, not filtering, handles it.
- Provisional goals, not approved requirements: BER <= 1e-9, reacquisition <= 20 ms, loss-of-signal detection within 1 ms by the FPGA decoder validity on an independent-clock timeout (there is no analog LOS since decision 12; requirements.md item 3 and 6, architecture.md states table). UNRESOLVED
- One PCB, hierarchical sheets. No size constraint now; condense after validation.

02 · Signal chain

## From photons to one LVDS pair

Every block is there for a reason that comes from the one before it. The diode is a current source with large capacitance, so it gets a transimpedance stage first. Ambient light would be multiplied by the gain, so everything after the TIA is AC coupled. The comparator needs more than a few millivolts of signal to ignore its own offset, so a fixed-gain amplifier sits ahead of it.

Block diagram. Derived from architecture.md and the as-built sheet notes. Block-level only, not a netlist. PROPOSED

### 2.1 APD and its bias filter

Why an APD. Photocurrent into a bare FDS010 PIN is about 1-3 nA, far below the TIA's noise (about 8-26 nA), so a bare PIN was 18-23 dB optical short of Q = 6 at 35 cm lateral with any emitter that fits the headstage power budget. An APD with gain M closes the link, but not with a "modestly brighter" emitter: the corrected budget (decision 31, link-budget.md revision 2026-10-22) needs about 11 to 12 mW/sr on axis over 140 degrees for Q = 6 at 35 cm lateral on the direct path alone, about 4.5 to 4.8x the reference QBLP601 at 50 mA, at the built 70 MHz noise bandwidth with the APD at M 83 to 100. Three credits reduce that and are recorded with their assumptions, not as margin: optics on the direct path (étendue-limited, 2x at +/-45 degrees, 8.5x at +/-20; optics cannot raise the diffuse term), the reflective arena (an integrating-sphere estimate puts the diffuse term on the die at or above the direct term for 0.5 to 0.7 wall reflectance; reflectance at 850 nm unknown), and receiver tiling with FPGA selection (3 dB geometrically at 50 cm height, mainly it removes orientation and shadowing from the margin). Working emitter assumption: 1 W class 850 nm LED at 30 to 100 mA on-state, up to 200 mA without the credits. Calculated from LED datasheets, no received power measured; the arena measurement is a G1 pre-board item. PROPOSED

- Primary: Hamamatsu S12023-10, phi 1.0 mm, 6 pF, VBR 150 V typ / 200 V max, operating about 120-190 V for M = 50-100, dVBR/dT about 0.65 V/C, TO-18 with window. Fallback: S12023-05, phi 0.5 mm, 2 pF. The FDS010 is bench-only and is not on the board. PROPOSED Per-unit operating voltage is UNRESOLVED until G1.
- Use 6 pF for the S12023-10 and the FDS010 alike (standing correction 3: FDS010 6 pF typ at 10 V, VERIFIED Thorlabs 0636-S01 Rev I p.1).
- Polarity: cathode to the positive bias through R50 10k (200 V rated, 1206; series current limit) and C50 10 nF (500 V C0G, rating now in its Value field, at the cathode: its pad 4.43 mm from the cathode pad on the board since decision 26, as close as the can courtyard allows); anode to the OPA857 IN. D10 sits on a 1.5 mm insulating TO-18 spacer (decision 26) so the grounded header is over air, not solder mask, above the 220 V pad and track; the datasheet outline has no standoff. Reverse bias is about cathode voltage minus 1.83 V. This is the OPA857 reference arrangement VERIFIED SBOS630D p.19, 8.2.1.2 step 2.
- The HV node needs 200 V creepage and clearance and a keep-out from the TIA input. The anode-to-IN trace is the shortest on the board with no HV copper near it.
- Ambient light is multiplied by M, so the optical bandpass filter is mandatory and the OPA857 20k linear range (60 uA at the input) is the saturation bound.

### 2.2 OPA857 transimpedance stage

Why first. The diode is a current source with large capacitance. Converting to voltage at the source keeps noise and bandwidth under control before any gain stage.

- CTRL selects 20k or 5k feedback. A 100 k pull-up (R57) to 3V3 gives logic 1 = 20k, so an unprogrammed module runs at 20k. JP10 is an open solder jumper. Single-ended transimpedance is 18.2k at 20k VERIFIED SBOS630D p.6.
- Output is class A and swings from the 1.83 V reference (OUTN, 5/9 of 3.3 V) toward the negative rail only: 1.2 V swing, 60 uA at 20k, 240 uA at 5k VERIFIED SBOS630D p.15, 7.3.1.
- Polarity. With the cathode on positive bias and the anode on IN, photocurrent makes OUT swing down below OUTN VERIFIED SBOS630D p.19. Light on is therefore below the baseline after the non-inverting post-amp. LVDS_P is low for a logic one. See the polarity subsection of section 04 for what that means at the connector.
- 6 pF is not the datasheet's case. SBOS630D characterises 1.5 pF only. SIMULATED At 6 pF the 20k mode shows 0.97 dB peaking at 54 MHz, 13.8 % overshoot on a 5-UI run and 12.6 ns to settle to 2 % of a 20 ns UI. The 5k mode is clean (1.7 %, 4.7 ns). So 5k is preferred whenever the signal allows. The 20k eye at 6 pF is the key G1 measurement. UNRESOLVED

### 2.3 First AC coupling

OUTN sits at 1.83 V. A DC-coupled gain stage would multiply ambient photocurrent and offset. C51 100 nF into R51 1k to VCM_REF (corner about 1.6 kHz) removes the DC and ambient part at the price of baseline wander on long runs. 8b/10b bounds run length and DC balance, which is why this is acceptable. 6.63 MHz field pickup is handled by shielding, not filtering. PROPOSED

### 2.4 OPA855 fixed-gain post-amp

Why it exists. At the operating point the TIA delivers 15-25 mVpp. The TLV3605 has up to +/-5 mV offset and its datasheet gives no input noise or small-overdrive behaviour, so a direct connection cannot be proven from the datasheet VERIFIED SNOSDA2F p.7 (absence of noise data). Gain x7 lifts 15-25 mVpp to 105-175 mVpp, which makes offset and unspecified noise stop mattering. PROPOSED

- Non-inverting, gain 1 + 301/49.9 = 7.03, single 3V3 supply (3.42 V nominal, about 3.34 to 3.50 V; OPA855 minimum VS is 3.3 V). x7 is the OPA855 minimum stable gain, so R53 and R54 are 0.1 % parts (gain 7.01 to 7.05) PROPOSED. PA_REF is VCM_REF through R60 10 ohm with C53 1 uF. PD is tied to 3V3.
- FB (pin 1) is internally the output; the feedback resistor goes between FB and IN- on the same side of the package VERIFIED SBOS622D p.17, 8.3.2. Input common-mode range 1.3 V max low to 2.7 V min high at 3.3 V, so VCM_REF = 1.65 V is inside VERIFIED p.6. Overdrive recovery 3 ns VERIFIED p.6.
- The datasheet's gain-7 test values are RF 453 / RG about 75 (Fig. 7-3, p.15); the sheet uses 301 / 49.9. SIMULATED The two behave the same at gain 7 in the model: 77 degrees phase margin, 0.1 dB peaking. Stability as built is UNRESOLVED until G1.
- Idle output level: derived 1.73 V, model 1.578 V, neither verified. It matters only for headroom. UNRESOLVED

### 2.5 Low-pass and second AC coupling

R56 49.9 ohm with C54 47 pF gives about 68 MHz (research asks 60-80 MHz). The 20 ns UI needs about 35 MHz, so this trims noise without eating the eye. C55 100 nF and R59 1k to VCM_REF set the comparator input node SDET_P at the 1.65 V baseline. PROPOSED

### 2.6 VCM_REF and RSSI (Monitor sheet)

- VCM_REF. OPA2320 half U30A buffers a 10k/10k divider to 1.65 V through R102 10 ohm into C101 1 uF. It is the common baseline for every AC-coupled stage after the TIA. With DC-balanced 8b/10b, the eye centre is that baseline, so no threshold tracking is needed. PROPOSED SIMULATED The 10 ohm isolation resistor gives 87.6 degrees phase margin and 0.96 mV of VCM_REF shift for a 100 mV disturbance through 1 k; without it the model has about 1 degree of margin. The real board is UNRESOLVED until the G1 step test.
- RSSI. OPA2320 half U30B behind a BAS70 (D30, cathode on TIA_TAP) tracks the negative peaks of the TIA output; 1 nF with 1 M to 3V3 gives tau 1 ms. RSSI falls as light rises and idles near 1.9-2.0 V. It is a slow relative indicator for the ESP32, not a measurement, and it cannot separate signal from ambient. PROPOSED

### 2.7 TLV3605 comparator

- IN+ = SDET_P. IN- = SDET_N = VCM_REF through R84 1k, with DAC_TH trimmed in through R85 100k: (DAC - VCM_REF) x 1k/101k gives +/-16.3 mV, 8 uV per 12-bit LSB. R84 matches the 1k on IN+ so the bias currents cancel (IB -1 uA typ, +/-5 uA max) VERIFIED SNOSDA2F p.7; trim range calculated.
- External hysteresis: R87 5.49k in series with C87 100 pF from OUT+ to IN+ gives about 3.0 mV at the edges. The smallest characterised internal setting is about 8 mV VERIFIED SNOSDA2F p.16 Fig. 7-4, too large for a 15-25 mVpp signal without gain. LE/HYS is left open. PROPOSED Jitter and noise effect not simulated. UNRESOLVED
- SHDN is active low with a 10k pull-up (SHDN_N). Shutdown is not a guaranteed zero output (standing correction 11). Output is LVDS: VOD 350 mV typ (250-450), VOCM 1.2 V VERIFIED SNOSDA2F p.7.
- Comparator noise and delay below 10 mV overdrive: the datasheet has none. UNRESOLVED The G1 small-signal test measures it.

### 2.8 LVDS fan-out

The TLV3605 drives an SN65LVDS104 (U50) with a 100 ohm termination R180 across its input (no on-chip termination, VERIFIED SLLS396G p.16 Fig. 25). Margin: VOD 250 mV minimum against the buffer's +/-100 mV threshold leaves 150 mV VERIFIED arithmetic from SNOSDA2F p.7 and SLLS396G p.4-5. Outputs 1 and 2 feed the two SuperSpeed TX pairs of J50, output 3 goes to the J51 scope header, output 4 is disabled. Driving both pairs straight from the comparator was rejected: a 50 ohm load, about 125 mV VOD at minimum, and a hysteresis window that depends on whether a cable is plugged in. PROPOSED Details in section 04.

### 2.9 The overload story

There is no AGC, so the chain has to survive strong light without losing the eye. PROPOSED

Stage | Limit | How it follows
OPA855 clip | about 9 uA pp at 20k, about 36 uA pp at 5k | Derived: 1.15 V swing / (7 x 18.2k) = 9 uA; 36.5 uA at 5k. The 1.15 V swing is the OPA855 output range on 3.3 V (VOL 1.15 V max, VOH 2.35 V min, VERIFIED SBOS622D p.7).
OPA857 saturation | 60 uA at 20k, 240 uA at 5k | VERIFIED SBOS630D p.15, 7.3.1.
OPA855 recovery | 3 ns for 2x overdrive | VERIFIED SBOS622D p.6. Against a 20 ns UI.

The clip is symmetric about the AC baseline, so the comparator keeps slicing correctly while the post-amp clips, right up to the TIA's own 60 uA saturation. The post-amp clipping is therefore not a failure; the TIA saturating is. The operating point (0.8-1.4 uA) sits 16-21 dB below the 20k clip. PROPOSED

Not shown yet. SIMULATED The OPA855 model clips 0.25-0.35 V below the datasheet output limit and then limit-cycles at 1-2 GHz, so the simulation says nothing about how the real part clips or recovers. The 2x and 10x over-clip test with a 5-UI pattern (clip timing shift against the 3 ns figure) is a G1 measurement. UNRESOLVED

### 2.10 One setting, plus firmware, covers the range

Decision 12's "39 dB single-setting plus 32 dB firmware" are electrical (20 log current) dB; optical power dB are half (decision 31). In optical terms one fixed setting covers 10 to 12 dB unclipped from the Q = 6 floor to the post-amp clip, about 19 dB to OPA857 saturation; firmware adds 18 to 19 dB, all at the strong end: lowering APD gain from M 100 to M 5 and switching 20k to 5k (18.2k / 4.5k = 4x) both lower gain, so the weak end is fixed by M <= 100 at 20k and fade margin equals emitter margin. The direct-path photocurrent spread across the arena (about 3 dB optical between on-axis and 35 cm lateral at 50 cm height, estimated) fits inside the window, so one setting per session plus slow M tracking could work. Daniel's argument against an analog AGC: received intensity changes only as fast as the animal moves, which is slow compared with a firmware loop of tens of ms. PROPOSED The window and the clip behaviour are tested at G2 (BER against photocurrent at fixed settings). UNRESOLVED

What the headstage must do. The transmitter obligations are collected in docs/optical-link-interface.md (2026-10-23, review A3): continuous K28.5 D16.2 idle with no dark gaps, because the two 100 us AC couplings relax within tens of microseconds of silence and the lanes then need 0.3 to 0.6 ms plus 128 symbols to recover; at least 1 ms of idle after any LED stop; extinction ratio at least 10 dB; clock within +/-100 ppm; and an optical 10-90 edge at the APD of 8 ns or faster, preferably 5 ns. The edge requirement comes from the eye budget (tools/eye_budget.py): the 4x oversampling CDR fixes the sample within +/-2.5 ns of the eye centre, and with the 11 to 14 ns edges of 1 W class LEDs the crossing jitter at the Q = 6 floor alone gives a BER of 1e-7 to 6e-5, needing 1.2 to 3.4 dB more light to recover. PROPOSED

03 · Power and APD bias

## 5 V in, 3.3 V rails, and a 100-220 V bias made on the board

The module takes 5 V from VBUS of its single USB-C receptacle. Everything else is made on the board: two 3.3 V rails and the APD bias. Daniel's preference (decision 9) is to handle as much as reasonable on our own PCB rather than buy an HV module. All values below are PROPOSED unless labelled; nothing is simulated or measured. Full parts tables are in schematic/overview.html and schematic/power.md.

### 3.1 Rails

Rail | Source | Feeds | Note
VBUS to +5V | TPS259631DDAR eFuse U5 | all rails | The only 5 V input stage (decision 14). Up to 5.25 V.
3V3 (analog) | TPS79901 LDO U1 | OPA857, OPA855, TLV3605, OPA2320, SN65LVDS104 | Divider 18.7k / 10.0k on VFB 1.193 V gives 3.42 V nominal, about 3.34 to 3.50 V with the 2 % reference accuracy and 1 % divider parts (was 17.8k, 3.32 V, which dipped below the OPA855 3.3 V minimum; decision 32; OPA857 3.6 V and LVDS104 3.6 V maxima clear). PROPOSED Load about 66 mA estimate plus up to 35 mA for U50, about 101 mA against the 200 mA rating (rating not rechecked). UNRESOLVED
3V3_D | TPS7A2033 LDO U4 | ESP32-C6, CAN transceiver, I2C DAC and ADC | 300 mA rating, load about 60 mA estimate. A separate rail so ESP32 current steps stay off the analog 3V3. The radio must stay off (Wi-Fi TX 251-382 mA exceeds 300 mA). A buck is the Rev B option.
APD_BIAS (HV) | LT8365 boost plus doubler, RC filtered | APD cathode | 100-220 V, section 3.3.

The +/-3.7 V rails and 5V_A of the old design are gone (decision 12). VERIFIED TPS79901 feedback reference 1.193 V (SBVS056L p.5); CFB 1 nF is within the 3 pF to 1 nF rule (p.14) but R1 parallel R2 is 6.4k, outside the stated 250k condition, so the value is UNRESOLVED. TPS7A2033 output capacitor window 1 uF min / 200 uF max and CIN 1 uF VERIFIED SBVS338H p.5, p.23.

### 3.2 eFuse U5 (TPS259631DDAR)

Why an eFuse. With one source there is no mux to build. What the module still needs is overvoltage cut-off below the 7 V abs max of the TPS79901 (SBVS056L p.4), soft start, a real current limit and an input UVLO. The TPS2121 of decision 13 could not set a limit below about 1.24 A. A TVS plus polyfuse alone was rejected. The x1 auto-retry variant was chosen; fixed-clamp variants were rejected because a sustained 12 V input would dissipate about 1.6 W in the FET (arithmetic).

Item | Value | Status
Overvoltage cut-off | 5.76-6.20 V rising (R35 357k, R36 43.2k, R37 100k) | calculated PROPOSED
UVLO | 4.06-4.32 V rising, 3.72-4.00 V falling | calculated PROPOSED
Current limit | ILIM 0.68 / 0.76 / 0.84 A min / typ / max (R38 1.21k; about 0.79 V/A on ILM, test point TP3 IMON). A real limit, not the 0.5 A USB budget. | VERIFIED formula TPS2596 Eq. 5 p.22; resistor result calculated
Soft start | C32 47 nF: ramp about 5.3 ms, about 23 mA into an assumed 25 uF on +5V | calculated estimate; measure in G1
Pin map and ratings | IN pin 4 = VBUS, OUT pin 5 = +5V; 21 V abs max on IN | VERIFIED TPS2596 p.4, p.1, p.5
FLT | open-drain to TP4; pull-up R39 is DNP; not routed to the ESP32 | UNRESOLVED both rails are off in cut-off, so a pull-up cannot separate fault from no power
Cable margin | A compliant 3 A cable drops at most 75 mV at 0.3 A, so the module sees at least about 4.66 V against UV rising 4.06-4.32 V. A non-compliant 28 AWG 3 m cable would leave about 4.37 V. | calculated TC R2.5 4.4.1 p.151; the 3 m case is UNRESOLVED

### 3.3 APD bias: LT8365 boost plus charge-pump doubler

Why this topology. A boost at 5 V cannot do 220 V alone (150 V switch maximum, LT8365 Rev. A p.2). Boosting to V1 of about (Vout + diode drop)/2, 70 V at 140 V out and 110 V at 220 V out, and doubling once keeps the switch node well under 150 V (17 V margin at 220 V after a 20 % ring allowance, an assumption), and means a short on the output never creates a DC path through the inductor and diode. The datasheet frequency limit is 500 kHz (RT 84.5k), so the 1 MHz first asked for is not available; attenuation goes into the filter instead. At 1 mA or less the part runs in deep discontinuous mode and pulse-skips. This follows the Analog Devices DC2838A demo circuit (manual Rev. 0) and the 5 V-in precedent on LT8365 datasheet p.30, with the topology traced by eye from images. PROPOSED

- L1 10 uH (Wurth 74437324100), D1, D3, D4 150 V Schottky (D2 DFLS1150-7 is fitted since 2026-10-23 as the LT8365 reference-circuit SW-to-GND clamp for the first bench build; purpose not stated in LT8365 p.30), 0.1 uF 200 V pump capacitors, SYNC floating (pulse-skip; footprints for Burst options), BIAS tied to GND, SS 0.22 uF, INTVCC 1 uF. VERIFIED SYNC/MODE table and BIAS rule, LT8365 Rev. A p.7; the choices are PROPOSED.
- R7 20 ohm sits between HV_V1 and the D3 anode, in the pump-charge path, as R8 on LT8365 p.30 and R10 on the DC2838A; D1 goes straight from SW to C5. VERIFIED against both drawings 2026-10-22 (design review S1): until then R7 was in series with D1, where it carried the full inductor peak current (about 0.3 A in DCM, an estimate) and cost about 6-7 V of margin on the 150 V SW pin while leaving the flying-capacitor recharge undamped. The board followed the same day (R7 vertical between the HV_V1 row and D3, C5 and C7 moved); four HV pad clearance items around them remain to be cleared.
- Output set by the FBX divider: four 2.05 M resistors, R12 86.6k with a 10k NTC (TH1) for temperature tracking, a DAC leg (DAC_HV through R13 10k, R14 150k) for firmware trim, and a DNP pot leg (R15 1M). The NTC tracks about 0.64 V/C against the APD's 0.65 V/C with +/-0.7 V residual over 15-35 C. calculated PROPOSED R14 was 442k until 2026-10-22 (review S2, decision 19): with the pot leg not fitted the DAC alone then spanned only 106 to 167 V, so a 200 V VBR unit could not be biased. 150k gives 50 to 219 V from the DAC alone (LSB 41 mV); the tempco depends only on the bottom leg, so R12 and TH1 are unchanged.
- DAC_HV polarity: 0 V gives the maximum bias (about 219 V at 25 C, 225 V at 35 C) and full scale gives the minimum (about 50 V, below the 100 V firmware floor). The MCP4728 factory EEPROM is code 0, so an unprogrammed DAC means maximum bias. Hence HV stays disabled until the ESP32 verifies the DAC. calculated
- Open risk: the C50 capacitor dump into a sacrificial TIA at an HV fault (C50 10 nF versus 4.7 nF). Steady hard-short current into the TIA is 5.95 mA at 220 V through R50 plus the upstream resistor against the OPA857 abs max of 10 mA (VERIFIED SBOS630D p.5); with the clamp upstream it is about 0.17 mA. Stored energy at 220 V is about 2.3 mJ. All calculated; the G1 discharge test decides.

### 3.4 Filter, clamp and monitor

- Two-stage RC filter. Stage 1 on the Power sheet is R19 27k with C8 10 nF (500 V C0G); stage 2 at the cathode is R50 10k with C50 10 nF. Calculated attenuation about 108 dB at 500 kHz and 142 dB at 6.63 MHz with parasitics, cathode noise about 1.4 uV rms against a 10 uV target (assumes a 1 Vpp source). calculated PROPOSED
- Clamp. Q1 MMBTA42 pass transistor driven by Q4 MMBTA42 as a Darlington (decision 24), Q2 MMBT3904 sensing across R16 4.02k, base feed 2 x 4.99 M (0805, 150 V working, Yageo RC0805 spec V0 p.3 VERIFIED; 0603 until decision 22): limits the current an HV fault can push toward the TIA to about 150 uA. Topology checked in the netlist. PROPOSED Why the Darlington: a single pass transistor drops Ic x 10 M / hFE at the APD side, about 3 V per 10 uA at hFE 30, which HV_MON upstream cannot see; the second stage divides that by its own gain, leaving about 0.7 V at 60 uA plus a fixed 1.2 V. MMBTA42 gain at microamp currents is UNRESOLVED; G1 measures the residual, and a MOSFET follower is the Rev B option if it matters.
- HV_MON. 2 x 4.99 M (0805, 150 V, decision 22) over R21 45.3k + R45 54.9k, C28 10 nF: HV_MON = HV_OUT/101.2. It is the only HV observation point. There is no bare APD_BIAS pad.

### 3.5 HV_DIS: HV is off unless the ESP32 allows it

Q3 (DMN2056U-7) pulls the LT8365 EN/UVLO node to ground. R33 100k pulls the gate to 3V3_D, so a high, floating or unprogrammed HV_DIS means HV off. PROPOSED Not simulated or measured.

HV_DIS | Q3 | EN/UVLO | HV
high, or ESP32 unprogrammed or Hi-Z (R33 pulls the gate to 3V3_D) | on | pulled to GND through Q3 | OFF
low (ESP32 drives it after verifying the DAC) | off | 200k/200k divider gives 2.5 V at 5 V | ON

- Bench jumper J1 "HV FORCE ON" (DNP) ties the gate to GND, so HV is on regardless of firmware. Set the DAC first: with an unprogrammed DAC the bias goes to about 220 V. Fit J1 only on a board whose firmware has already run once and provisioned the DAC EEPROM (decision 20).
- If 3V3_D is absent the gate floats and the HV state is UNRESOLVED. In practice 3V3_D comes up with the same 5 V rail that feeds the LT8365.
- The Q3 gate threshold and the EN/UVLO threshold were not rechecked against datasheets. UNRESOLVED

### 3.6 HV safety rules

- Over-voltage limiter (decision 23). U6 TLV431A watches the tap between R21 and R45 (0.548 x HV_MON) and pulls the LT8365 EN/UVLO pin to 1.24 V, below its 1.545 V minimum falling threshold, when HV_OUT reaches about 228 V (+/-3 V budget). An open resistor in the 8.2 M FBX chain or an FBX short would otherwise run the converter to the 150 V diode ratings in about 3 ms, faster than any firmware loop, and with J1 fitted nothing else would stop it. R22/R23 are 20k so the EN node can source the TLV431 minimum cathode current. PROPOSED calculated from TLV431 SLVS139Z p.5-7 and LT8365 Rev. A p.4, nothing measured.
- APD bias is 100-220 V. Layout uses 200 V creepage and clearance; net class HV is 1.0 mm clearance (HV_LADDER 0.6 mm for the 4.99 M and 2.05 M resistor ladders, steps of about 55 V).
- Every net at or above 50 V is prefixed HV_. HV_MON is the only observation point; no bare APD_BIAS test pad.
- Series current limit (R50, plus the clamp) and a keep-out from the TIA input, including inner layers.
- HV is off until the ESP32 drives HV_DIS low. In USB-alone mode the firmware starts HV from the low-bias end of the DAC in steps, because a faulted HV start can trip a USB port.
- HV outer layers only; GND1 and GND2 stay solid under HV traces (no plane cuts).

### 3.7 Current budget

About 0.19 A worst case from +5V (0.24 A with margin) against the 0.5 A USB default, estimated with 0.5-1 mA of HV load and an assumed 70 % LT8365 efficiency, plus up to 35 mA on 3V3 for U50. The ESP32 self-test at 100 V bias is estimated at about 130 mA. Nothing measured; G1 measures the real draw, including ESP32 boot and flash-write peaks and the 100 mA pre-enumeration case. calculated UNRESOLVED Whether a bus-powered hub holds a module to 100 mA is UNRESOLVED: use a laptop root port or a powered hub.

04 · Connector, cable and LVDS fan-out

## One 24-pin USB-C, with the LVDS on both SuperSpeed TX pairs

Decision 14 (2026-10-09, approved by Daniel, PROPOSED until G1 and G4) replaced the 12-pin system header and the 16-pin USB-C with one 24-pin full-featured USB-C receptacle, Wuerth 632723300011, horizontal. One connector and one standard cable per module. Plug orientation must not cost ECP5 LVDS pairs. USB stays a line to a computer; between the FPGA and the modules the system picture is CAN plus LVDS.

History. Decision 14 removed the 12-pin J50 header, the 16-pin USB-C J60, the TPS2121 two-source mux, +5V_CABLE, PWR_SRC, the VBUS_SENSE divider and AUX2. Decision 13's requirement (a laptop can program and verify a module over USB alone) is kept.

### 4.1 J50 pin map (as built)

From schematic/connector.md. The adopted decision-14 draft shows an earlier output order; the as-built table wins. PROPOSED Wuerth footprint facts VERIFIED WE rev 003.000 p.1, p.3.

J50 pin | Function | Module net | Behind it
A4, A9, B4, B9 | VBUS | VBUS | eFuse U5 IN, C33
A1, A12, B1, B12 | GND | GND
A2 | SSTXp1 | LVDS_OUT2_N | U50 output 2Z, via U51
A3 | SSTXn1 | LVDS_OUT2_P | U50 output 2Y, via U51
B2 | SSTXp2 | LVDS_OUT1_N | U50 output 1Z, via U52
B3 | SSTXn2 | LVDS_OUT1_P | U50 output 1Y, via U52
B11 / A11 | SSRXp1 / SSRXp2 | CAN_P (bused; CANH, renamed from CAN_H 2026-10-16 so the KiCad diff-pair router pairs CAN_P/CAN_N) | SN65HVD230 U64
B10 / A10 | SSRXn1 / SSRXn2 | CAN_N (bused) | SN65HVD230 U64
A6 / B6 | D+ (Dp1, Dp2 tied) | USB_DP | USBLC6 U61, 22 ohm R193, ESP32 IO13
A7 / B7 | D- (Dn1, Dn2 tied) | USB_DN | USBLC6 U61, 22 ohm R194, ESP32 IO12
A8 / B8 | SBU1 / SBU2 (tied) | AUX_CAB, then R186 1k to AUX | ESP32 IO7 via R204 1k; J51 pin 6
A5 | CC1 | CC1 | Rd R181 5.1k 1 %, 100k/100k/100 nF tap to IO4 (CC1_SENSE)
B5 | CC2 | CC2 | Rd R184 5.1k 1 %, 100k/100k/100 nF tap to IO5 (CC2_SENSE)

Wuerth labels A5/B5 "CC"/"VCONN"; wiring them as CC1/CC2 is a PROPOSED reading. Whether J50 is top- or mid-mount is UNRESOLVED. The shield (S1 shell posts) is tied directly to GND since 2026-10-22 (Daniel; C181 and R170 removed): a compliant cable already ties shield to GND inside each plug (USB Type-C Table 3-10 note 6), so the RC never isolated anything, and 1 nF is about 24 ohm at 6.63 MHz, a poor bond for the cable braid. PROPOSED Layout rule: every shell post to the GND planes with several vias each. Layout rules: the Dp/Dn ties within 3.5 mm of J50 (VERIFIED USB Type-C R2.5 Table 3-4 note 1 p.77).

### 4.2 Why a fan-out buffer

Both TX pairs carry the same signal so the module works in either plug orientation. U50 (SN65LVDS104PW) repeats the single TLV3605 output onto both pairs and J51. It is powered from 3V3 (23 mA typ, 35 mA max, VERIFIED SLLS396G p.5), enables active high (EN1-EN3 to 3V3, EN4 to GND, VERIFIED section 9.4 Table 2), and drives a static high if the TLV3605 is unpowered (VERIFIED p.15-16). R180 100 ohm 0.1 % at its input is the module's termination; the ECP5 end keeps its on-die DIFFRESISTOR. The 90 ohm pairs run on the top layer over GND1 with intra-pair match within 2.5 mm on the LVDS/SuperSpeed pairs (1 mm until 2026-10-22; CAN, USB and LVDS_P/N not skew-checked; routing target, PROPOSED).

### 4.3 Polarity, end to end

1. Light on makes the OPA857 output swing down, so SDET_P falls below the VCM_REF baseline and LVDS_P is low for a logic one (VERIFIED SBOS630D p.19 for the swing direction).
2. On 2026-10-09 Daniel flipped the polarity at J50 on both pairs: N goes to SSTXp and P to SSTXn. The same day U50 output 1 was assigned to the upper end of J50 (B2/B3) and output 2 to the lower end (A2/A3) so the two pairs reach their ESD clamps without crossing.
3. The consequence: the cable carries the fan-out output inverted, and SSTXp is HIGH for a logic one at the module's J50.
4. The FPGA-end inversion is a gateware constant. It belongs in the breakout and gateware docs, which do not exist yet. PROPOSED

### 4.4 Orientation does not matter

A standard full-featured C-to-C cable maps TX1 to RX1 and TX2 to RX2, p to p and n to n, so a flip at either end swaps TX1/TX2 and RX1/RX2 with polarity preserved (VERIFIED cable wiring, TC R2.5 Table 3-10 p.83; the analysis is PROPOSED). Because the module drives both TX pairs identically and receives CAN on both RX pairs, in all four flip combinations the module LVDS lands on the breakout's RX1 and RX2 and the breakout CAN lands on both module RX pairs. The breakout takes LVDS from RX1 alone and terminates RX2 with 100 ohm. SBU1 tied to SBU2 at both ends makes the SBU swap irrelevant.

### 4.5 CC sense, SBU and the foreign-host problem

- CC. Rd 5.1k on each CC pin detects the source's advertisement (VERIFIED USB Type-C R2.0 Table 4-25 p.236). The 100k/100k taps keep the ESP32 pin under 3.3 V even if an e-marked cable puts 5.5 V VCONN on the unused CC pin (2.75 V at the pin). The firmware logs class and orientation as hints only and never clears HV_DIS on CC alone. ADC classification margin is thin: about +/-46 mV at the CC pin against class-edge margins of about 20-25 mV. UNRESOLVED
- SBU / AUX. One slow single-ended line (about 1 MHz or less) between the module and the FPGA master, used to map CAN nodes to LVDS lanes. A driven AUX line departs from the Type-C rule that SBU stays open or weakly pulled down; this is accepted and UNRESOLVED. The firmware keeps AUX high-Z until LINK_ALL or the host class is known. A laptop in DisplayPort alternate mode might drive SBU. UNRESOLVED
- Laptop plugged in directly. A laptop host may see the CAN transceiver load (10-25 kohm per pin) and the LVDS on its SuperSpeed pins. Expected harmless, never tested. Mitigations are held in reserve: AC-couple the LVDS TX pins with 100 nF, or hold U50 disabled until VBUS and CC identify a known partner. The CAN TX stays silent until bus traffic or the FPGA master is seen. UNRESOLVED G4.

### 4.6 ESD arrays split by position

VBUS transient suppressor D50 (decision 34, 2026-10-25). The TPD6E05U06 arrays cover the data, CC, SBU, LVDS and CAN pins but VBUS had nothing, and the eFuse's overvoltage lockout reacts in microseconds, too slow for hot-plug ringing into C33, cable discharge or ESD on the VBUS pin. D50 is an SMF5.0A unidirectional TVS (200 W, 5 V standoff, breakdown 6.4 to 7.0 V, clamp 9.2 V at 21.7 A, SOD-123FL) from the J50 VBUS pins to GND. Standoff sits above the 5.25 V USB maximum, breakdown above the eFuse OVLO trip at 5.76 to 6.20 V so it never conducts in normal use, and the clamp is far under the TPS2596 21 V absolute maximum. VERIFIED against the Panjit SMF5.0A series datasheet REV.13 (the Littelfuse part is the intended vendor; lab library PR #66). Footprint parked next to the VBUS entry for Daniel to place and route. PROPOSED

U51 and U52 are TPD6E05U06 (0.47 pF typ, VRWM 5.5 V, VERIFIED TPD Table 5.4 p.7; place within a few mm of J50). A 2026-10-09 hand edit changed the split from by-function to by-position along the J50 pad rows. U51 clamps the lower-end pins (A5 CC1, A3/A2 LVDS pair 2, B10/B11 CAN) and U52 the upper-end pins (B2/B3 LVDS pair 1, A11/A10 CAN, B5 CC2, A8/B8 SBU). Reason: the two plug orientations put the same function at opposite ends of the receptacle, and the old split made half the protected lines run the length of the pad rows. A-row SMD pads get straight top-layer traces; B-row through-hole pins arrive on an inner layer with a via. Nets are unchanged; the ERC stays 0/0. On 2026-10-22 the U51 CAN clamp channels were swapped in the GUI for routing (pin 9 = CAN_P to B11, pin 8 = CAN_N to B10); the channels are identical, so this is electrically neutral. PROPOSED Open: the unidirectional clamps conduct near -0.7 V, so CAN common-mode excursion with up to 0.4 V of cable ground drop needs a check. UNRESOLVED

### 4.7 Cable rule and labelling

- Cable rule (decision 14, PROPOSED). Passive full-featured USB-C cable, USB 3.2 Gen 1, 3 A, e-marked. Up to 2 m certified. 3 m only after a bench check of the specific cable: DC continuity of the SuperSpeed wires (a few ohms for passive full-featured), then a scope of LVDS and CAN through it. Whether any 3 m passive full-featured cable exists is UNRESOLVED.
- Label on the board and in docs. "USB-C: USB 2.0 and 5 V only on a host; SuperSpeed pairs carry proprietary LVDS/CAN, not USB 3." The module is not USB 3 compliant and must not be advertised as such.

### 4.8 CAN bus rules

- SN65HVD230 (U64) with RS = R199 100k for slow edges: rise time 600 / 800 / 1200 ns, so the SLLA270 stub rule allows at least 20 m of stub at the minimum edge instead of about 2.7 m at 10k; loop delay 535-990 ns is about 12 % of the 8 us bit at 125 kbit/s. Datasheet numbers VERIFIED SLOS346O p.8, SLLA270 p.9; arithmetic PROPOSED. The CANH/CANL pins tolerate -4 to 16 V (VERIFIED p.5).
- No termination on the module. One split termination (2 x 60.4 ohm + 4.7 nF) lives at the FPGA-end breakout (VERIFIED SLLA270 p.4, p.8 Fig. 10). R182, R183, C180 on the module are DNP, for single-module bench use. Two bused cable pairs give about 45 ohm in parallel, acceptable at these edge rates (PROPOSED).
- 14 modules (node IDs 1..14) on one bus with stubs up to 3 m is the design target; it is untested. CAN edges (about 2 V) next to the LVDS pair (about 350 mV) inside the cable is an unestimated crosstalk case. UNRESOLVED G4.

### 4.9 J51 scope header

Six pins, a bench aid (connector.md): 1 GND, 2 LVDS_DBG_N (U50 3Z) and 3 LVDS_DBG_P (U50 3Y), pair flipped 2026-10-16 for layout (U50 output 3), 4 CAN_P, 5 CAN_N, 6 AUX. R177 100 ohm across the debug pair is DNP; whether an unloaded output 3 is acceptable is UNRESOLVED. RSSI, HV_MON, 3V3, 3V3_D and GND go to test points TP50-TP55. PROPOSED

05 · Module controller and firmware

## An ESP32-C6 that trims slowly and never touches the data

Decision 11: Daniel moved away from the SAMD51 and wants every module to carry an ESP32 as its single point of contact with the FPGA side (identification, future-proofing) and as the owner of everything slow on the module. Analog-first is unchanged: the module decodes with the ESP32 unprogrammed. All of this is PROPOSED; an ESP-IDF 5.5 firmware skeleton exists since 2026-10-12 (builds for esp32c6, host-tested HV gate, range state machine and CAN codec; nothing flashed or measured on hardware). Plan: firmware/esp32/README.md. Protocol: firmware/can-and-console-protocol.md.

### 5.1 Role and parts

- Does: range trim (DAC_HV toward the Q(M) optimum, TIA_CTRL 20k/5k scheduling), threshold trim (DAC_TH, read back on VTH_MON), HV gating (HV_DIS, HV_MON readback), module identity, telemetry and commands over CAN, USB console and self-test, status LED.
- Does not: sit in the signal path, run a radio (never initialised; no RF window in the housing), or decide that the link is up (the FPGA decoder does).
- U60 ESP32-C6-MINI-1 (native USB Serial/JTAG, no USB-UART chip); U62 MCP4728 12-bit DAC at I2C 0x60 (OUTB = DAC_TH, OUTC = DAC_HV, OUTA and OUTD to spare test pads); U63 ADS1115 16-bit ADC at 0x48 (AIN0 HV_MON, AIN1 RSSI, AIN2 VTH_MON, AIN3 GND); U64 SN65HVD230 CAN transceiver with R199 91k on RS; U61 USBLC6-2SC6 plus 22 ohm R193/R194 on D+/D-; RESET and BOOT tactile switches; status LED D60. Datasheet detail: MCP4728 DS22187E, ADS1115 SBAS444E, ESP32-C6 datasheet v1.5 and MINI-1 datasheet v1.5.

### 5.2 GPIO map

GPIO | Net | Direction and note
IO0 | HV_DIS | Out. 100k pull-up R33 to 3V3_D; high or Hi-Z = APD supply off. The only HV enable.
IO1 | SHDN_N | Out. TLV3605 shutdown, active low. Pull-up keeps the comparator on.
IO2 / IO3 | SDA / SCL | Local I2C, 4.7k pull-ups: MCP4728 0x60, ADS1115 0x48.
IO4 / IO5 | CC1_SENSE / CC2_SENSE | In (ADC1_CH4 / CH5), through the 100k/100k/100 nF taps. Strapping pins that only select SDIO sampling edges; SDIO unused.
IO6 | LDAC | MCP4728 update. (IO10 and IO11 do not exist on the MINI-1, so LDAC and AUX moved here.)
IO7 | AUX | Through R204 1k to the tied SBU line. High-Z until LINK_ALL or the host class is known.
IO8 / IO9 | strap / BOOT | IO8 10k pull-up; IO9 BOOT switch. Download boot needs IO9 = 0 with IO8 = 1 at EN rising (VERIFIED MINI-1 datasheet Table 4-3 p.13).
IO12 / IO13 | USB D- / D+ | Native USB Serial/JTAG. UART0 pads IO16/IO17 are a fallback (TP62/TP63).
IO14 | LE_HYS | Through R205 0R, DNP. LE/HYS is left open on the comparator.
IO18 / IO19 | CAN_RX / CAN_TX | Swapped on 2026-10-10 (TX is now IO19 pin 25, RX IO18 pin 24) for layout. TWAI signals go through the GPIO matrix, so either pin works. Hand edit, ERC 0/0.
IO20 | TIA_CTRL | Out, through R214 2.2k (limits a bridged JP10 jumper fight to about 1.5 mA). 1 = 20k, 0 = 5k; the pull-up is on the Front End, so unprogrammed means 20k.
IO22 | DAC_RDY | In. MCP4728 RDY/BSY open drain (EEPROM write busy).
IO23 | STATUS | LED through R203 1k.
EN | RESET | R190 10k + C190 1 uF + RESET switch. IO15 and IO21 unconnected.

### 5.3 When the ESP32 is not programmed

- TIA_CTRL floats and the pull-up gives 20k. SHDN_N is pulled up so the comparator is on. The signal path is live, but without bias the APD produces nothing, so the module is dark (decision 21).
- No APD bias unless bench jumper J1 is fitted, because HV_DIS floats high through R33. With J1 fitted and an unprogrammed DAC the bias goes to about 220 V; firmware cannot prevent that, hence the rule that J1 goes on only after the first firmware boot (decision 20).
- DAC_TH comes up at the MCP4728 EEPROM value: 0 V from the factory (threshold 16 mV below the baseline), 0x800 (centred) once the first firmware boot has provisioned it (decision 20).

### 5.4 Boot, in order

1. First instruction: write HV_DIS = 1, then enable the pin as an output. Read the reset reason; after a brown-out or watchdog reset HV stays off until a deliberate command.
2. Load and clamp the stored parameters (hv_min at least 100 V, default hv_max 200 V, absolute 220 V).
3. Recover and probe I2C. If the DAC or ADC is missing, HV stays off but console and CAN still start.
4. Verify the MCP4728 EEPROM with the Read command (channel C must read VREF = VDD, code 0xFFF, minimum bias; channel B 0x800). The General Call Read named in older notes only returns address bits (DS22187E 5.4.4 p.32-33, VERIFIED). If the EEPROM is blank (factory: code 0 on every channel) or wrong, the firmware provisions it at this step itself; there is no external I2C programming step (decision 20). A mismatch that survives the write is a DAC_EEPROM fault.
5. Force live outputs to safe values, check the ADC with HV off (HV_MON should read about 0.05 V; more than 30 V of bias while disabled sets HV_STUCK).
6. Read CC1/CC2 and watch for USB SOF, then start CAN in listen-only for 1.5 s or more to find the mode.
7. HV stays off until commanded: console hv on (standalone), master hv_cmd over CAN, or a stored hv_auto flag with a heard master and no faults (default 0).
8. Soft start: first write DAC_HV = 0xFFF and read it back (the only path that lowers HV_DIS), then drive HV_DIS low, let the LT8365 soft-start (SS 0.22 uF) reach the full-scale DAC value of about 50 V, then walk DAC_HV down closed-loop on HV_MON at no more than 20 V/s with a code bound derived from hv_max and a trip if the bias does not follow the code. Timeout 10 s gives HV_UNDER and HV off.

Any ESP32 reset, crash or loss of 3V3_D releases IO0, so HV turns off with no firmware action. HV also goes off within 10 ms of: I2C or ADC failure, HV out of range, CAN bus-off or no LINK_ALL for the 2 s default in bus mode. PROPOSED

### 5.5 Mode table

LINK_ALL heard | USB SOF | CC class | Mode
yes | any | any | bus; host console allowed if SOF seen; CAN TX enabled
no | yes | any | usb standalone; stepped HV start; CAN TX silent
no | no | 1.5 A | usb until LINK_ALL arrives, then bus
no | no | no Rp | usb with a warning

The CAN TX stays silent until bus traffic or the FPGA master is seen, so a lone module on a laptop never transmits into the host's SuperSpeed receive pair. Hearing LINK_ALL later switches standalone to bus. PROPOSED

### 5.6 Range-trim loop (sketch)

Strategy: search in bias volts, not absolute M, so no per-unit calibration is needed. A strong signal settles at the lowest bias with the best ambient and saturation margin; a weak one walks up until the FPGA reports valid frames, then adds margin. Q(M) is broad (for the S12023-10 in the link-budget model it is about 16 at M = 30, 15.8 at M = 50, 15.2 at M = 75, calculated), so coarse tracking is enough. All thresholds are first guesses to be tuned at G1-G3. PROPOSED

State | Action | Exit
OFF | HV off (boot, hv off, fault) | ramp done: SEARCH in bus mode, MANUAL standalone
RAMP | soft start to the starting bias | arrival: SEARCH
SEARCH | raise bias 2 V per 400 ms until valid for 1 s, then add +8 V margin; at hv_max with no valid frames, report LOS and retry from hv_min every 30 s | clean 1 s: TRACK
TRACK | hold; error class 2 or more averaged over 2 s gives +2 V (at most +6 V per 5 s); class 0 for 60 s gives a down-trial of -4 V, with the trial interval doubling up to 10 min | invalid for 1 s: LOS
LOS | hold bias and TIA for 5 s (animal turned away), then SEARCH from the last lock minus 8 V | valid: TRACK
MANUAL | standalone or loop manual: hold the set bias code; only report | hv off, fault, loop auto

TIA overload guard (runs in every auto state): RSSI drop above 0.80 V for 100 ms lowers the bias 2 V per 200 ms, then switches to 5k if still above at hv_min; at 5k a drop under 0.10 V for 10 s switches back to 20k; at least 10 s between switches; link metrics ignored for 300 ms after a switch. The guard protects the TIA, not the post-amp, which clips by design. Because SIMULATED the 20k mode at 6 pF shows 13.8 % overshoot while 5k is clean, 5k is the preferred mode and 20k the sensitivity fallback; the up-switch threshold will move after the G1 20k eye is measured. UNRESOLVED

The firmware sees temperature only as bias drift at a fixed DAC code (the NTC is hardware). In MANUAL the loop holds the DAC code, so after hv set 180 the reported bias drifts about 0.64 V/C. The ESP32 die temperature is telemetry, not the APD temperature. PROPOSED

### 5.7 CAN link

Item | Value
Physical | SN65HVD230 on IO19 (TX) / IO18 (RX); CAN_P/CAN_N on both SuperSpeed RX pairs; one split termination at the FPGA end; 125 kbit/s, 8 us bit. PROPOSED
Controller | ESP32-C6 TWAI, CAN 2.0, 11-bit standard IDs only. VERIFIED ESP32-C6 datasheet p.4; MINI-1 datasheet 5.2.1.7 p.21.
Nodes | Node 0 is the FPGA-side master (the ULX3S's own ESP32 is a candidate, UNRESOLVED), node IDs 1..14 for modules (14 on one bus), 15 broadcast. Identity is the factory MAC plus a write-once serial in NVS.
Master status | LINK_ALL (ID 0x1F0, broadcast, 20 Hz): one nibble per module with a valid bit and a 3-bit error class from the FPGA's invalid-code count per 100 ms, class 7 = LOS. It is also the node's bus heartbeat. Invalid-code counts are not a BER measurement (standing correction 12).
Telemetry | TLM_ANALOG at 10 Hz (HV, RSSI, VTH, estimated M), TLM_STATE at 2 Hz and on change, TLM_SLOW at 0.2 Hz (uptime, die temperature, CAN error counters), plus fault and boot frames. An intended per-module dashboard joins this with per-lane FPGA error counts.

### 5.8 USB standalone requirement

Daniel's requirement, 2026-10-09: "anyone should be able to plug a module into a random laptop over USB, program it and verify it, with no FPGA attached." Realised by decision 14: VBUS through the eFuse is the only 5 V input, D+/D- go to the ESP32-C6, RESET/BOOT switches and the 22 ohm resistors support browser or esptool flashing. Auto-reset through the 22 ohm resistors and the USBLC6 is UNRESOLVED until the first board. The built-in self-test cannot prove the comparator or LVDS output without an FPGA or an optical source. UNRESOLVED HV in this mode starts stepped from the low-bias end. PROPOSED

06 · FPGA side

## What the ECP5 end has to do

The module sends no clock. The FPGA recovers it. The gateware now exists in firmware/ecp5/ (spec and status in its README; open-source Yosys/nextpnr flow; it builds for the ULX3S and passes timing, and every block has cocotb simulation tests) but has not run on an FPGA, and the breakout board is not designed, so this section is still the contract the module assumes. Items are PROPOSED unless labelled.

### 6.1 ULX3S input pairs

- True differential inputs: gp/gn[8..13] (bank 7, VCCIO jumper-selectable 2.5 or 3.3 V) and gp/gn[14..21] (banks 2/3, 3.3 V). That is 14 pairs, one per module. Banks 0/1 (gp/gn[0..7], [22..27]) have no differential inputs. VERIFIED ULX3S v3.1.7 schematic p.2-3; Lattice FPGA-TN-02032 v1.4 p.14, p.26.
- ECP5 differential inputs are powered from VCCAUX, independent of VCCIO, and on-die DIFFRESISTOR = 100 exists on the left and right banks, so the pair goes straight into the pins with no receiver IC and no external termination. VERIFIED FPGA-TN-02032 v1.4 s.4.3, s.4.10, s.4.11.8; see research/ulx3s-lvds-input.md. This closed the earlier open item about LVDS on a 3.3 V bank.
- The ECP5 input threshold is +/-100 mV (ECP5 DS Table 3.13 p.58), against at least 250 mV VOD from the module's fan-out. VERIFIED for the datasheet figures.
- ECP5 LVDS input common-mode range 0.05 to 2.35 V (ECP5 DS FPGA-DS-02012-3.4 Table 3.13 p.58, VERIFIED) contains the TLV3605's 1.125 to 1.375 V; at the 250 mV minimum VOD the margin over the +/-100 mV threshold is about 25 mV, which only the G1 eye measurement can confirm. PROPOSED
- Still open: DIFFRESISTOR support in nextpnr; one ULX3S has only 7 header pairs free of other loads (pairs 11 to 13 share the on-board ESP32, 14 to 17 the on-board ADC), so 14 lanes on one board is open. See firmware/ecp5/README.md. UNRESOLVED

### 6.2 Gateware duties

- Clock and data recovery in the fabric. Reason: no clock is sent, and a digital CDR is flexible, lets the rate change and avoids a PLL on the module. As built: 4x blind oversampling at 200 MS/s (PLL from the 25 MHz oscillator), a second-order digital PLL on the edge-phase histogram; in simulation zero bit errors over 1e5 bits at +/-500 ppm and 0.3 UI jitter after a lock-in of about 1000 bits. PROPOSED
- 8b/10b decode and framing. The line protocol is now defined in the gateware README section 3 and the headstage must follow it: continuous 8b/10b, idle = K28.5 D16.2 pairs, frame = K27.7, seq u16, type u8, len u8, 1 to 256 payload bytes, CRC-16/CCITT-FALSE, K29.7; the Python model in firmware/ecp5/model/ is the executable definition and the test oracle for the headstage encoder. PROPOSED
- Redundant-lane merge. Several receivers see the same stream; the FPGA selects validated copies. v0 policy: the first CRC-valid copy of each sequence number wins, later copies count as duplicates, gaps count as lost; conflicting valid copies and the maximum skew are still open. UNRESOLVED
- Link validity. Decoder validity is the LOS judge for the whole system. The gateware forms the LINK_ALL nibble per lane (valid bit and error class from invalid symbols per 100 ms window, class 7 = LOS from the watchdog) and sends the 7-byte nibble block to the ULX3S's own ESP32 over a UART 20 times a second; that ESP32 is the CAN master and forwards it as LINK_ALL. A 1 Hz ASCII status report and a 3 Mbaud frame sink on the ULX3S USB serial serve bring-up until the host link exists. PROPOSED

#### Watchdog rule (standing correction 12)

The FPGA watchdog runs on an independent local clock, not on the recovered one, so it survives loss of the recovered clock. After release the CDR and framing are reacquired. Both constant LVDS states are "invalid" after a timeout (correction 11: TLV3605 shutdown is not a guaranteed zero and a latched comparator holds its last state). Invalid-code counts are not a BER measurement because they miss errors.

### 6.3 Polarity constant

At the module's J50, SSTXp is HIGH for a logic one on both pairs (section 04.3). The FPGA end applies a fixed inversion or pair swap in gateware or on the breakout. It is one constant, the same on every lane, and plug orientation never changes it. It must be recorded in the breakout and gateware docs when they exist. PROPOSED

### 6.4 Breakout board concept (not designed)

- One Type-C source port per module. 5 V per port is applied only after Rd is seen. VCONN for the e-marked cable. Advertised 1.5 A.
- RX1 wired to the ECP5 LVDS input, RX2 terminated 100 ohm. The breakout's own CAN on TX1/TX2 onto a shared bus with the split termination. D+/D- into a USB hub so one computer sees every module console.
- The ULX3S cannot be a USB host. The FPGA board connects by LVDS and CAN only. Brick part, per-port TPS25810 design, VCONN routing and the hub are undone. UNRESOLVED

### 6.5 Host link (open)

UNRESOLVED, a separate decision. How the FPGA end reaches a computer is not decided. Daniel's preference to evaluate first (2026-10-09, PROPOSED): the Cypress/Infineon FX3 (CYUSB3014 family, USB 3.0 device controller with a parallel GPIF II bus, known from the Miniscope DAQ) on the ULX3S GPIO header. No FX3 datasheet figures were read. The GPIO pins left after 14 LVDS pairs are believed to be 28, which fits a 16-bit GPIF bus but not 32-bit; check against the ULX3S schematic. Other candidates: a USB 2.0 high-speed FIFO bridge, a USB 3.0 FIFO bridge, an Ethernet PHY with a soft MAC, or a single-board computer at the rig. Rates to carry: about 40 Mb/s payload merged, or about 560 Mb/s payload for all 14 raw lanes.

07 · Layout and fabrication

## Placed and routed

Layout started on 2026-10-09. All 225 footprints (222 components plus H1-H4) are placed on a 75 x 50 mm placeholder outline (Daniel) by tools/pcb_place.py from placement/placement-spec.json, with 0 courtyard overlaps and 0 clearance violations in kicad-cli DRC at that point. Routing has since been completed by hand (0 unconnected pads, DRC 11 items, all accepted in writing in the review). Rules and fab settings are PROPOSED; nothing was measured.

### 7.1 Floor plan

Long rectangle, optical end on the left, cable end on the right. The APD sits at the housing window; the optical window is centred on the APD can, 1.27 mm to the left of the D10 footprint origin (pad 1, the anode; D10 is rotated 180 degrees since the 2026-10-22 pinout correction). The fast chain is butted together on the top-layer centre line: APD, OPA857, OPA855, filter, TLV3605, SN65LVDS104, ESD arrays, J50 at the right edge (mouth overhanging 0.95 mm). The HV island runs along the back edge on top, right side. Slow and quiet parts go underneath. The bottom view below is drawn as seen from the top (mirrored front to back through the board), so optical end stays left. Schematic only, not to scale. PROPOSED

Floor plan. Intent from docs/pcb/placement-plan.html and the first-pass placement notes in the board README; block sizes are schematic. The eFuse U5 and its C33 sit on the bottom side under the J50 VBUS end (placement-spec.json and the board file; the placement plan draws it in the top view for the VBUS run). PROPOSED.

### 7.2 Placing rules

- Fast chain butted together on the top centre line: APD, TIA, post-amp, filter and coupling, comparator, fan-out, ESD arrays, J50.
- APD anode to OPA857 input is the shortest trace on the board, with nothing else near it and no HV copper within a few mm on any layer. A plane cut-out under the TIA input follows OPA857 guidance. UNRESOLVED
- HV island is one block with a 1.0 mm clearance ring, outer layers only. Only the filtered bias (C8, R50, C50) runs down the left edge in a column at x 4.6 to the APD cathode (decision 26: C50's pad 4.43 mm from the cathode pad, HV_K leaving the pad radially). Exact island position depends on the housing. UNRESOLVED
- GND1 and GND2 stay solid under HV traces.
- Differential pairs from the fan-out to J50 stay on top over GND1 with no layer change. ESD arrays within a few mm of the J50 pins. R180 at the fan-out input, centred behind J50.
- Put the eFuse right beside the J50 VBUS pins with C33 at its input; CC network next to the CC pins.
- Bottom left half stays quiet: no switching parts under the front end.
- USBLC6 and the 22 ohm resistors directly under the D+/D- pins; CAN transceiver under J50 near the RX pins. ESP32 module with its antenna end toward a board edge. No CAN termination on the module.

### 7.3 Stackup and layers

JLCPCB JLC06161H-3313, 6 layers, 1.6 mm, ENIG (6 layers or more do not support HASL, so ENIG or OSP; ENIG also suits the 0.5 mm pitch USB-C and the module castellations). Outer copper 1 oz (0.035 mm), inner 0.5 oz (0.0152 mm), mask 0.0305 mm Er 3.8. Prepreg 3313 0.0994 mm Er 4.1 (F.Cu to In1, In4 to B.Cu), core 0.55 mm Er 4.6 (twice), prepreg 2116 0.1088 mm Er 4.16 (In2 to In3). Layer sum 1.538 mm, about 1.60 mm with mask; confirm 1.6 mm in the JLCPCB calculator. VERIFIED JLCPCB impedance page and capability page, read 2026-10-09 (see jlcpcb-fab-settings.md).

Layer | Name | Use
L1 | F.Cu | Components, fast analog path, USB-C pairs, LVDS, HV outer routing; 90/100 ohm referenced to L2
L2 | GND1 | Solid GND, no routing
L3 | SIG_IN | Slow signals and rail routing, no controlled-impedance pairs
L4 | PWR | Power pours (VBUS, 3V3, 3V3_D), rest GND, stitched; only 0.1088 mm to L3
L5 | GND2 | Solid GND
L6 | B.Cu | Bottom components, slow routing

Design rules: min clearance, track and connection 0.10 mm; annular 0.15; via 0.45 / hole 0.20; hole-to-hole 0.45; copper to hole 0.30; copper to edge 0.30; vias tented. Four M2 plated mounting holes H1-H4 tie to GND (lab-library PR #62). Remaining DRC items are silk overlaps and the LVDS diff-pair gap at R180; the 32 hole-to-hole hits from the mounting-hole via rings are gone since H1-H4 use the no-via variant (2026-10-25) (use the no-via variant or accept on the high-precision tier). PROPOSED

### 7.4 Net classes

Differential geometries were computed with a 2D field solver (tools/impedance_fd/), converge with mesh refinement and sit 3-4 % below the zero-thickness formula as expected, but are not JLCPCB calculator output and are not validated against a coupon. Treat as +/-5 % and confirm in the JLCPCB calculator at order time. PROPOSED Width tolerance of +/-20 % alone moves Zdiff by about +/-8 %.

Class | Track | Clearance | Diff width / gap | Nets
Default | 0.15 | 0.15 | - | everything else, including LVDS_DBG_P/N
HV | 0.30 | 1.0 | - | APD_BIAS, HV_K, HV_OUT, HV_CLAMP, HV_RAW, HV_V1, HV_PUMP and three clamp-transistor nodes (added conservatively, wanted or not is UNRESOLVED)
HV_LADDER | 0.30 | 0.6 | - | HV_MON divider midpoint and the FBX ladder nodes (steps of about 55 V)
DIFF90 | 0.145 | 0.15 | 0.145 / 0.15 | LVDS_OUT1_P/N, LVDS_OUT2_P/N (U50 to J50)
USB90 | 0.145 | 0.15 | 0.145 / 0.15 | USB_DP, USB_DN, USB_ESD_DP, USB_ESD_DN, USB_E_DP, USB_E_DN
CAN90 | 0.145 | 0.15 | 0.145 / 0.15 | CAN_P, CAN_N
DIFF100 | 0.11 | 0.15 | 0.11 / 0.15 | LVDS_P, LVDS_N (U20 to R180)

The custom DRC file receiver-module.kicad_dru adds HV edge and pad clearances and diff-pair rules. A syntax error makes KiCad silently ignore the whole file, so confirm a rule is live after editing. KiCad pairs nets by name only for _P/_N and +/-, so USB_DP/DM and CAN_P/L may not get the interactive diff-pair router. UNRESOLVED

### 7.5 J50 hole waiver and the ordering tier

J50's B-row through-holes (0.65 mm pad, 0.40 mm drill, 0.8 mm pitch, as Wuerth draws them, VERIFIED WE rev 003.000 p.1) are below JLCPCB's standard-tier minima (annular 0.15 mm, hole-to-hole 0.45 mm, hole-to-copper 0.30 mm): the ring is 0.125 mm and same-row wall-to-wall is 0.40 mm.

Order with "Min via hole size/diameter" = 0.25 mm/(0.35/0.4 mm), the high-precision tier. JLCPCB then auto-selects 4-Wire Kelvin Test and FR4 Tg155, at extra cost. JLCPCB's DFM accepted the test board hardware/pcb/j50-dfm-test with that option (screenshot, Daniel, 2026-10-09). receiver-module.kicad_dru waives the three hole rules for J50 only; every other footprint keeps the standard minima. This is the G4 pre-order item. No evidence exists that JLCPCB has fabricated this part; its availability at LCSC is UNRESOLVED. PROPOSED

Fab outputs under hardware/pcb/*/fab/ are git-ignored except under release/. The Gerber and drill export has not been done for a release. Do not order before the G4 pre-order checks pass.

08 · What is simulated

## Three ngspice runs, all SIMULATED

ngspice 47 with TI vendor macromodels (OPA855 Rev A, OPA857 v1.0, OPAx320 Final 1.6). Not VERIFIED: no hardware, no PCB or package parasitics, no tolerances, ideal supplies. Datasheet values are cited only for comparison. Source: simulation/README.md. Use these numbers to know what to look for at G1, not as predictions.

### 8.1 Sim 1: OPA855 post-amp as drawn (RF 301 / RG 49.9)

Metric | Result SIMULATED
Gain, passband | 16.70 dB (7.03), -3 dB at 2.13 GHz, 0.1 dB peaking at 128 MHz
Phase margin | 77 degrees, loop crossover 1.04 GHz (lower confidence, see below)
After R56/C54 | -3 dB at 69.5 MHz; the amplifier adds nothing visible
Small step, 2 ns edges | about 1.0 % overshoot, no ringing (0.4 % at 20 ns edges)
RF 453 / RG 75 (datasheet test values) | indistinguishable at gain 7: 77 degrees, 2.36 GHz
Layout parasitics, 0.3 / 0.5 / 1.0 pF on IN- and OUT (review P3, decision 27) | phase margin 76.1 / 75.4 / 73.7 degrees; closed-loop peaking 0.13 / 0.37 / 1.79 dB near 0.9-1.1 GHz; 0.2 ns-edge overshoot 3.4 / 6.6 / 16.6 % (3.2 % bare); the R56/C54 low-pass hides this from the comparator (reasoning, not simulated). 0.1 pF stray across R53 raises the margin to about 85 degrees but is not counted.
Gain 5 (below the datasheet minimum stable gain) | 6.1 dB peaking near 3.1 GHz, consistent with the datasheet warning

Could not show: real clipping and recovery (the model clips 0.25-0.35 V below the datasheet VOL and limit-cycles at 1-2 GHz); the model's AC loop-gain polarity is inverted against its transient behaviour in ngspice (cause not found), so the 77 degree figure is lower confidence than the overshoot numbers; idle level is 1.578 V in the model against 1.73 V derived; the FB-to-IN- layout parasitics.

### 8.2 Sim 2: OPA857 with APD capacitance (6 pF and 1.5 pF)

Mode, CD | -3 dB BW | Peaking | Overshoot, 5-UI run | Settle to 2 %
20k, 6 pF | 99 MHz | 0.97 dB at 54 MHz | 13.8 % | 12.6 ns
20k, 1.5 pF | 106 MHz | none | 1.7 % | 6.1 ns
5k, 6 pF | 151 MHz | none | 1.7 % | 4.7 ns
5k, 1.5 pF | 127 MHz | none | 0 % | 6.1 ns

At 1.5 pF the model gives 106 / 127 MHz against the datasheet 105 / 125 MHz (VERIFIED SBOS630D 6.5 p.6), which supports but does not prove its 6 pF behaviour. The 20k overshoot at 6 pF is signal shaping, not instability, but it is pattern-dependent ISI at 50 Mb/s that the slicer sees. 5k is the better mode whenever the signal allows. Could not show: APD series resistance, bias-dependent capacitance, noise, dark current. Single-ended transimpedance in the model is 19.5k against 18.2k datasheet. AC runs used a derived copy of the model with LIMIT() removed.

### 8.3 Sim 3: VCM_REF buffer (OPA2320 half)

R102 | Phase margin | Closed-loop peaking | 10 mV step overshoot at VCM_REF | Shift for 100 mV via 1 k
0.01 ohm (control) | 1.2 degrees | 33.3 dB at 190 kHz | 96 %, ringing | n/a
10 ohm (as drawn) | 87.6 degrees | 0.05 dB | 0 % | 0.96 mV
22 ohm | 86.2 degrees | 0.01 dB | 0 % | 2.0 mV
47 ohm | 84.1 degrees | 0 dB | 0 % | 3.9 mV

The isolation resistor is what stabilises the 1 uF load, consistent with the datasheet's roughly 1 nF direct-load limit (VERIFIED SBOS513F 7.3.8). Not simulated: the second channel, supply impedance, capacitive downstream loads. Real return currents are microamps; the test load drew 1.65 mA per 1 k.

#### Not done at all

No end-to-end TIA, post-amp, comparator run; no TLV3605 model (none obtained); no noise or BER simulation; no PCB parasitics; no tolerance or temperature sweeps; no fix for the OPA855 AC polarity quirk (a PSpice or TINA run would show whether it is ngspice-specific). The cascade OPA857 to C51 to OPA855 was not simulated. UNRESOLVED

09 · Bring-up gates

## Four gates, none started

From bringup/gates.md. Goals marked "goal" are provisional, not user-approved. Gate names follow gates.md (the authority); CLAUDE.md still carries the older G2 and G3 names. Do not order PCBs before the G4 pre-order checks pass. Checklist items are static here; the working checklist lives in gates.md.

### G1: fast-path proof

Acceptance: the manual-gain optical eye is open at the target rate across the bias range and both TIA gains; supplies meet worst-case needs; the TIA-to-post-amp interface is within limits. Compare each measurement with the simulated number named in its item.

#### APD and bias

- Pre-board, no Rev A needed (decision 31): optical power delivered to the APD in the real arena, through the real filter, onto a calibrated photodiode or the S12023-10 at M = 1; LED aimed at the receiver and aimed away, ambient with the LED off; arena dimensions and wall material recorded. Sets the LED current before the emitter is frozen.
- VBR and gain-vs-bias per unit at room temperature (S12023-10; record the voltage for M = 50 and 100)
- Bias ripple and noise at the APD node with the TIA running; compare SYNC float (pulse-skip) with Burst
- Cathode-capacitor discharge into a sacrificial TIA (C50 10 nF versus 4.7 nF)
- Bias temperature tracking over 15-35 C
- Ambient saturation margin with the real optical filter (20k, 60 uA)
- Record wavelength and optical power

#### TIA, post-amp, slicer

- Optical eye, step and saturation across the bias range and both TIA gains at fixed post-amp gain
- Post-amp clip test: 2x and 10x over the 9 uA (20k) clip with a 5-UI pattern; recovery and zero-crossing shift against 3 ns; look for oscillation while overdriven and the real clip near 1.05-1.15 V
- OPA855 stability as built (RF 301 / RG 49.9); compare 0.1 dB peaking, 2.13 GHz, about 1 % overshoot; idle level against 1.578 V and 1.73 V
- OPA857 at 6 pF in both modes: bandwidth, peaking and the 50 Mb/s eye; compare 20k 13.8 % / 12.6 ns and 5k 1.7 % / 4.7 ns. The 20k eye is the key one
- VCM_REF step with C101 1 uF, R102 10 ohm; compare 87.6 degrees and 0.96 mV
- Comparator small-signal: 5-30 mV pulses at VCM 1.65 V; delay, jitter, input noise, bias-current offset through the 1 k returns
- Chain noise at the comparator input with the 6 pF APD connected, 20k and 5k
- AC-coupling response to training, gaps and abrupt light changes
- 20k/5k and bias-step switching transients: time until the slicer is valid again

#### Power, USB, connector

- Supply load test, sequencing, ripple, thermal, bias startup
- eFuse U5: OV cut-off (calculated 5.76-6.20 V), UVLO (4.06-4.32 V rising, 3.72-4.00 V falling), ILIM (0.68-0.84 A), first-plug inrush with C32 47 nF and an estimated 25 uF (about 5.3 ms, about 23 mA); check FLT and IMON
- Fan-out U50: LVDS eye at the receptacle on both TX pairs through a 2 m certified cable at 50 Mb/s; VOD and common mode against the ECP5 +/-100 mV threshold; 3V3 current; J51 output 3 eye
- USB auto-reset and download through the 22 ohm resistors and USBLC6 from a laptop root port; RESET/BOOT recovery; 3V3_D rise against the EN RC
- USB-alone self-test current at dark, at 220 V with 0.5-1 mA load, and at ESP32 boot and flash peaks, against 0.19 A (0.24 A) and the 0.5 A default; CC voltages with a real source port and 2-3 laptops or hubs

### G2: range-trim proof

Goal: show that the ESP32's slow trim (APD bias via DAC_HV, TIA_CTRL 20k/5k) holds the link near the Q(M) optimum using RSSI and FPGA validity, and that no analog AGC is needed because intensity changes track animal motion.

- RSSI against photocurrent across M and 20k/5k: monotonic, repeatable, drift bounded with temperature
- PRBS BER against photocurrent at fixed settings: confirm the single-setting window (10 to 12 dB optical unclipped, about 19 dB optical / 39 dB electrical to TIA saturation; decision 31) and the clip-region behaviour
- Trim-loop step response: 10 dB up and down, time to valid frames, no oscillation between 20k and 5k
- APD M against bias and temperature per unit; DAC_HV EEPROM default and HV_DIS gating verified

### G3: system-behaviour proof

- Dark start, weak light, sudden strong light, interruption and return (firmware trim plus FPGA reacquisition)
- DAC_TH eye walk: BER against threshold offset, centre found by firmware
- Latch, shutdown and independent-clock timeout behaviour; CAN under load; module identity
- 6.63 MHz field injection with the module in the housing

### G4: system proof

Acceptance: BER measured against known transmitted truth meets the approved target (BER <= 1e-9 is a provisional goal); redundancy works; CAD checks pass before any board order.

- BER against known transmitted truth
- Redundancy: skew, missing lane, conflicting frames, CRC errors, rejoin
- Pre-order CAD checks: symbols, footprints, pin maps, ERC, DRC, stackup, independent review. Order at JLCPCB with "Min via hole size/diameter" = 0.25 mm/(0.35/0.4 mm), 6 layers, JLC06161H-3313, ENIG, impedance control; confirm the 90/100 ohm geometries in JLCPCB's calculator (ours are computed, PROPOSED). The J50 hole waiver relies on the 2026-10-09 DFM pass with that option.
- Laptop foreign-host test: two different laptops (ideally two operating systems or vendors, USB 3 Type-C); scope the CAN pins and the LVDS pair; does the host treat the CAN load as a termination, how it handles receiver-detect and SBU; the module must stay harmless and the CAN silent; choose mitigations afterwards
- 3 m cable check for a specific passive cable: SuperSpeed wire continuity (A2 to B11 etc.), then scope LVDS and CAN; accept 3 m only for that cable
- CAN with 14 stubs: one split termination at the breakout, 125 kbit/s, R199 100k, stubs up to 3 m; error counters and edges
- CAN-to-LVDS crosstalk inside the cable: CAN edges (about 2 V) against the LVDS pair (about 350 mV); BER with CAN traffic on and off
- USB-PD charger or hub plugged into a module: stays at 5 V, tolerates a hard-reset VBUS dip; hub-powered current behaviour

10 · Open risks and UNRESOLVED items

## What could still go wrong, by block

The biggest risks, in the project's own words: the APD bias supply, the 24-pin USB-C cable and foreign-host behaviour (decision 14), OPA857 behaviour at 6 pF, post-amp clipping and recovery together with comparator noise at small overdrive (decision 12), and the firmware range-control loop (M against temperature, 20k/5k scheduling). Everything below is UNRESOLVED until measured.

#### Detector and optics

- Received power has never been measured. The link budget is an estimate from LED datasheets and a joint transmitter and receiver budget; the direct path alone needs an emitter about 5x the reference LED, and the optics, arena and tiling credits (decision 31) are models with unknown wall reflectance and arena size. The arena measurement is a G1 pre-board item.
- Headstage power available for the emitter: the "~200 mW" figure has no source. A 1 W class LED at 30 to 200 mA on-state is the working assumption.
- APD operating voltage per unit (datasheet gives VBR only; Vop is graph-read).
- Installed detector capacitance at the actual bias, including lead and pad parasitics (6 pF is the datasheet typ).
- Ambient is multiplied by M; the optical bandpass filter is mandatory and its real attenuation is unknown. Ambient level and maximum fade rate are unknown.
- Emitter wavelength, intensity, drive and modulation (co-design variables).

#### APD bias supply

- Ripple and noise at the cathode with the TIA running; pulse-skip versus Burst.
- C50 capacitor dump into the TIA at a fault.
- Temperature tracking method (NTC divider plus ESP32 DAC trim) until G1.
- HV state if 3V3_D is absent; Q3 and EN/UVLO thresholds not rechecked; D2 purpose in the LT8365 reference circuit not stated.
- Whether a faulted HV start can trip a USB port (hence the stepped start).

#### TIA, post-amp, slicer

- OPA857 at 6 pF: datasheet gives a noise plot only; the 20k mode shows ISI in simulation.
- Real OPA855 clip level, recovery and any limit cycle; RF/RG stability as built; idle level.
- TLV3605 input noise and delay below 10 mV overdrive (none in the datasheet); bias current at VCM = 1.65 V; jitter added by the hysteresis network.
- AC-coupling baseline wander with real 8b/10b traffic; slicer recovery after a CTRL or bias switch.

#### Connector, cable, host

- Whether any 3 m passive full-featured cable exists; a non-compliant cable leaves only about 50 mV over the eFuse UVLO maximum.
- Laptop and hub behaviour on the SuperSpeed pins and SBU (receiver-detect, CAN load, alternate-mode SBU drive); the USB 3.2 and PD specs were not obtained.
- CAN with 14 stubs; CAN-to-LVDS crosstalk in the cable.
- CC classification margin; clamp injection on the CC taps; unidirectional ESD clamps near -0.7 V on CAN.
- Footprint checks: Wuerth part (top or mid mount), TPS259631 DDA land pattern, TPD6E05U06 USON-14, SN65LVDS104 TSSOP.
- USB-PD charger or hub plugged into a module.

#### Power and controller

- eFuse thresholds, inrush, FLT usefulness; 3V3 and 3V3_D dropout against the UVLO falling range.
- Whether a bus-powered hub holds a module to 100 mA; the C6's USB bMaxPower descriptor.
- USB auto-reset into download mode through the 22 ohm resistors and USBLC6; D+ pull-up backdrive into an unpowered host.
- Firmware range-trim thresholds, dwell times and the 20k/5k schedule are first guesses. Whether to hold bias for a time on CAN loss is a Daniel decision.
- Per-unit M calibration; absolute M needs a bench reference.
- Self-test cannot prove the comparator or LVDS output without an FPGA or optical source.

#### FPGA end and system

- Host link (FX3 first candidate; the GPIO count of 28 is a belief).
- Breakout board not designed; the polarity constant is not yet recorded in breakout or gateware docs.
- nextpnr DIFFRESISTOR support; 7 clean LVDS pairs per ULX3S against 14 modules.
- Burst and idle structure of the 8b/10b stream; redundant-lane skew and merge policy.
- Master firmware, and whether the ULX3S's own ESP32 can be the CAN master.
- BER (1e-9), reacquisition (20 ms) and LOS detection (1 ms) goals are provisional and unapproved (requirements.md item 3).

#### Layout and fab

- Routing is complete. Plane cut-out under the TIA input; exact HV island position depends on the housing.
- Impedance geometries are computed, not JLCPCB calculator output.
- J50 hole waiver depends on the high-precision tier and the DFM pass; no JLCPCB or LCSC listing for the part was found.

11 · Decisions and standing corrections

## How the design got here

Verbatim authority is decision-log.md. Do not contradict it without Daniel's explicit approval. Rows struck through are superseded history.

### 11.1 Decisions 1-14

# | Date | Decision | Standing

1 | 2026-10-08 | Analog-first: slicing is analog, MCU/ADC hooks optional. Read since decision 12 as "slicing stays analog; range control is a firmware trim". | Active
2 | 2026-10-08 | Single PCB, hierarchical sheets, for rapid iteration instead of many coupons. | Active
3 | 2026-10-08 | ULX3S first FPGA target. LVDS straight into gp/gn[8..13] or [14..21] with DIFFRESISTOR = 100, no receiver IC. VERIFIED ulx3s-lvds-input.md. | Active
4 | 2026-10-08 | Shielded housing and swappable filter; the 6.63 MHz QSCR field is in-band; one module serves 630 nm and 765 nm. | Active
5 | 2026-10-08 | Rails +/-3.7 V; APD_BIAS 100-220 V (replaced PD_BIAS of 6.5 V or more). | Rails part removed by decision 12; APD_BIAS range stands
6 | 2026-10-08 | All new parts via lab-library PR; no project-local symbols. | Active
7 | 2026-10-08 | Headstage co-designed with the receiver; no backward compatibility; link budget is joint. | Active
8 | 2026-10-08 | Silicon APD selected (S12023-10 primary). A bare FDS010 PIN is 18-23 dB short of Q = 6 at 35 cm lateral. D11 FDS010 footprint dropped from Rev A on 2026-10-09. PROPOSED | Active
9 | 2026-10-08 | APD bias made on board: LT8365 boost plus charge-pump doubler, two-stage RC filter, series limit, NTC tracking with DAC trim. PROPOSED | Active
10 | 2026-10-08 | Rev A schematic choices: LOS comparator as status only, header gain sources, APD filter split, 6-pin MCU header. | Mostly superseded by 11 and 12; the HV filter split, HV_ naming and HV_MON remain
11 | 2026-10-08 | ESP32-C6 module controller on every module, CAN to the FPGA side, no BLE, separate 3V3_D rail. PROPOSED | Active; HOLD_N and AGC parts superseded by 12
12 | 2026-10-08 | Fixed-gain OPA855 x7 post-amp and baseline slicer replace the VCA821, AGC loop and peak detectors; firmware range trim. Approved by Daniel. PROPOSED | Active
13 | 2026-10-09 | USB standalone power and programming (requirement kept). The TPS2121 mux, PWR_SRC, VBUS_SENSE, 16-pin J60 and 12-pin J50 are superseded. | Requirement active; parts superseded by 14
14 | 2026-10-09 | One 24-pin USB-C per module; TPS259631 eFuse; SN65LVDS104 fan-out; CAN on both RX pairs; SBU as AUX; J51 kept as scope header; cable rule. PROPOSED | Active
15 | 2026-10-09 | Layout-phase decisions: generators frozen, 6-layer JLC06161H-3313, hand placement; see decision-log.md entry 15. PROPOSED | Active
16 | 2026-10-22 | J50 shell tied directly to GND (C181 and R170 deleted); every shell post gets several GND vias. PROPOSED | Active
17 | 2026-10-22 | S12023 pinout corrected: pin 1 = anode, pin 3 = cathode (KAPDA0136EC bottom view); D10 rotated 180 degrees on the board. VERIFIED | Active; standing correction 15
18 | 2026-10-22 | R7 20 ohm moved from series with D1 into the pump-charge path (HV_V1 to D3 anode), as LT8365 p.30 R8 / DC2838A R10. VERIFIED | Active
19 | 2026-10-22 | DAC leg R14 442k to 150k: production bias range (pot leg DNP) 50-219 V from the DAC alone, LSB 41 mV, tempco unchanged; R15 (DNP) 274k to 1M. PROPOSED calculated | Active
20 | 2026-10-22 | Blank MCP4728 (code 0 = maximum bias, -16 mV threshold) handled by the HV_DIS interlock plus firmware self-provisioning of the EEPROM at first boot; J1 only after that; ESP32 brownout level above the DAC POR. No hardware change, no external programming step. PROPOSED | Active
21 | 2026-10-22 | Hard rule 1 reworded: the signal path is firmware-free, the APD bias is enabled only by the provisioned ESP32; an unprogrammed module is safe but dark. VERIFIED netlist | Active
22 | 2026-10-22 | R17, R18, R20, R32 (4.99 M, 110 V each at 220 V) moved from 0603 to 0805: 150 V working rating, Yageo RC0805 spec V0 p.3. VERIFIED rating | Active
23 | 2026-10-22 | Hardware over-voltage limiter on the HV supply: TLV431A on the HV_MON tap (R21 split 45.3k/54.9k) pulls LT8365 EN low at about 228 V; R22/R23 20k. PROPOSED calculated | Active
24 | 2026-10-22 | Clamp pass transistor made a Darlington: Q4 MMBTA42 drives Q1's base, removing the Ic x 10 M / hFE bias drop at the APD side (3 V per 10 uA single, about 0.1 V per 10 uA Darlington, assumed hFE 30). PROPOSED calculated | Active
25 | 2026-10-22 | D10 pad spacing waiver: S12023 TO-18 pads 1.2 -> 1.0 mm (lab-library PR #65), cathode pad 0.80 mm from the case pad and 1.54 mm from the anode pad (VERIFIED in CAD), below the project 1.5 mm / IPC 1.25 mm uncoated figures but above the 0.4 mm coated one, so the solder side at D10 is cleaned and conformal-coated after assembly. PROPOSED | Active
26 | 2026-10-22 | Cathode capacitor C50 moved to the can (HV_K pad 4.43 mm from the cathode pad, was 6.78 mm of trace; calc rule 6 amended since a 1210 cannot reach 3 mm), HV_K exits the pad radially, and D10 is mounted on a 1.5 mm insulating TO-18 spacer so the grounded header sits over air (KAPD1007E19 p.4 shows no standoff VERIFIED; spacer part UNRESOLVED). PROPOSED | Active
27 | 2026-10-22 | OPA855 cell re-laid out: U11 rotated so FB/IN- face R53/R54 (FB 1.4 mm, IN- 3.2 mm), no-pour windows under the input and output pins on all layers, R56/C54/C52 moved to the output side, TP10 moved to LPF_OUT. Sim with 0.5 pF of layout parasitics: phase margin 75.4 degrees (77.1 bare), 0.4 dB peaking near 1 GHz that the 68 MHz low-pass hides. SIMULATED PROPOSED | Active
28 | 2026-10-22 | Ground-return vias: C5 GND pad 3 vias, LT8365 exposed pad 5 vias, all J50 shell pads solid-connected on every layer (the plated posts tie the planes themselves, decision 16 reworded), vias at U50 pin 8 and the OPA857 caps C56/C57. Eleven other pads still lack a nearby via (no legal spot without a local re-route; list in the decision log). PROPOSED partial | Active
29 | 2026-10-22 | HV vias on the clamp base nets accepted: five vias and about 14 mm of In2 track within 2 V of HV_OUT; 220 V across the 0.1088 mm prepreg to the In3 ground pour is about 2 kV/mm against typical FR4 breakdown above 20 kV/mm (no JLCPCB figure). PROPOSED | Active
30 | 2026-10-22 | All vias epoxy filled and capped at order: 155 of 209 vias are inside pads, where tenting does not apply. Quote-time checks: DFM accepts 0.25/0.45 with filling on the high-precision tier, and the price. The twelve 0402 pads with a via stay a solder-joint watch item. PROPOSED | Active
31 | 2026-10-23 | Link budget corrected to the built chain (70 MHz noise bandwidth, M optimum 83 to 112 capped at 100, optical dB, old emitter target at an impossible 229 % efficiency): direct path alone needs 11 to 12 mW/sr, 4.5 to 4.8x the reference LED. Optics, the reflective arena and receiver tiling recorded as PROPOSED credits. Working emitter: 1 W class 850 nm LED at 30 to 100 mA on-state, up to 200 mA without the credits. Arena photocurrent measurement is a G1 pre-board item. S3884 larger APD not adopted for Rev A (OPA857 20k rings at 10 pF, SIMULATED); dual TO-18/TO-5 footprint rejected. PROPOSED | Active
32 | 2026-10-23 | Review MINOR schematic set: 3V3 retargeted to 3.42 V (R1 18.7k) for the OPA855 3.3 V minimum; OPA855 gain parts 0.1 %; C50 500 V C0G, R50 200 V, C54/C87 C0G stated in the value fields; R199 91k; C200 DNP; R214 2.2k in series with the TIA_CTRL GPIO; D2 fitted for the first build. Checked, no change: OPA857 bypass (datasheet asks 0.1 uF), TLV3605 LE/HYS floating (datasheet-characterised), R33 stays on 3V3_D. Deferred: VBUS TVS part. PCB: R214 placed, dangling vias and stubs removed, DRC 44. PROPOSED | Active
33 | 2026-10-25 | DRC closed out: H1-H4 on the no-via mounting-hole footprint (32 hole-to-hole items gone), U20 pin 9 solid zone connection, the four LVDS diff-pair gap items at R180 and the R87 stub accepted in writing (invisible at 50 Mbps), silk-edge and silk-overlap items accepted. DRC 11, 0 unconnected, ERC 0/0. Open on Daniel's side: +5V pour around the regulators, 5V_HVIN widening, C5 next to D1, silkscreen text. PROPOSED | Active
34 | 2026-10-25 | VBUS transient suppressor D50 added: SMF5.0A unidirectional TVS (200 W, 5 V standoff, 9.2 V clamp, SOD-123FL) at the J50 VBUS pins; breakdown above the eFuse OVLO trip, clamp below the TPS2596 21 V absolute maximum. Lab library PR #66 adds the symbol and footprint; footprint parked on the board for Daniel to place and route. PROPOSED | Active

### 11.2 The 15 standing corrections

Corrections 1, 4, 5, 7, 8 and 9 refer to the VCA821 and AGC chain and are superseded by decision 12. Correction 11 still applies. The log marks no others as superseded; notes on 6, 10, 13 and 14 are this guide's reading of what remains relevant.

# | Correction | Status

1 | OPA857 OUT/OUTN are AC-coupled into the VCA821, never DC-wired (OUTN is about 1.83 V). | Superseded by 12. The AC coupling principle lives on (C51, 100 nF).
2 | APD cathode to positive bias through the RC filter and current limit, anode to OPA857 IN; reverse bias is about cathode voltage minus 1.83 V. | Active. Applies to the S12023-10.
3 | FDS010 capacitance is 6 pF typ at 10 V reverse bias. VERIFIED Thorlabs 0636-S01 Rev I (2017-03-16) p.1; pins 1 anode, 2 case, 3 cathode (p.3). The older 2 pF figure (Rev E) is superseded. | Active. 6 pF is used for the S12023-10 as well.
4 | +/-3.5 V is the VCA821 minimum; nominal rails +/-3.7 V. | Superseded by 12.
5 | VCA821 RF is compensation; RG current limit can overload the input. | Superseded by 12.
6 | A unity buffer plus diode is not a precision peak detector; the fast high/low detector is the main unresolved block, built as a swappable sub-circuit. | Not on the superseded list, but the detector it describes was removed with decision 12. The RSSI diode is telemetry only.
7 | VSPAN subtractor with matched 10k 0.1 % resistors. | Superseded by 12.
8 | VMID from two matched 10k into a high-impedance buffer; no resistor into a buffer output for trim. | Superseded by 12.
9 | AGC is a true integrator, 100k/47 nF, 4.7 ms; anti-windup on integrator state. | Superseded by 12.
10 | Post-AGC span alone cannot prove signal presence; gain bounds, dwell and FPGA digital validity decide. | Not on the superseded list; its lesson stands: the FPGA decoder is the LOS judge.
11 | TLV3605 SHDN is active-low and shutdown is not a guaranteed zero; LE/HYS low latches the last state; both constant LVDS states are "invalid" after an FPGA timeout on an independent clock. | Active.
12 | FPGA watchdog runs on an independent local clock; reacquire CDR and framing after release; invalid-code counts are not a BER measurement. | Active.
13 | SAMD51 DACs are 12-bit; OPA320 is single, OPA2320 dual. | The SAMD51 is gone; module DACs (MCP4728) are 12-bit; the dual OPA2320 is on the Monitor sheet.
14 | LM27762 positive and negative references differ. The MAX15032 bias rule (VIN + 1 V, 6.5 V or more) applied to the PIN design. | Both parts are gone (decisions 8 and 12). History only.
15 | S12023-10/-05 TO-18 pins: 1 = anode, 2 = case, 3 = cathode (KAPDA0136EC pin diagram, bottom view). VERIFIED | Active since 2026-10-22 (decision 17); D10 is rotated 180 degrees on Rev A.

12 · Sources

## Where every claim came from

### 12.1 Repo documents

#### Authority

- requirements.md
- decision-log.md
- architecture.md
- bringup/gates.md
- CLAUDE.md (hard rules, standing corrections, open risks)

#### Schematic

- schematic/overview.html (per-sheet parts and pinouts; not duplicated here)
- schematic/rev-a-sheet-specs.md (revision 4)
- power.md, frontend.md, slicer.md, control.md (Monitor), connector.md, controller.md

#### Board and fab

- hardware/pcb/receiver-module/README.md
- pcb/placement-plan.html
- pcb/jlcpcb-fab-settings.md
- pcb/j50-receptacle-dfm.md

#### Analysis and research

- simulation/README.md
- calculations/apd-bias-design.md
- calculations/link-budget.md
- research/post-amp-slicer.md
- research/decision-14-draft-usbc-single-connector.md
- research/ulx3s-lvds-input.md
- research/README.md (index; research/downloads/ is untrusted raw data)

#### Firmware

- firmware/esp32/README.md (plan, boot, range-trim)
- firmware/can-and-console-protocol.md
- firmware/esp32/HIL.md (bench and CI plan) and firmware/esp32/web/ (browser flasher)
- firmware/ecp5/README.md (ECP5 gateware spec, line protocol, ULX3S pins, status) and firmware/ecp5/model/ (Python golden model of the line protocol)

### 12.2 Datasheets and standards cited

Revisions and page numbers are as the repo docs give them. Local copies are in docs/datasheets/ where listed in its MANIFEST.

Part or document | Document and revision | Used for
OPA857 | TI SBOS630D (Aug 2016) | TIA polarity, swing, 1.5 pF characterisation, abs max
OPA855 | TI SBOS622D | gain 7, FB pin, input range, VOL, recovery, power-down
TLV3604/3605/3607 | TI SNOSDA2F | offset, bias current, hysteresis, LVDS levels, absence of noise data
OPA320 / OPA2320 | TI SBOS513F (Dec 2016) | capacitive-load guidance, supply range
SN65LVDS104 | TI SLLS396G | fan-out thresholds, enables, termination, supply current, fail-safe
TPD6E05U06 | TI SLVSBO7O | ESD capacitance and VRWM
TPS259631 (TPS2596x) | TI SLVSET8A | pin map, ILIM, UVLO and OVLO equations, abs max
TPS79901 (TPS799) | TI SBVS056L | feedback reference, abs max, CFB rule
TPS7A2033 (TPS7A20) | TI SBVS338H (Jul 2024) | capacitor window, thermal resistance
LT8365 | Analog Devices Rev. A; DC2838A demo manual Rev. 0 | boost topology, SYNC/MODE, switch limits
SN65HVD230 | TI SLOS346O; app note SLLA270 | CAN rise times, stub rule, termination
MCP4728 | Microchip DS22187E | EEPROM defaults, Read command
ADS1115 | TI SBAS444E | input limits
ESP32-C6, MINI-1 | Espressif datasheet v1.5, MINI-1 datasheet v1.5, TRM v1.2, hardware design guidelines | pins, strapping, TWAI, USB Serial/JTAG, ADC
ECP5 and ULX3S | Lattice FPGA-TN-02032 v1.4; ECP5 DS Table 3.13; ULX3S schematic v3.1.7 | LVDS input, DIFFRESISTOR, banks
S12023-10 / S12023-05 | Hamamatsu (KAPDB0017EC, graph-read figures); summarised in research/apd-selection.md | APD facts
FDS010 | Thorlabs 0636-S01 Rev I (2017-03-16) | bench fallback capacitance, pinout
USB Type-C | Specification R2.0 and R2.5 (cited via the research notes) | pin names, cable wiring, CC levels, SBU
Wuerth 632723300011 | Wuerth rev 003.000 (2025-09-04) | footprint, pad and drill sizes
JLCPCB | capability, impedance and calculator pages, read 2026-10-09 | stackup, rules, tiers

Derived document. Authority: docs/requirements.md, docs/decision-log.md, docs/architecture.md, docs/bringup/gates.md. Historical Rev A.1 guide (FDS010/VCA821/AGC) in initial planning docs/ is superseded.
