daharoni/photodiode-lvds-receiver/docs/simulation/plots/opa855-parasitic-step.png

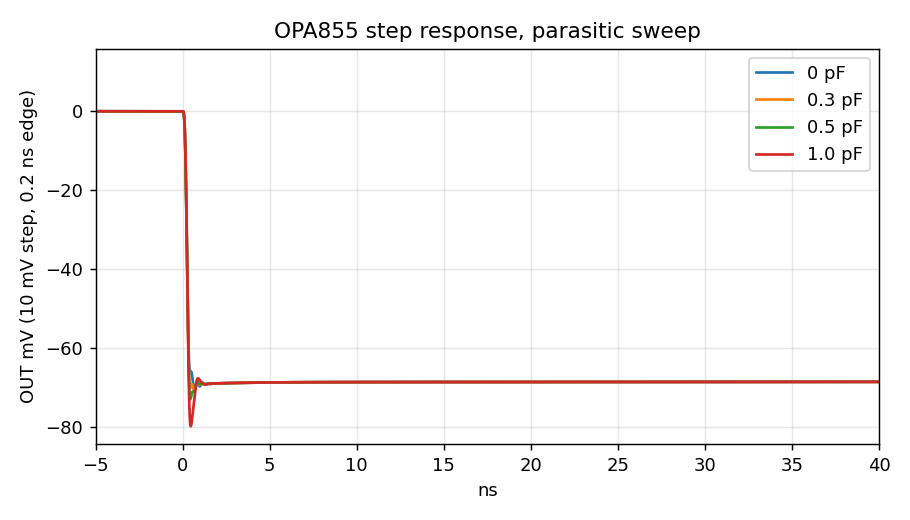
docs/simulation/plots/opa855-parasitic-step.png
