daharoni/photodiode-lvds-receiver/docs/simulation/plots/sim3_step.png

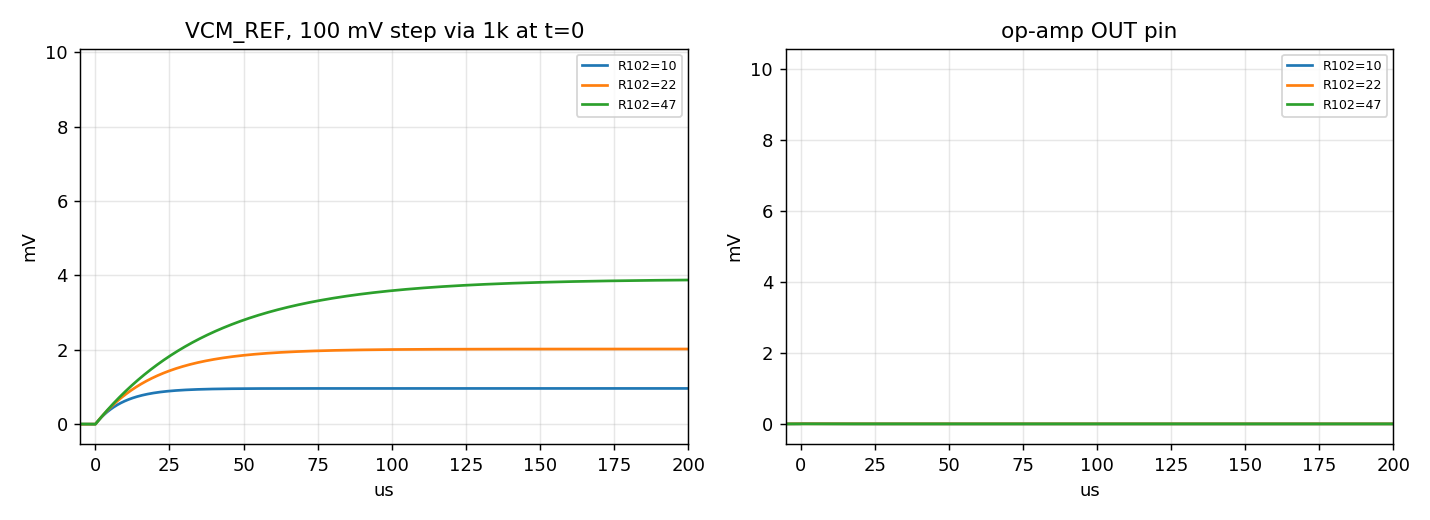
docs/simulation/plots/sim3_step.png
