daharoni/photodiode-lvds-receiver/docs/research/downloads/spice-models/opa857/SBOMBP8/OPA857-PSpiceFiles/SCHEMATIC1/TransientAnalysis/TransientAnalysis.cir

** Profile: "SCHEMATIC1-TransientAnalysis"  [ C:\Users\a0232073\Downloads\OPA857\OPA857-PSpiceFiles\SCHEMATIC1\TransientAnalysis.sim ] 

** Creating circuit file "TransientAnalysis.cir" 
** WARNING: THIS AUTOMATICALLY GENERATED FILE MAY BE OVERWRITTEN BY SUBSEQUENT SIMULATIONS

*Libraries: 
* Profile Libraries :
* Local Libraries :
.LIB "../../../opa857.LIB" 
* From [PSPICE NETLIST] section of C:\SPB_Data\cdssetup\OrCAD_PSpiceTIPSpice_Install\17.4.0\PSpice.ini file:
.lib "nom_pspti.lib" 
.lib "nom.lib" 

*Analysis directives: 
.TRAN  0 100ns 0 0.1e-9 
.OPTIONS ADVCONV
.OPTIONS FILEMODELSEARCH
.PROBE64 N([OUT])
.PROBE64 N([OUTN])
.INC "..\SCHEMATIC1.net" 


.END
