daharoni/photodiode-lvds-receiver/(list of files, drawings)

Other design files:
docs/research/downloads/spice-models/opa320/SBOM437/OPAx320-Q1.OLB
docs/research/downloads/spice-models/opa320/SBOM437/OPAx320-Q1_Test_Circuit.DSN
docs/research/downloads/spice-models/opa320/SBOM437/OPAx320-Q1_Test_Circuit.OPJ
docs/research/downloads/spice-models/opa855/SBOMB43/opa855_pspice/opa855_pspice.dsn
docs/research/downloads/spice-models/opa855/SBOMB43/opa855_pspice/opa855_pspice.opj
docs/research/downloads/spice-models/opa857/SBOMBP8/opa857.dsn
docs/research/downloads/spice-models/opa857/SBOMBP8/opa857.opj
