daharoni/photodiode-lvds-receiver/hardware/pcb/receiver-module/receiver-module.kicad_pcb

## KiCad design hardware/pcb/receiver-module/receiver-module.kicad_pcb (2026-10-25)

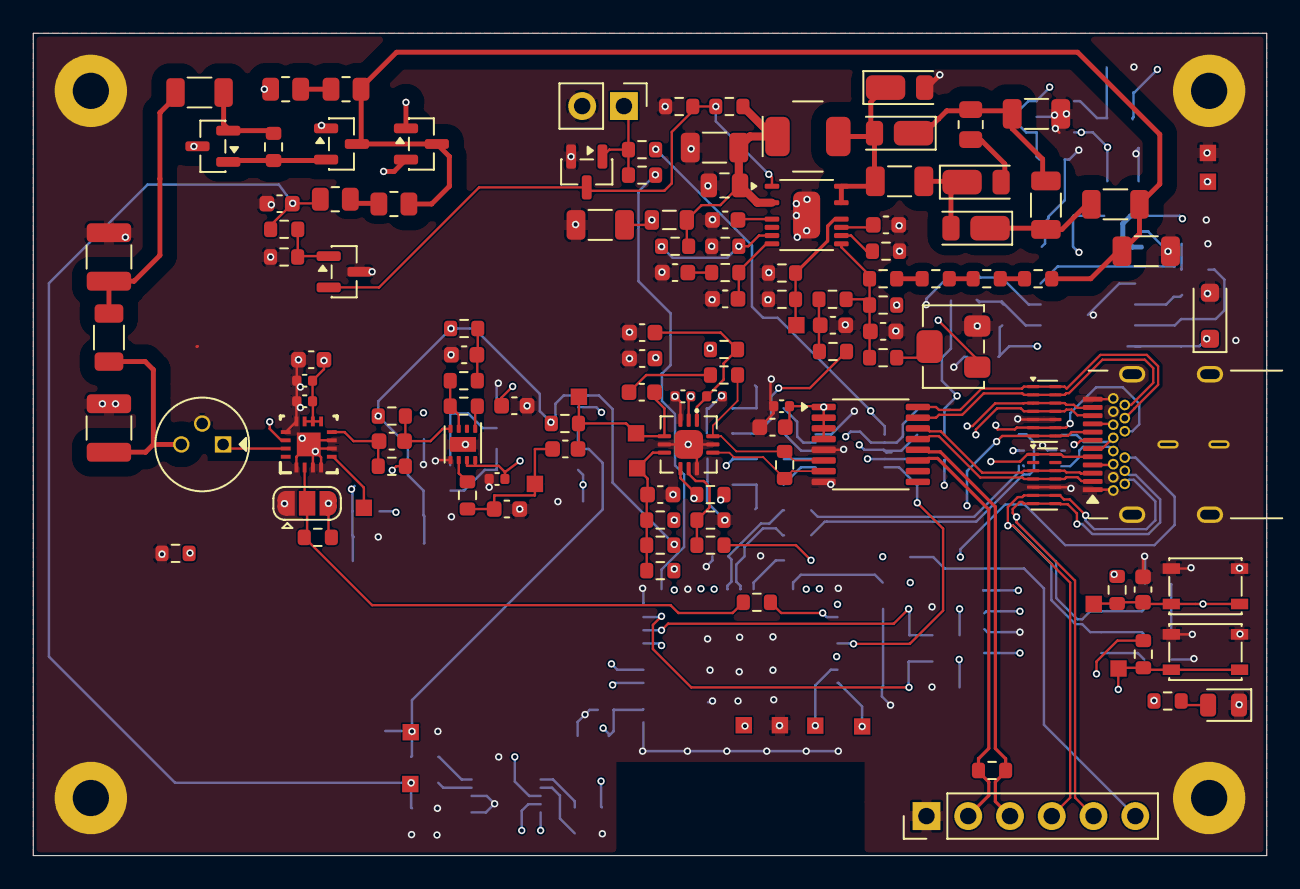
[picture p30: board receiver-module.kicad_pcb from above]

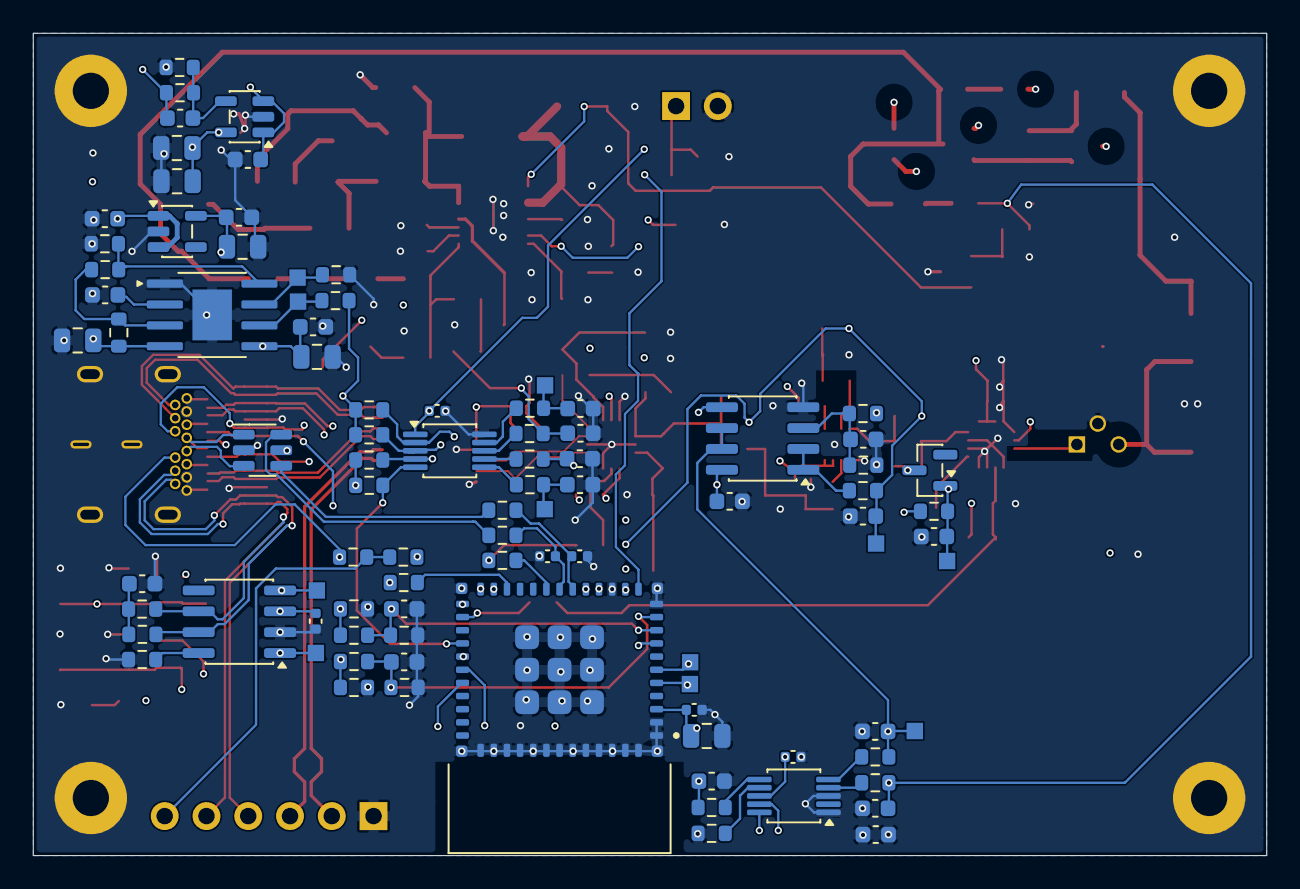
[picture p31: board receiver-module.kicad_pcb from below]

Board: 6 copper layers, 75.0 x 50.0 mm, 226 parts (92 on the bottom side), 121 nets.

Parts:
C1, C30: 10uF 10V; C_0805_2012Metric_N
C2, C27, C182, C183: 100nF; C_0603_1608Metric_N
C5, C6, C7: 0.1uF 200V X7R; C_1206_3216Metric_N
C8, C50: 10nF 500V C0G; C_1210_3225Metric_N
C9, C185: 1uF; C_0603_1608Metric_N
C10, C11: 4.7uF 10V; C_0805_2012Metric_N
C12, C23: 1nF C0G; C_0603_1608Metric_N
C18, C19: 10uF 50V; C_1206_3216Metric_N
C20: 4.7uF 50V; C_0805_2012Metric_N
C21: 1uF 25V; C_0603_1608Metric_N
C22: 0.22uF; C_0603_1608Metric_N
C24, C26: 10pF C0G; C_0603_1608Metric_N
C25: 1nF 500V; C_1206_3216Metric_N
C28: 10nF; C_0603_1608Metric_N
C29, C31: 1uF 10V; C_0603_1608Metric_N
C32: 47nF X7R 10V; C_0603_1608Metric_N
C33: 4.7uF 25V; C_0805_2012Metric_N
C51, C55, C100, C103, C201, C202, C203, C204: 100n; C_0603_1608Metric_N
C52, C56, C57, C80, C82, C192, C194, C195, C196: 100n; C_0402_1005Metric_N
C53, C58, C59, C81, C83, C101, C190: 1u; C_0603_1608Metric_N
C54: 47pF C0G; C_0603_1608Metric_N
C84, C197, C198, C199, C200: 10n; C_0603_1608Metric_N
C87: 100pF C0G; C_0603_1608Metric_N
C102: 1n C0G; C_0603_1608Metric_N
C180: 4.7nF; C_0603_1608Metric_N
C184: 100nF; C_0402_1005Metric_N
C191: 10u; C_0805_2012Metric_N
C206, C207: TBD; C_0402_1005Metric_N
D1, D2, D3, D4: DFLS1150-7; Diodes_PowerDI-123
D10: S12023-10; Hamamatsu_S12023_TO-18_P2.54mm_Vertical
D30: BAS70; SOT-23
D50: SMF5.0A; D_SOD-123F
D60: LED; LED_0805_2012Metric
H1, H2, H3, H4: MountingHole_Pad; MountingHole_2.2mm_M2_Pad
J1: HV FORCE ON; PinHeader_1x02_P2.54mm_Vertical
J50: 632723300011; Wuerth_632723300011
J51: DEBUG / scope; PinHeader_1x06_P2.54mm_Vertical
JP10: 3V3=20k; SolderJumper-3_P1.3mm_Open_RoundedPad1.0x1.5mm
L1: 10uH 1.5A; Wuerth_74437324100
L2: 0.47uH 2.1A; L_0805_2012Metric_N
Q1, Q4: MMBTA42; SOT-23
Q2: MMBT3904; SOT-23
Q3: DMN2056U-7; SOT-23
R1: 18.7k 1%; R_0603_1608Metric_N
R2: 10.0k 1%; R_0603_1608Metric_N
R7: 20R; R_0805_2012Metric_N
R8, R9, R10, R11: 2.05M 1%; R_0603_1608Metric_N
R12: 86.6k 1%; R_0603_1608Metric_N
R13, R81, R86, R100, R101, R190, R191, R192, R197, R198, R206, R207, R208, R209: 10k; R_0603_1608Metric_N
R14: 150k 0.1%; R_0603_1608Metric_N
R15, R103: 1M; R_0603_1608Metric_N
R16: 4.02k 1%; R_0603_1608Metric_N
R17, R18, R20, R32: 4.99M 1% 0805 150V; R_0805_2012Metric_N
R19: 27k 1206 200V; R_1206_3216Metric_N
R21: 45.3k 1%; R_0603_1608Metric_N
R22, R23: 20k 1%; R_0603_1608Metric_N
R24, R25: 84.5k 1%; R_0603_1608Metric_N
R26, R33, R39, R57, R85, R185, R187, R188, R189: 100k; R_0603_1608Metric_N
R27, R28, R29, R80, R83, R205: 0R; R_0603_1608Metric_N
R30: 47R; R_1206_3216Metric_N
R34, R51, R58, R59, R84, R186, R203, R204: 1k; R_0603_1608Metric_N
R35: 357k 1%; R_0603_1608Metric_N
R36: 43.2k 1%; R_0603_1608Metric_N
R37: 100k 1%; R_0603_1608Metric_N
R38: 1.21k 1%; R_0603_1608Metric_N
R45: 54.9k 1%; R_0603_1608Metric_N
R50: 10k 200V; R_1206_3216Metric_N
R53: 301 0.1%; R_0603_1608Metric_N
R54: 49.9 0.1%; R_0603_1608Metric_N
R56: 49.9; R_0603_1608Metric_N
R60, R102: 10; R_0603_1608Metric_N
R82: 150k; R_0603_1608Metric_N
R87: 5.49k; R_0603_1608Metric_N
R177, R210, R211, R212, R213: 100R; R_0603_1608Metric_N
R180: 100R 0.1%; R_0603_1608Metric_N
R181, R184: 5.1k 1%; R_0603_1608Metric_N
R182, R183: 60.4R 1%; R_0603_1608Metric_N
R193, R194: 22R; R_0603_1608Metric_N
R195, R196: 4.7k; R_0603_1608Metric_N
R199: 91k; R_0603_1608Metric_N
R214: 2.2k; R_0603_1608Metric_N
RV1: 50k trim; Bourns_3224W_SMD
SW60: RESET; SW_SPST_PTS810
SW61: BOOT; SW_SPST_PTS810
TH1: NTC 10k B3950; R_0603_1608Metric_N
TP2: SYNC_EXT; TestPoint_Pad_1.0x1.0mm_interconnect
TP3: IMON; TestPoint_Pad_1.0x1.0mm_interconnect
TP4: FLT; TestPoint_Pad_1.0x1.0mm_interconnect
TP10: PA_OUT; TestPoint_Pad_1.0x1.0mm_interconnect
TP11, TP21: SDET_P; TestPoint_Pad_1.0x1.0mm_interconnect
TP12: TIA_REF; TestPoint_Pad_1.0x1.0mm_interconnect
TP20: SDET_N; TestPoint_Pad_1.0x1.0mm_interconnect
TP30: VCM_REF; TestPoint_Pad_1.0x1.0mm_interconnect
TP31, TP52: RSSI; TestPoint_Pad_1.0x1.0mm_interconnect
TP32: RSSI_HOLD; TestPoint_Pad_1.0x1.0mm_interconnect
TP50: 3V3; TestPoint_Pad_1.0x1.0mm_interconnect
TP51: 3V3_D; TestPoint_Pad_1.0x1.0mm_interconnect
TP53: HV_MON; TestPoint_Pad_1.0x1.0mm_interconnect
TP54, TP55: GND; TestPoint_Pad_1.0x1.0mm_interconnect
TP60: EN; TestPoint_Pad_1.0x1.0mm_interconnect
TP61: BOOT; TestPoint_Pad_1.0x1.0mm_interconnect
TP62: TXD0; TestPoint_Pad_1.0x1.0mm_interconnect
TP63: RXD0; TestPoint_Pad_1.0x1.0mm_interconnect
TP64: SDA; TestPoint_Pad_1.0x1.0mm_interconnect
TP65: SCL; TestPoint_Pad_1.0x1.0mm_interconnect
TP66: CAN_TX; TestPoint_Pad_1.0x1.0mm_interconnect
TP67: CAN_RX; TestPoint_Pad_1.0x1.0mm_interconnect
TP68: DAC_A; TestPoint_Pad_1.0x1.0mm_interconnect
TP69: DAC_D; TestPoint_Pad_1.0x1.0mm_interconnect
U1: TPS79901DDCT; SOT-23-5
U3: LT8365EMSE; Analog_MSE16-12_MSOP-16-1EP_3x4mm_P0.5mm_EP1.65x2.85mm
U4: TPS7A2033PDBV; SOT-23-5
U5: TPS259631DDAR; Texas_DDA-R-PDSO-G8_SO-PowerPAD-8_3.9x4.9mm_P1.27mm_EP2.4x3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
U6: TLV431; SOT-23
U10: OPA857; RGT0016A
U11: OPA855IDSGR; Texas_DSG0008A_WSON-8_2x2mm_P0.5mm_EP0.9x1.6mm
U20: TLV3605RVKR; Texas_RVK0012A_WQFN-12-1EP_3x3mm_P0.5mm_EP1.75x1.75mm
U30: OPA2320AIDR; SOIC-8_3.9x4.9mm_P1.27mm
U50: SN65LVDS104PW; TSSOP-16_4.4x5mm_P0.65mm
U51, U52: TPD6E05U06; Texas_R-PUSON-N14
U60: ESP32-C6-MINI-1-N4; Espressif_ESP32-C6-MINI-1
U61: USBLC6-2SC6; SOT-23-6
U62: MCP4728T-E_UN; MSOP-10_3x3mm_P0.5mm
U63: ADS1115IDGSR; MSOP-10_3x3mm_P0.5mm
U64: SN65HVD230D; SOIC-8_3.9x4.9mm_P1.27mm

Connections:
/3V3: C10.1, C11.1, C12.1, C52.1, C56.1, C57.1, C58.1, C59.1, C80.1, C81.1, C103.1, C184.1, C185.1, JP10.3 (B), R1.1, R57.1, R80.1, R81.2, R100.1, R103.2, RV1.1, TP50.1 (1_1), U1.5 (OUT), U10.9 (VS+), U10.10 (VS+), U10.11 (VS+), U10.14 (TEST_IN_VS+), U11.7 (VS+), U11.8 (PD), U20.2 (VCCI), U30.8 (V+), U50.1 (EN1), U50.2 (EN2), U50.3 (EN3), U50.4 (VCC)
/3V3_D: C30.1, C31.1, C191.2, C192.2, C194.1, C195.1, C196.2, R33.1, R39.1, R190.1, R191.1, R192.1, R195.1, R196.1, R197.1, R198.1, TP51.1 (1_1), U4.5 (OUT), U60.3 (3V3), U62.1 (VDD), U63.8 (VDD), U64.3 (VCC)
/APD_BIAS: C8.1, R19.2, R50.1
/AUX: J51.6, R186.2, R204.2
/CAN_N: J50.A10 (SSRXN2), J50.B10 (SSRXN1), J51.5, R183.2, U51.7 (D3-), U51.8 (D3-), U52.4 (D2-), U52.11 (D2-), U64.6 (CANL)
/CAN_P: J50.A11 (SSRXP2), J50.B11 (SSRXP1), J51.4, R182.1, U51.6 (D3+), U51.9 (D3+), U52.3 (D2+), U52.12 (D2+), U64.7 (CANH)
/CC1_SENSE: C182.1, R185.2, R187.1, U60.9 (GPIO4)
/CC2_SENSE: C183.1, R188.2, R189.1, U60.10 (GPIO5)
/Connector/AUX_CAB: J50.A8 (SBU1), J50.B8 (SBU2), R186.1, U52.7 (D3-), U52.8 (D3-)
/Connector/CC1: J50.A5 (CC1), R181.1, R185.1, U51.1 (D1+), U51.14 (D1+)
/Connector/CC2: J50.B5 (CC2), R184.1, R188.1, U52.6 (D3+), U52.9 (D3+)
/Connector/LVDS_DBG_N: J51.2, R177.2, U50.11 (3Z)
/Connector/LVDS_DBG_P: J51.3, R177.1, U50.12 (3Y)
/Connector/LVDS_OUT1_N: J50.B2 (SSTXP2), U50.15 (1Z), U52.2 (D1-), U52.13 (D1-)
/Connector/LVDS_OUT1_P: J50.B3 (SSTXN2), U50.16 (1Y), U52.1 (D1+), U52.14 (D1+)
/Connector/LVDS_OUT2_N: J50.A2 (SSTXP1), U50.13 (2Z), U51.4 (D2-), U51.11 (D2-)
/Connector/LVDS_OUT2_P: J50.A3 (SSTXN1), U50.14 (2Y), U51.3 (D2+), U51.12 (D2+)
/Controller/ADC_AIN0: R206.1, U63.4 (AIN0)
/Controller/ADC_AIN1: R207.1, U63.5 (AIN1)
/Controller/ADC_AIN2: R208.1, U63.6 (AIN2)
/Controller/ADC_AIN3: R209.1, U63.7 (AIN3)
/Controller/BOOT: R191.2, SW61.2, TP61.1 (1_1), U60.23 (GPIO9)
/Controller/CAN_RX: TP67.1 (1_1), U60.24 (GPIO18), U64.4 (R)
/Controller/CAN_TX: TP66.1 (1_1), U60.25 (GPIO19), U64.1 (D)
/Controller/DACO_A: R210.1, U62.6 (OUTA)
/Controller/DACO_B: R211.1, U62.7 (OUTB)
/Controller/DACO_C: R212.1, U62.8 (OUTC)
/Controller/DACO_D: R213.1, U62.9 (OUTD)
/Controller/DAC_A: C201.1, R210.2, TP68.1 (1_1)
/Controller/DAC_D: C204.1, R213.2, TP69.1 (1_1)
/Controller/DAC_RDY: R198.2, U60.28 (GPIO22), U62.5 (RDY/~BSY)
/Controller/EN: C190.1, R190.2, SW60.2, TP60.1 (1_1), U60.8 (EN)
/Controller/GPIO8: R192.2, U60.22 (GPIO8)
/Controller/LDAC: R197.2, U60.15 (GPIO6), U62.4 (~LDAC)
/Controller/LE_HYS_E: R205.2, U60.19 (GPIO14)
/Controller/RXD0: TP63.1 (1_1), U60.30 (GPIO17/U0RXD)
/Controller/SCL: R196.2, TP65.1 (1_1), U60.6 (GPIO3), U62.2 (SCL), U63.10 (SCL)
/Controller/SDA: R195.2, TP64.1 (1_1), U60.5 (GPIO2), U62.3 (SDA), U63.9 (SDA)
/Controller/STATUS: R203.1, U60.29 (GPIO23)
/Controller/TXD0: TP62.1 (1_1), U60.31 (GPIO16/U0TXD)
/Controller/USB_ESD_DN: R194.1, U61.4 (I/O2)
/Controller/USB_ESD_DP: R193.1, U61.6 (I/O1)
/Controller/USB_E_DN: C207.1, R194.2, U60.17 (GPIO12/USB_D-)
/Controller/USB_E_DP: C206.1, R193.2, U60.18 (GPIO13/USB_D+)
/DAC_HV: C203.1, R13.1, R212.2
/DAC_TH: C202.1, R85.2, R211.2
/Front End/HV_K: C50.1, D10.3 (K), R50.2
/Front End/LPF_OUT: C54.1, C55.1, R56.2, TP10.1 (1_1)
/Front End/PA_IN: C51.2, R51.1, U11.4 (IN+)
/Front End/TIA_IN: D10.1 (A), U10.15 (IN)
/HV_DIS: R34.2, U60.12 (GPIO0)
/HV_MON: C28.1, C197.1, R21.1, R32.2, R206.2, TP53.1 (1_1)
/LE_HYS: R83.2, R205.1
/LVDS_N: R180.2, U20.10 (OUT-), U50.7 (B)
/LVDS_P: R87.2, R180.1, U20.12 (OUT+), U50.6 (A)
/Monitor/RSSI_HOLD: C102.1, D30.1 (A), R103.1, TP32.1 (1_1), U30.5 (+)
/Power/5V_HVIN: C19.1, C20.1, L1.1, L2.2, R22.1, R29.2, U3.3 (VIN)
/Power/+5V: C1.1, C2.1, C9.1, C18.1, C29.1, L2.1, U1.1 (IN), U1.3 (EN), U4.1 (IN), U4.3 (EN), U5.5 (OUT)
/Power/BIAS: R28.1, R29.1, U3.7 (BIAS)
/Power/EN: Q3.3 (D), R22.2, R23.1, U3.1 (EN/UVLO), U6.2
/Power/FBX: C26.1, R8.1, R12.1, R14.2, R15.2, U3.9 (FBX)
/Power/HV_CLAMP: Q2.2 (E), R16.2, R19.1
/Power/HV_OUT: C25.1, Q1.3 (C), Q4.3, R11.2, R17.1, R20.1, R30.2
/Power/HV_PUMP: C6.2, D3.1 (K), D4.2 (A)
/Power/HV_RAW: C7.2, D4.1 (K), R30.1
/Power/HV_V1: C5.1, C7.1, D1.1 (K), R7.2
/Power/OVP_REF: R21.2, R45.1, U6.1
/Power/RT: R24.1, U3.10 (RT)
/Power/SS: C22.1, U3.11 (SS)
/Power/SYNC: R26.1, R27.1, TP2.1 (1_1), U3.12 (SYNC/MODE)
/Power/V3_FB: C12.2, R1.2, R2.1, U1.4 (FB)
/Power/VC: C24.1, R25.1, U3.8 (VC)
/RSSI: C198.1, R207.2, TP31.1 (1_1), TP52.1 (1_1), U30.6 (-), U30.7
/SDET_P: C55.2, C87.1, R59.1, TP11.1 (1_1), TP21.1 (1_1), U20.4 (IN+)
/SHDN_N: R81.1, U20.7 (SHDN), U60.13 (GPIO1)
/TIA_CTRL: JP10.2 (C), R57.2, R214.1, U10.2 (CTRL)
/TIA_TAP: D30.3 (K), R58.2
/USB_DN: J50.A7 (DN1), J50.B7 (DN2), U61.3 (I/O2)
/USB_DP: J50.A6 (DP1), J50.B6 (DP2), U61.1 (I/O1)
/VBUS: C33.1, D50.1, J50.A4 (VBUS), J50.A9 (VBUS), J50.B4 (VBUS), J50.B9 (VBUS), R35.1, U5.4 (IN), U61.5 (VBUS)
/VCM_REF: C101.1, R51.2, R59.2, R60.1, R84.2, R102.2, TP30.1 (1_1)
/VTH_MON: C199.1, R86.1, R208.2
GND: C1.2, C2.2, C5.2, C8.2, C9.2, C10.2, C11.2, C18.2, C19.2, C20.2, C21.2, C22.2, C23.2, C24.2, C25.2, C26.2, C27.2, C28.2, C29.2, C30.2, C31.2, C32.2, C33.2, C50.2, C52.2, C53.2, C54.2, C56.2, C57.2, C58.2, C59.2, C80.2, C81.2, C82.2, C83.2, C84.2, C100.2, C101.2, C102.2, C103.2, C180.2, C182.2, C183.2, C184.2, C185.2, C190.2, C191.1, C192.1, C194.2, C195.2, C196.1, C197.2, C198.2, C199.2, C200.1, C200.2, C201.2, C202.2, C203.2, C204.2, C206.2, C207.2, D2.2 (A), D10.2 (CASE), D50.2, D60.1 (K), H1.1, H2.1, H3.1, H4.1, J1.2, J50.A1 (GND), J50.A12 (GND), J50.B1 (GND), J50.B12 (GND), J50.S1 (SHIELD), J51.1, JP10.1 (A), Q3.2 (S), R2.2, R23.2, R24.2, R26.2, R27.2, R28.2, R37.2, R38.2, R45.2, R82.2, R101.2, R181.2, R184.2, R187.2, R189.2, R199.2, R209.2, RV1.3, SW60.1, SW61.1, TH1.2, TP54.1 (1_1), TP55.1 (1_1), U1.2 (GND), U3.17 (GND), U4.2 (GND), U5.1 (GND), U5.9 (EP), U6.3, U10.1 (GND), U10.3 (GND), U10.4 (GND), U10.6 (GND), U10.7 (GND), U10.12 (GND), U10.13 (TEST_SD_GND), U10.17 (PAD), U11.5 (VS-), U11.9 (EP), U20.3 (VEE), U20.5 (VEE), U20.9 (VEE), U20.11 (VEE), U20.13 (EP), U30.4 (V-), U50.5 (GND), U50.8 (EN4), U51.5 (GND), U51.10 (GND), U52.5 (GND), U52.10 (GND), U60.1 (GND), U60.2 (GND), U60.11 (GND), U60.14 (GND), U60.36 (GND), U60.37 (GND), U60.38 (GND), U60.39 (GND), U60.40 (GND), U60.41 (GND), U60.42 (GND), U60.43 (GND), U60.44 (GND), U60.45 (GND), U60.46 (GND), U60.47 (GND), U60.48 (GND), U60.49 (GND), U60.50 (GND), U60.51 (GND), U60.52 (GND), U60.53 (GND), U61.2 (GND), U62.10 (VSS), U63.1 (ADDR), U63.3 (GND), U64.2 (GND)
unnamed: C23.1, R25.2
unnamed: C27.1, R13.2, R14.1
unnamed: C53.1, R54.1, R60.2
unnamed: C87.2, R87.1
unnamed: C180.1, R182.2, R183.1
unnamed: C6.1, D1.2 (A), D2.1 (K), L1.2, U3.14 (SW2), U3.16 (SW1)
unnamed: D3.2 (A), R7.1
unnamed: D60.2 (A), R203.2
unnamed: J1.1, Q3.1 (G), R33.2, R34.1
unnamed: Q1.1 (B), Q4.2
unnamed: Q1.2 (E), Q2.1 (B), R16.1
unnamed: Q2.3 (C), Q4.1, R18.2
unnamed: R8.2, R9.1
unnamed: R9.2, R10.1
unnamed: R10.2, R11.1
unnamed: R12.2, TH1.1
unnamed: R15.1, RV1.2
unnamed: R17.2, R18.1
unnamed: R20.2, R32.1
unnamed: C21.1, U3.5 (INTVCC)
unnamed: R35.2, R36.1, U5.3 (EN/UVLO)
unnamed: R39.2, TP4.1 (1_1), U5.6 (FLT)
unnamed: R38.1, TP3.1 (1_1), U5.7 (ILM)
unnamed: R36.2, R37.1, U5.8 (OVLO)
unnamed: C32.1, U5.2 (dVdt)
unnamed: C51.1, R58.1, U10.8 (OUT)
unnamed: TP12.1 (1_1), U10.5 (OUTN)
unnamed: R53.2, U11.1 (FB)
unnamed: R53.1, R54.2, U11.3 (IN-)
unnamed: R56.1, U11.6 (OUT)
unnamed: C84.1, R84.1, R85.1, R86.2, TP20.1 (1_1), U20.6 (IN-)
unnamed: R82.1, R83.1, U20.8 (LE/HYS)
unnamed: C82.1, C83.1, R80.2, U20.1 (VCCO)
unnamed: C100.1, R100.2, R101.1, U30.3 (+)
unnamed: R102.1, U30.1, U30.2 (-)
unnamed: R204.1, U60.16 (GPIO7)
unnamed: R214.2, U60.26 (GPIO20)
unnamed: R199.1, U64.8 (RS)
