daharoni/photodiode-lvds-receiver/(commit log)

2026-10-08 Initial project scaffold, docs, KiCad 10 skeleton and link budget
    - Repo layout: docs/ (requirements, architecture, decision log, bring-up
    gates, research, datasheet archive with SHA-256 manifest, calculations),
    hardware/pcb/receiver-module/ (KiCad 10 project, root + 7 hierarchical
    sheets, empty 4-layer board, ERC/DRC clean), firmware/, tools/
    - Link-budget calculator (tools/link_budget.py) and results: a bare FDS010
    PIN is 18-23 dB optical short at 35 cm; silicon APD (Hamamatsu S12023-10)
    selected, closes the link with a ~30 mW/sr NIR emitter at M 5-10
    - APD bias: on-board LT8365 boost + charge pump chosen over HV modules
    - CLAUDE.md records analog-first rule, labeling rule, libra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
    [connector.kicad_sch, control.kicad_sch, detector.kicad_sch, frontend.kicad_sch, mcu.kicad_sch, power.kicad_sch, receiver-module.kicad_pcb, receiver-module.kicad_sch]
2026-10-08 Add LT8365 APD bias supply design and check script
    - docs/calculations/apd-bias-design.md: 5 V -> 100-220 V (140 V default)
    LT8365 boost + one charge-pump doubler, FBX divider with NTC tracking
    leg, DAC trim and bench pot, two-stage RC cathode filter, current clamp,
    BOM, safety/layout rules, G1 test plan, gaps
    - tools/apd_bias_design.py: computes duty, peak inductor current, divider,
    NTC slope, filter attenuation, fault current; 14/14 checks pass
2026-10-08 Add KiCad 10 schematic generator, Rev A sheet specs, ULX3S LVDS input check
    - tools/kicad_sch: stdlib S-expression generator for KiCad 10 sheets using
    lab-library symbols; selftest validates pin transforms and nets with kicad-cli
    - docs/schematic/rev-a-sheet-specs.md: per-sheet circuit specs for populating
    the hierarchical schematic (values cite datasheets and apd-bias-design.md)
    - docs/research/ulx3s-lvds-input.md: ECP5 LVDS input on ULX3S verified against
    FPGA-TN-02032 v1.4 and ULX3S v3.1.7; architecture item 10 moved to PROPOSED
2026-10-08 Populate Rev A schematic: all seven sheets, root integration, ERC clean
    - Power: TPS79901 3V3, LM27762 +/-3.7 V, bead-filtered 5V_A, LT8365 boost +
    doubler APD bias per docs/calculations/apd-bias-design.md (clamp, stage-1
    RC filter, FBX divider with NTC/DAC/pot legs, HV_MON divider, HV_EN header)
    - Front end: S12023-10 (FDS010 DNP fallback), stage-2 cathode filter, OPA857
    with CTRL solder jumper, AC coupling, VCA821 20 dB network, level shift
    - Slicer: TLV3605 with hysteresis/latch pin, SHDN pull-up, LVDS out
    - Control: VCM_DET/VMID/VSPAN (matched 10k 0.1%), true integrator with
    TMUX1112 HOLD_N freeze, LOS comparator (status only, decision 10),
    gain/threshold selector headers with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
    [connector.kicad_sch, control.kicad_sch, detector.kicad_sch, frontend.kicad_sch, mcu.kicad_sch, power.kicad_sch, receiver-module.kicad_sch, slicer.kicad_sch]
2026-10-08 Add ESP32-C6 module controller, CAN link, 3V3_D rail and HV disable gate (decision 11)
    - New Controller sheet replaces the MCU-hook sheet: ESP32-C6-MINI-1, USB-C
    programming (USBLC6 ESD), MCP4728 DAC (DAC_GAIN/DAC_TH/DAC_HV), ADS1115 ADC
    (HV_MON/VSPAN/VG/VMID), SN65HVD230 CAN transceiver (125 kbit/s, slope control)
    - Connector: 2x06 shrouded cable header (+5V, GND, LVDS pair, CAN pair, HOLD_N,
    AUX), Schmitt-buffered HOLD_N, DNP split termination, debug header
    - Power: TPS7A2033 3V3_D rail; LT8365 enable gated by HV_DIS (HV off until the
    ESP32 verifies the DAC); PGOOD_VGA output
    - Root regenerated with the new nets; project ERC 0 errors, 3 justified warnings
    - docs: decision-log entry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
    [connector.kicad_sch, control.kicad_sch, controller.kicad_sch, detector.kicad_sch, frontend.kicad_sch, mcu.kicad_sch, power.kicad_sch, receiver-module.kicad_sch]
2026-10-08 Decision 12: fixed-gain OPA855 post-amp and baseline slicer replace the VGA/AGC chain (docs and spec)
    - decision-log entry 12; standing corrections 1, 4, 5, 7, 8, 9 superseded
    - architecture signal chain, rails and state table rewritten; telemetry intent noted
    - rev-a-sheet-specs.md revision 2: front end, slicer, monitor, connector, controller
    - gates G1-G3 rewritten around clip/recovery, comparator small-signal and firmware range trim
    - CLAUDE.md / README updated
    Claude-Session: https://claude.ai/code/session_019maqcYLp1HqwCxM6PGpELE
2026-10-08 Rebuild sheets for decision 12: OPA855 post-amp, baseline slicer, Monitor sheet; detector/VGA/AGC removed
    Front End: APD -> OPA857 (CTRL 20k/5k via TIA_CTRL) -> AC coupling -> OPA855 x7
    referenced to VCM_REF (RF 301 from FB, RG 49.9 to PA_REF) -> 49.9/47p low-pass
    -> AC coupling to SDET_P. Slicer: TLV3605 slices SDET_P against SDET_N
    (VCM_REF + DAC_TH trim, ~3 mV hysteresis via 5.49k/100p), LVDS out.
    Monitor (control.kicad_sch): OPA2320 VCM_REF buffer and BAS70 RSSI minimum
    detector on TIA_TAP (R103 to 3V3 removes the dead zone). Power: LM27762 and
    5V_A removed. Controller: GPIO map rev 2 (TIA_CTRL, VTH_MON, AUX2). Connector:
    AUX2 on pin 11, no HOLD_N. Root: six sheets, revision-2 hierarchic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
    [connector.kicad_sch, control.kicad_sch, controller.kicad_sch, detector.kicad_sch, frontend.kicad_sch, power.kicad_sch, receiver-module.kicad_sch, slicer.kicad_sch]
2026-10-09 Add USB standalone power-path research (TPS2121 mux, buttons, VBUS sense) and ESP32-C6 TRM/HDG datasheets
    docs/research/usb-standalone-power.md: module powered from a laptop USB port alone
    (self-test, programming) or the system cable, with the cable as priority input of a
    TPS2121 priority mux and reverse blocking both ways; RESET/BOOT tactile switches,
    22R USB series resistors, VBUS_SENSE on IO4 and PWR_SRC on IO5; worst-case 5 V
    draw about 0.19 A. Ready-to-lift spec text for sections 1, 6, 7 and the root.
    Datasheets: TPS2121, LM66100 (rejected), ESP32-C6 hardware design guidelines,
    ESP32-C6 technical reference manual. .gitignore: editor .history/ folders.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
2026-10-09 Decision 13: USB standalone power and programming (spec revision 3, architecture, gates, requirements)
    TPS2121 source mux U5 on the Power sheet (cable priority, USB-C fallback,
    reverse blocking), RESET/BOOT switches, 22R D+/D- series resistors, VBUS_SENSE
    on IO4, PWR_SRC on IO5; +5V renamed +5V_CABLE on the cable side; hierarchical
    nets +5V_CABLE, VBUS, PWR_SRC. New G1/G4 bring-up items. All PROPOSED.
    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
2026-10-09 Add ESP32-C6 firmware plan, CAN/console protocol and USB tooling research (browser flashing, self-test)
    firmware/esp32/README.md: ESP-IDF v5.5.x plan, boot sequence with HV safe
    defaults (HV_DIS high first, MCP4728 EEPROM verified with the Read command,
    closed-loop HV soft start), fault policy, range-trim state machine, module
    identity from the eFuse MAC, built-in selftest, USB-only budget, ULX3S
    on-board ESP32 as a possible CAN master (PROPOSED).
    docs/firmware/can-and-console-protocol.md: 11-bit CAN ID scheme for up to 14
    modules, enumerate/assign, GET/SET, telemetry packing and bus-load arithmetic,
    esp_console command set and JSON telemetry line.
    docs/research/esp32-usb-tooling.md: USB Ser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
2026-10-09 Implement decision 13 in the schematic: TPS2121 source mux, RESET/BOOT switches, 22R USB series, VBUS_SENSE and PWR_SRC
    Power: U5 TPS2121 (IN1 +5V_CABLE priority, IN2 VBUS, OUT = internal +5V),
    PR1/OV1/OV2 dividers, ST pull-up to 3V3_D as PWR_SRC, ILM 100k, SS 220 nF,
    4.7 uF input caps. Connector: +5V renamed +5V_CABLE. Controller: VBUS as a
    hierarchical output, R193/R194 22R with DNP C206/C207, SW60 RESET on EN, SW61
    BOOT on IO9, VBUS_SENSE divider on IO4, PWR_SRC on IO5. Root: revision-3 pins,
    PWR_FLAG on +5V_CABLE. Regenerated against lab-library PR #60 (Switch category,
    TPS2121 pin-8 passive). Root ERC 0 errors, 0 warnings; 216 components, all
    with footprints.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
    [connector.kicad_sch, control.kicad_sch, controller.kicad_sch, frontend.kicad_sch, power.kicad_sch, receiver-module.kicad_sch, slicer.kicad_sch]
2026-10-09 Add ngspice simulations of the OPA855 post-amp, OPA857 TIA at 6 pF and OPA2320 VCM_REF buffer (TI models)
    docs/simulation/README.md with netlists, scripts, plots and metrics (raw data
    is regenerated by run_sim*.sh and ignored). SIMULATED, not measured:
    - OPA855 x7 with RF 301 / RG 49.9: PM about 77 deg, 0.1 dB peaking, same as the
    datasheet test values RF 453 / RG 75; 10 mV step at 20 ns edges 0.4 % overshoot.
    Large-signal clip/recovery is model-limited (model clips below datasheet VOL).
    - OPA857 at 6 pF: 20k mode 99 MHz with 1 dB peaking and 13.8 % overshoot
    (settles to 2 % in 12.6 ns); 5k mode 151 MHz, clean. At 1.5 pF the model
    matches the datasheet 105/125 MHz.
    - OPA2320 unity bu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
    [OPAx320-Q1.OLB, OPAx320-Q1_Test_Circuit.DSN, OPAx320-Q1_Test_Circuit.OPJ, dds.cfg, de_sim.cfg, opa855_pspice.dsn, opa855_pspice.opj, opa857.dsn]
2026-10-09 Decision 14 research: single 24-pin USB-C connector (cable/orientation, LVDS fan-out, foreign-host safety, power path) and draft proposal
    Three research documents plus a draft decision awaiting approval:
    - docs/research/usbc-connector-and-cable.md: Type-C R2.5 pin map, cable
    wiring (Table 3-10), four-orientation proof, cable lengths, receptacle
    and ESD candidates, breakout concept
    - docs/research/lvds-fanout-and-foreign-host.md: SN65LVDS104 fan-out,
    TLV3605 compatibility, laptop USB 3 host safety, SI and CAN stub notes
    - docs/research/usbc-power-path.md: TPS259631 eFuse vs TPS2121, CC-based
    source/orientation sensing, breakout power budget
    - docs/research/decision-14-draft-usbc-singl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
2026-10-09 Decision 14 adopted: single 24-pin USB-C connector; spec revision 4, architecture, requirements, gates, firmware docs
    Daniel approved on 2026-10-09: horizontal Wuerth 632723300011 receptacle,
    TPS259631DDAR eFuse replaces the TPS2121 mux, J51 kept as a scope header on
    the SN65LVDS104 spare output, cables <= 2 m certified passive full-featured
    (3 m only after a bench check). CAN + LVDS between FPGA and modules, USB only
    toward a computer. Host link (FX3 preferred) recorded as an open decision.
    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
2026-10-09 Implement decision 14 in the schematic: 24-pin USB-C J50, SN65LVDS104 fan-out, TPS259631 eFuse, TPD6E05U06 ESD, CC sense; ERC 0/0
    Connector sheet rewritten (Wuerth 632723300011 receptacle, U50 fan-out on
    both SS TX pairs, CAN on both SS RX pairs, SBU tie as AUX, Rd + CC taps,
    U51/U52 ESD arrays, J51 scope header on output 3). Power sheet U5 is the
    TPS259631DDAR eFuse (UVLO/OVLO divider, ILM, dVdt, FLT/IMON test points).
    Controller: J60 and the VBUS_SENSE divider removed, IO4/IO5 = CC1/CC2 sense,
    IO21 free, R199 100k. Root: VBUS Connector -> Power/Controller with PWR_FLAG,
    USB_DP/USB_DM/CC1_SENSE/CC2_SENSE/AUX wired. Netlist 220 components,
    144 nets; root ERC 0 errors / 0 warnings (kicad-cli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
    [connector.kicad_sch, control.kicad_sch, controller.kicad_sch, frontend.kicad_sch, power.kicad_sch, receiver-module.kicad_sch, slicer.kicad_sch]
2026-10-09 Add schematic overview page and exported sheet drawings (SVG, PDF) for documentation and layout
    docs/schematic/overview.html: signal-chain block diagram, sheet hierarchy and
    hierarchical nets, per-sheet drawings and part tables from the netlist,
    J50/J51 pinouts, ESP32 GPIO and I2C maps, placement/routing checklist with
    VERIFIED/PROPOSED/UNRESOLVED labels, before-ordering list. Figures exported
    with kicad-cli sch export svg -e -n (DOCTYPE stripped) and export pdf.
    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
2026-10-09 Spec: 90 ohm routing targets for the USB-C pairs and D+/D- (PROPOSED), SDET_N is not hierarchical; overview page updated
    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
2026-10-09 PCB: import the 220 footprints from the decision-14 schematic (Daniel's schematic-to-board sync, layout starting)
    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
    [receiver-module.kicad_pcb]
2026-10-09 Freeze the schematic generators (layout started 2026-10-09): gen/FROZEN marker, exit-2 guard in all seven scripts, docs updated
    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
2026-10-09 JLCPCB fabrication research: capabilities, impedance stackups, 6-layer JLC06161H-3313 recommendation, KiCad settings list; 2D impedance solver
    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
2026-10-09 PCB: JLCPCB fabrication settings. 6-layer JLC06161H-3313 stackup (ENIG), DRC constraints, net classes (HV, HV_LADDER, DIFF90, USB90, CAN90, DIFF100), custom DRC rules, Gerber plot params
    Differential geometries are computed PROPOSED values (docs/pcb/jlcpcb-fab-settings.md)
    to be confirmed with the JLCPCB calculator at order time. DRC loads clean apart from
    the J50 Wuerth receptacle THT holes (annular 0.125 mm, hole-to-hole 0.40 mm), open item.
    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
    [receiver-module.kicad_pcb]
2026-10-09 J50 receptacle DFM note: Wuerth 632723300011 B-row holes vs JLCPCB minima, options and recommendation (PROPOSED)
    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
2026-10-09 Add J50 DFM test board (Wuerth receptacle as drawn and with 0.70 mm B-row pads) with Gerber/drill zip for a JLCPCB DFM check
    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
    [j50-dfm-test.kicad_pcb]
2026-10-09 J50 hole waiver (JLCPCB Advanced PCB tier): DRC rules for J50 only, ordering tier recorded in README, fab docs and G4
    JLCPCB's DFM accepted the Wuerth 632723300011 footprint as drawn under the
    Advanced PCB option (Daniel, 2026-10-09, test board hardware/pcb/j50-dfm-test).
    DRC on the receiver board after the waiver: no hole or clearance violations.
    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
2026-10-09 Record the exact JLCPCB quote option that accepts the J50 holes: min via 0.25 mm/(0.35/0.4 mm), auto-selects 4-wire Kelvin test and FR4 Tg155
    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
2026-10-09 PCB: predefined track widths, via sizes and differential-pair sizes for the JLC06161H-3313 board
    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
2026-10-09 PCB: functional groups (6 sheet groups, 30 block sub-groups) and clustered starting placement with block labels; tools/pcb_group_blocks.py
    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
    [receiver-module.kicad_pcb]
2026-10-09 Add PCB placement plan page: top/bottom floor plans by block group, mounting holes, zone table, placing rules (PROPOSED)
    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
2026-10-09 Schematic: add mounting holes H1-H4 (M2 plated pad+via, GND) on the Connector sheet by hand edit; ERC 0/0, 224 components
    Needs lab-library PR #62 and "Update PCB from Schematic" to bring H1-H4 onto the board.
    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
    [connector.kicad_sch]
2026-10-09 PCB: first-pass placement of all 224 footprints by tools/pcb_place.py from placement/placement-spec.json (72 x 46 mm placeholder outline, HV island on the back edge, ESP32 antenna keep-out); 0 courty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
    [receiver-module.kicad_pcb]
2026-10-09 PCB: first-pass placement re-run on a 75 x 50 mm outline (Daniel's choice); right-edge and front-edge anchors shifted with the outline; 224 placed, 0 courtyard overlaps
    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
    [receiver-module.kicad_pcb]
2026-10-09 Drop D11 (FDS010 bench fallback) from Rev A: hand-edited Front End sheet, footprint removed from the board, docs/spec/placement tables updated; ERC 0/0, 223 components
    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
    [frontend.kicad_sch, receiver-module.kicad_pcb]
2026-10-10 Connector: split the TPD6E05U06 ESD channels by position along J50 (U51 = A2/A3, B11/B10, CC1; U52 = B2/B3, A11/A10, CC2, AUX) so every clamped line is flow-through; hand edit, ERC 0/0, nets unchanged
    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
    [connector.kicad_sch]
2026-10-10 Connector: U51 ESD pairs swapped (CAN on D1, TX1 on D2) so the pin order matches J50 with the I/O side facing the receptacle; ERC 0/0, nets unchanged
    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
    [connector.kicad_sch]
2026-10-10 Connector: ESD channel order now follows the J50 pad rows (U51: CC1, spare, TX1 N/P, CAN L/H; U52: TX2 P/N, CAN H/L, CC2, AUX) so A-row pads get level, uncrossed top-layer traces; hand edit, ERC 0/0,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
    [connector.kicad_sch]
2026-10-10 Connector: U50 output 1 now drives J50 B2/B3 and output 2 drives A2/A3 so the two LVDS pairs run to their ESD clamps without crossing; hand edit, ERC 0/0, polarity unchanged
    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
    [connector.kicad_sch]
2026-10-10 Connector: LVDS polarity flipped at J50 on both pairs (N to SSTXp, P to SSTXn; Daniel) so the lower pair routes uncrossed on top and the upper pair swaps where it already changes layer; clamp pins fo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
    [connector.kicad_sch]
2026-10-10 Controller: swap CAN_TX/CAN_RX on the ESP32 (TX now IO19 pin 25, RX IO18 pin 24) for layout; TWAI signals go through the GPIO matrix; hand edit, ERC 0/0; firmware and protocol docs updated
    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
    [controller.kicad_sch]
2026-10-12 Docs: sync with the layout-phase design (decisions 12-14, hand edits, placement)
    README status and connector description (one 24-pin USB-C, six sheets, 223
    parts, 6-layer board placed but not routed, frozen generators); architecture
    risk list, APD bias row, controller I/O and polarity note, new layout-status
    section; requirements detector/bias rows and open items 6 and 11; gates G1
    wording without the VGA; CLAUDE.md gate summaries and repo map; spec and
    connector.md polarity rule after the J50 flip, stackup chosen, eFuse footprint
    resolved; overview.html J50 pinout, ESD channels, GPIO 18/19, part counts
    (D11 gone, H1-H4 added), stackup and net classes; placement plan drops D11;
    firmware READ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
2026-10-12 Controller: sheet text note updated for the CAN_TX/CAN_RX swap (IO19/IO18); text only, ERC 0/0
    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
    [controller.kicad_sch]
2026-10-12 Add docs/receiver-guide.html: field guide derived from the current design (Rev A, spec revision 4, decisions 1-15)
    Self-contained offline page (inline CSS/SVG, light and dark, print) built from
    requirements, decision log, architecture, gates, the sheet as-built notes and the
    board README: signal chain with block diagram, power and APD bias, USB-C connector
    and fan-out with the flipped J50 polarity, controller and firmware, FPGA side,
    layout and fab, simulations, gates, open risks, decisions and sources. Labels are
    copied from the sources (VERIFIED / PROPOSED / SIMULATED / UNRESOLVED), nothing
    measured. Supersedes the historical Rev A.1 FDS010/VCA821/AGC guide in the
    untracked initial plannin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
2026-10-12 PCB: hand placement pass (Daniel): 209 of 223 footprints moved, none flipped or added; nothing routed yet
    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
    [receiver-module.kicad_pcb]
2026-10-12 ESP32-C6 firmware: ESP-IDF 5.5 project skeleton (boot sequence, HV safety gate, params/NVS, USB console, telemetry, MCP4728/ADS1115 drivers, sense, TWAI CAN link, range-trim FSM, self-test) with host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
    Builds clean with ESP-IDF v5.5.5 for esp32c6 (app 0x4fc50 bytes); 30 host tests pass (CAN codec, range FSM, M estimator). PROPOSED throughout; nothing run on hardware. Protocol doc gains fault bit 14 (NVS) and parameter hv_auto (0x0062) to match the code.
    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
    [partitions.csv]
2026-10-12 Firmware CI: build + host tests on GitHub, optional HIL job on the lab bench (gated by HIL_ESP32C6_BENCH, never for fork PRs); HIL.md bench plan for the module
    Pairs with Aharoni-Lab/hil-bench-controller PR #5 (esptool probe, esp32c6_receiver target).
    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
2026-10-12 Firmware: browser flash-and-verify page (ESP Web Tools manifest, Web Serial console, self-test and telemetry panels); CI assembles build/web with the merged image
    Untested in a browser and on hardware; serial picker filtered to the Espressif VID.
    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
2026-10-12 ESP32-C6 firmware: fix review findings 1-8 (tick rate 1000 Hz, HV gate as a pure host-tested state machine that arms through DAC 0xFFF readback before HV_DIS goes low, guarded dac_hv, open-loop code 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
    Build clean with ESP-IDF v5.5.5 (app 0x50f30 bytes); host tests 4/4 suites pass (hv_gate 18 tests). Nothing run on hardware.
    Claude-Session: https://claude.ai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
    [app_main.c, app_range.c, app_range.h, app_safety.c, app_safety.h, app_selftest.c, app_telemetry.c, app_telemetry.h]
2026-10-12 Firmware CI: assemble the web flasher in web-dist/ (the container build dir is root-owned), include the vendored bundle, upload it as its own artifact
    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
2026-10-12 ECP5 gateware stage 1: spec, 8b/10b codec + model, CRC, PRBS, UART, PLL and LVDS capture, ULX3S top that builds and passes timing, cocotb tests, CI
    firmware/ecp5/README.md is the gateware specification (line protocol PROPOSED, ULX3S pin facts
    cited to ulx3s_v20.lpf and the ECP5 data sheet, 7 header pairs free of other loads). Open-source
    flow via the YosysHQ OSS CAD Suite (tools/fpga-env.sh). make bit DEVICE=85k passes timing
    (clk_s 954 MHz vs 200, clk_c 177 MHz vs 100) and nextpnr writes INPUT_LVDS + DIFFRESISTOR 100
    for all 7 lane pads. 20 cocotb tests pass in 5 directories (encoder, decoder, CRC, PRBS, UART).
    The 8b/10b tables were cross-checked against independently recalled clause 36 en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
2026-10-12 ECP5 gateware stage 2: oversampling CDR (second-order DPLL), comma alignment, lane monitor, independent-clock watchdog, frame parser with CRC, sequence-number lane merge, host sink UART, test-pattern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
    All blocks are pure Verilog-2005 with cocotb tests whose expectations come from the Python
    golden model (model/link8b10b.py, model/linesim.py). CDR: zero bit errors over 1e5 bits at
    +/-500 ppm and 0.3 UI jitter after a ~1000-bit lock-in; reacquires after a 10 us gap.
    Every test directory was rerun by the orchestrator. Nothing integrated into the top yet;
    nothing has run on an FPGA.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
    [cdr_oversample.v, comma_align.v, crc8.v, frame_rx.v, frame_tx.v, host_sink_uart.v, lane_merge.v, lane_monitor.v]
2026-10-12 ECP5 gateware stage 3: lane wrapper, receiver_core integration, ULX3S top with internal loopback and host/status mux, end-to-end system test; core clock 50 MHz (one word per UI), CDR pipelined withou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
    The first integration ran the core at 100 MHz and reached 38 MHz (CDR multiplier comparators and
    the merge arbiter). The core now runs at 50 MHz with one 4-sample word per cycle: clk_c 73.5 MHz
    (85k) / 74.1 MHz (12k) against 50 required, clk_s 776/682 MHz against 200, 0 MULT18X18D, 8 DP16KD.
    239 cocotb tests in 17 directories pass, including tb/system (3 lanes through the jittered line
    model with +/-300 ppm and 2000 UI skew, dead-lane LOS a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
    [cdr_oversample.v, clocks.v, frame_tx.v, host_sink_uart.v, lane_merge.v, lane_monitor.v, lane_phy.v, lane_phy_tb.v]
2026-10-13 ECP5 gateware stage 4: independent review fixes (lane polarity auto-detect, frame failures in the error class, merge resync after 32 duplicates, half-cycle stage in the 200->50 MHz handoff, byte-boun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
    Review found no hang or data corruption in the core; its two hardware-boundary findings are fixed:
    an inverted lane decoded as valid 8b/10b (complement symmetry) and looked healthy while every frame
    failed CRC; the merge could not recover from a transmitter sequence reset while seq_next was in
    1..32768. 257 cocotb tests pass (36 skipped by design); timing met on 85k (clk_c 65.9 MHz v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
    [dec_8b10b.v, host_sink_uart.v, lane_merge.v, lane_monitor.v, lane_phy.v, lane_rx.v, receiver_core.v, status_uart.v]
2026-10-13 PCB layout WIP: hand placement pass (fast chain, HV island, bottom side), LT8365 hot loop tightened; nothing routed
    Snapshot before the HV island rearrangement (U3 flipped, switching cell on the back edge, FBX network at pin 9).
    [receiver-module.kicad_pcb]
2026-10-13 PCB layout: rearrange the LT8365 HV island (U3 flipped, switching cell on the back edge, FBX network at pin 9, ladder beside it, HV_OUT lane along the back edge), NTC moved to the APD, HV gate group 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
    [receiver-module.kicad_pcb]
2026-10-13 PCB layout WIP: second hand placement pass (Daniel): LT8365 cell rebuilt with D2 on the SW node, FBX/DAC/pot legs regrouped under U3, LDOs U1/U4 moved beside the eFuse, J51 debug header and RESET/BOO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
    [receiver-module.kicad_pcb]
2026-10-14 PCB: add the LT8365 SW node and D1 cathode net to the HV netclass (they were on Default 0.15 mm); move C22/R24 0.3 mm to clear the SW pads under the 1.25 mm HV pad rule; hysteresis network, Q3/J1 gro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
    [receiver-module.kicad_pcb]
2026-10-14 PCB: hysteresis R87/C83 swap, ESP32 6 mm left with ADC cluster, debug header J51 on the front edge, CC network relocated; GND pours on F/In1/In3/In4/B, first-pass 3V3/3V3_D/+5V pours on In3, antenna 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
    [receiver-module.kicad_pcb]
2026-10-14 PCB: move all reference designators from silkscreen to the Fab layers, centred on each courtyard (assembly drawing); silk keeps footprint graphics only
    [receiver-module.kicad_pcb]
2026-10-15 PCB routing WIP (Daniel): first routing pass, 93 nets / 557 mm / 100 vias; analog chain, GND stubs, 3V3/3V3_D/+5V as outer-layer tracks, LVDS pairs started; 131 unconnected; shield RC, TP64/TP65, CC 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
    [receiver-module.kicad_pcb]
2026-10-15 DRC rules: add 'hv escape inside own courtyard' so tracks can leave HV-footprint pads (U3, D1-D4, D10, Q1, Q2, R7/R11/R16-R18/R20) whose neighbouring pins sit inside the 1.0/1.25 mm HV clearance; ver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
2026-10-15 PCB: reshape the In3 rail pours against the placed pads: +5V pour now covers the U1 input and the eFuse/U4-input block (not the U4 3V3_D output), 3V3/3V3_D boundary moved to x 49 so the DAC cluster s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
    [receiver-module.kicad_pcb]
2026-10-16 Schematic/PCB WIP (Daniel, KiCad GUI): J51 debug pair flipped (LVDS_DBG_N on pin 2, LVDS_DBG_P on pin 3), routing progress, KiCad 10 re-save of all sheets
    [connector.kicad_sch, control.kicad_sch, controller.kicad_sch, frontend.kicad_sch, power.kicad_sch, receiver-module.kicad_pcb, receiver-module.kicad_sch, slicer.kicad_sch]
2026-10-16 Schematic/PCB: TPD6E05U06 NC pads stacked on the I/O pins for straight-through routing; CAN_H/CAN_L -> CAN_P/CAN_N and USB_DM -> USB_DN so KiCad pairs them; sheet notes corrected
    - U51/U52: pins 1-4, 6, 7 (datasheet NC, SLVSBO7O Table 4-3 p.5: 'used for optional straight-through routing') are now hidden passive pins stacked on 14-11, 9, 8 in the lab-library symbol (branch tpd6e05u06-straight-through-pins, PR pending) and in the embedded copy; PCB pads given the partner nets. The protected trace enters the clamp pad and leaves under the body through the opposite pad. 12 new unconnected pad links until routed.
    - Net renames only; no electrical change. Netclass patterns in the .kicad_pro update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
    [connector.kicad_sch, controller.kicad_sch, receiver-module.kicad_pcb, receiver-module.kicad_sch]
2026-10-16 Docs: record the J51 debug pair flip, the CAN_P/CAN_N and USB_DN net renames, and the TPD6E05U06 straight-through pin stacking in the authority docs, guide, overview, fab settings and PCB README
2026-10-22 Schematic/PCB WIP (Daniel, KiCad GUI): U51 CAN clamp channels swapped (CAN_P on pins 9/6, CAN_N on pins 8/7) for routing; routing progress
    [connector.kicad_sch, receiver-module.kicad_pcb]
2026-10-22 Schematic/PCB: tie the J50 shell directly to GND (C181/R170 removed, decision 16); document the U51 CAN clamp swap
    - Connector sheet: C181 1 nF and R170 1 M (DNP) deleted with their wires, the SHIELD label and the spare GND label; J50 S1 wired straight to GND. Sheet notes updated, including U51 pins 9/8 = CAN_P/CAN_N (B11/B10).
    - PCB: C181/R170 footprints and their stub tracks removed; the eight J50 S1 pads are on GND. Zones not refilled in the file (refill on a copy: 0 unconnected S1 items).
    - placement-spec.json and pcb_group_blocks.py no longer reference C181/R170.
    - Docs: decision-log entry 16, connector.md revision note, sheet spec, overview, receiver guide, READMEs, architecture, CLAUD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
    [connector.kicad_sch, receiver-module.kicad_pcb]
2026-10-22 PCB WIP (Daniel, KiCad GUI): R193/R194 and C206/C207 moved from U61 to the ESP32 USB pins; routing progress
    [receiver-module.kicad_pcb]
2026-10-22 Schematic/PCB: name the USB D+/D- segments so KiCad pairs them (USB_ESD_DP/DN, USB_E_DP/DN) and put them in USB90
    - U61 -> R193/R194 (was Net-(R193-Pad1)/Net-(R194-Pad1)) is now USB_ESD_DP/USB_ESD_DN; R193/R194 -> ESP32 (was USB_DP_E/USB_DN_E) is now USB_E_DP/USB_E_DN, so both end in P/N for the diff-pair router.
    - USB90 netclass patterns extended to the four new names (.kicad_pro).
    - placement-spec near rules for R193/R194 now point at U60 pads 18/17, matching Daniel's move.
    - Docs: controller.md, sheet spec, fab settings, PCB README, receiver guide; Controller SVG and schematic PDF regenerated.
    - kicad-cli: ERC 0 violations; netlist diff is the renames only. DRC: skew_out_of_range 8 -> 12,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
    [controller.kicad_sch, receiver-module.kicad_pcb]
2026-10-22 DRC rules: check pair skew within each diff pair (within_diff_pairs), not across all DIFF90/CAN90/USB90/DIFF100 nets
    Without the option KiCad compared every matched net with the longest one in the four classes (e.g. USB pads against /CAN_P at 46.8 mm). kicad-cli DRC: skew_out_of_range 12 -> 2; the two left are real intra-pair mismatches (LVDS_OUT1_P/N 1.2 mm, LVDS_P/N 4.1 mm, both still being routed). Doc copy of the rule in jlcpcb-fab-settings.md updated.
2026-10-22 DRC rules: drop the 0.3 mm pair keepout for USB90 (USB full speed); it now uses the 0.15 mm netclass clearance
    The USB_ESD_DP/DN and USB_E_DP/DN renames put the USB pairs under the name-paired keepout as well, which blocked the U61 GND pin. DIFF90, CAN90 and DIFF100 keep 0.3 mm. kicad-cli DRC on the current board: counts unchanged, rules parse.
2026-10-22 PCB WIP (Daniel, KiCad GUI): routing progress
    [receiver-module.kicad_pcb]
2026-10-22 PCB: one via size everywhere, 0.45 mm pad / 0.25 mm drill (Daniel); netclass defaults and a via-only annular rule to match
    - All 209 board vias resized (162 at 0.6/0.3 and 2 GND at 0.8/0.4 at (64.475, 60.425/61.925); 41 were already 0.45/0.25). No HV-class net has a via.
    - .kicad_pro: via 0.45/0.25 in all seven netclasses.
    - .kicad_dru: rule "via annular" (vias only, 0.10 mm); the 0.15 mm Board Setup minimum stays for PTH pads. JLCPCB multilayer via rule pad >= drill + 0.1 (0.15 preferred); 0.25 drill at >= 0.45 pad is standard price (capabilities page, read 2026-10-22).
    - kicad-cli DRC: annular_width 41 -> 0; diff_pair_gap_out_of_range 35 -> 36 (one more uncoupled USB_DP/USB_DN segment pair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
    [receiver-module.kicad_pcb]
2026-10-22 DRC rules: relax diff-pair gap at pin fan-outs and for the slow CAN/USB pairs
    - "slow pair gap": CAN90 and USB90 keep the 0.15 mm router target but have no maximum gap (125 kbit/s CAN, 12 Mbps USB).
    - "pair gap at pins": DIFF90/DIFF100 tracks touching the courtyard of J50, U50, U51, U52 or U20 may open to 1.2 mm (pad pitch at the connector rows, TPD6E05U06 straight-through, SN65LVDS104 TSSOP, TLV3605 outputs). R180 deliberately not exempt.
    - kicad-cli DRC: diff_pair_gap_out_of_range 36 -> 2, diff_pair_uncoupled_length_too_long 2 -> 1. All left are on LVDS_P/N between U20 and U50: a 2.9 mm run at 0.24 mm gap, the jog to R180's pads, and 11.7 mm uncoupled (limit 5 mm). The CAN 18 mm uncoupled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
2026-10-22 DRC rules: intra-pair skew 2.5 mm on DIFF90 only; CAN/USB dropped, LVDS_P/N excluded
    1 mm was about 6 ps against a 20 ns UI. CAN90/USB90 are slow (125 kbit/s, 12 Mbps). LVDS_P/N (DIFF100) is excluded because KiCad counts the ~4.3 mm hysteresis tap to R87 in LVDS_P's length; its through-path skew is about 0.2 mm (from the track geometry), check by eye. No inter-pair matching. kicad-cli DRC: skew_out_of_range 4 -> 0, nothing else changed. Docs (fab settings, sheet spec, overview, guide) updated.
2026-10-22 Docs: Rev A design review 2026-10-22 (six subagent reports, consolidated findings, DRC report)
    One BLOCKER: the S12023-10 lab-library symbol maps pin 1 to the cathode while the
    Hamamatsu outline KAPDA0136EC makes pin 1 the anode, so D10 is forward-biased by
    the HV rail as wired. Major items on the LT8365 R7 branch, the DAC-only bias
    range, MCP4728 power-up defaults, HV resistor ratings, OPA855 plane window, APD
    pad geometry, via-in-pad fill, J50 shell vias, and the link budget.
2026-10-22 Schematic/PCB: S12023-10 APD pinout corrected (pin 1 = anode, pin 3 = cathode), D10 rotated 180 degrees; decision 17, standing correction 15
    The lab-library symbol had pin 1 = K and pin 3 = A. Hamamatsu KAPD1007E19 p.4 outline
    KAPDA0136EC (pin diagram, bottom view, confirmed by Daniel) draws the diode between
    terminals 3 and 1 with the bar on the 3 side, so pin 1 is the anode. As wired, HV_K sat
    on the physical anode and the APD would have conducted forward into the OPA857 input.
    - frontend.kicad_sch: embedded S12023-10 symbol K/A pin numbers swapped, Source text fixed
    (same edit as lab-library branch fix-s12023-pinout, commit 1cfe5d7)
    - receiver-module.kicad_pcb: D10 rotated 180 degrees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
    [frontend.kicad_sch, receiver-module.kicad_pcb]
2026-10-22 Schematic WIP (Daniel, KiCad GUI): symbols updated from lab library (TPD6E05U06 native pin stacks, PR #63), re-save reordering
    Netlist unchanged apart from the U51 unconnected-pin names.
    [connector.kicad_sch, control.kicad_sch, controller.kicad_sch, frontend.kicad_sch, power.kicad_sch, receiver-module.kicad_pcb, slicer.kicad_sch]
2026-10-22 Schematic: R7 20R moved into the pump-charge branch (HV_V1 to D3 anode), decision 18; board update pending
    Design review S1: LT8365 Rev. A p.30 (R8) and the DC2838A REV02 schematic (R10)
    put the 20 ohm between the stage-1 capacitor node and the pump diode anode, with
    D1 straight from SW to V1. Rev A had R7 in series with D1 (full inductor peak
    current, about 6-7 V lost on the 150 V SW pin, pump recharge undamped).
    Power sheet: D1 K now on HV_V1; R7 pin 2 HV_V1, pin 1 = D3 anode (Net-(D3-A));
    D3 shifted left, R7 placed between D3 and the HV_V1 junction. Netlist diff vs
    HEAD is exactly D1:1, D3:2, R7:1. ERC 0/0. Netclass pattern Net-(D1-K) replaced
    by Net-(D3-A) in the HV class (.kicad_pro).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
    [power.kicad_sch]
2026-10-22 PCB WIP (Daniel, KiCad GUI): S1 R7 re-placement and routing, Update PCB from Schematic
    R7 vertical at (56.83, 5.83) between the HV_V1 row and D3; D1 K to HV_V1; C5 and C7 moved.
    Side effect to undo in the next commit: the 27 test points came in as the plated-hole
    footprint (schematic Footprint fields were reset by today's symbol update).
    [receiver-module.kicad_pcb]
2026-10-22 Schematic/PCB: test points back on the SMD pad footprint (symbol update had reset the Footprint fields); docs for the S1 board update
    Today's Update Symbols from Library reset the 27 TP instances' Footprint field
    to the library default TestPoint_Plated_Hole_D1.0mm_interconnect, and Update PCB
    from Schematic then replaced the SMD test points with 1.0 mm plated holes
    (0.5 mm drill), which looked like oversized vias and added 85 DRC items.
    Fix: the 27 instance fields are back on TestPoint_Pad_1.0x1.0mm_interconnect
    (the embedded lib_symbols copies keep the library's plated-hole default, as
    before); the 27 board footprints were transplanted from the pre-update board
    (same positions, layers and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
    [connector.kicad_sch, control.kicad_sch, controller.kicad_sch, frontend.kicad_sch, power.kicad_sch, receiver-module.kicad_pcb, slicer.kicad_sch]
2026-10-22 PCB WIP (Daniel, KiCad GUI): HV pad clearance fixes around C5/C7/D3/R7, D2 moved off the HV_OUT lane
    [receiver-module.kicad_pcb]
2026-10-22 Schematic: R14 442k -> 150k so the DAC alone spans 50-219 V (review S2, decision 19); R15 DNP 274k -> 1M; bias script models the pot-DNP build
    RV1/R15 are DNP in production, so the documented 104-215 V range (pot leg at
    mid) was never what a built board does: with Rd = 452 k the DAC alone gave
    106.6-166.5 V at 25 C and a 200 V VBR unit could not be biased.
    The tempco of the FBX divider depends only on the bottom leg (Rb = R12 + NTC),
    so lowering the DAC leg alone widens the span: Rd = 160 k gives code 0 =
    219.4 V, mid = 134.9 V, full scale = 50.3 V (firmware floor stays 100 V),
    LSB 41 mV, slope still 0.642 V/C. R12 and TH1 unchanged. R15 goes to 1 M so a
    bench-fitted pot adds only +/-13.5 V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
    [power.kicad_sch, receiver-module.kicad_pcb]
2026-10-22 Docs/firmware spec: blank-DAC state closed by the HV_DIS interlock and firmware self-provisioning (review S3, decision 20); firmware numbers updated for decision 19
    Daniel's call: HV cannot turn on without the ESP32, so no hardware change and
    no EEPROM programming step outside the board. Firmware README: boot step 4
    provisions the MCP4728 EEPROM itself when it reads blank or wrong; J1 only
    after the first boot; brownout level >= 2.3 V (above the DAC's 2.2 V max POR);
    POR bit while HV on raises HV_DIS. Stale decision-19 numbers fixed in the soft
    start and self-test text (0xFFF = about 50 V, 41.3 mV per code, slope window
    40-65 V/V, floor window 40-60 V). Protocol doc, gates.md G1 item, contro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
2026-10-22 Docs: hard rule 1 reworded, the signal path is firmware-free and the bias enable is the ESP32 interlock (review S4, decision 21)
    An unprogrammed module keeps 20k, comparator on and the LVDS path alive, but
    has no APD bias (R33/Q3 hold the LT8365 off until firmware drives HV_DIS low),
    so it is safe but dark. CLAUDE.md hard rule 1, decision 12 "Kept" line,
    architecture.md (three sentences, including the stale "resistor-set bias" in
    the power-up row), guide callout and section 5.3, controller.md, firmware
    README, decision log 21, guide decision row 21, review README S4 status.
    No hardware change.
2026-10-22 Docs: sheet spec note on the unprogrammed case marked superseded by decision 21
2026-10-22 Docs: R17/R18/R20/R32 to 0805 for the 150 V rating (review S5a, decision 22); Yageo RC0805 spec filed; clamp base-starvation left open with a G1 sweep
    Yageo RC0805 specification V0 (2016-07-26) p.3: 150 V maximum working, 300 V
    overload (docs/datasheets/yageo-rc0805.pdf, manifest row with SHA-256). The
    four 4.99 M parts hold 110 V each at 220 V. Footprint change in the schematic
    and re-placement on the board are Daniel's, in the GUI. S5b (Ic x 10 M / hFE
    drop at the APD side) stays open; MOSFET pass device proposed; calc doc test
    plan gains item 3b. power.md, calc doc BOM and gaps, guide (clamp, HV_MON,
    decision row 22), review README S5 status, decision log 22.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
2026-10-22 Docs: decision 22 entry and the G1 clamp-drop sweep (left out of 6b119dd by a script abort)
2026-10-23 PCB WIP (Daniel, KiCad GUI): save before the S5 footprint change
    [receiver-module.kicad_pcb]
2026-10-23 Schematic/PCB: R17, R18, R20, R32 to 0805 (150 V working rating, decision 22); C28, R20, R32 nudged to clear courtyards
    Schematic: Footprint field R_0805_2012Metric_N and value "4.99M 1% 0805 150V"
    on the four symbols. Board (script, KiCad closed): footprints substituted in
    place with position, rotation, fields, path and pad nets carried over; the
    existing track ends lie inside the larger pads. C28 0.3 mm left with its
    HV_MON via and three track ends, R20 0.2 mm right, R32 0.25 mm up. Zones
    refilled. ERC 0/0, DRC 52 (unchanged), 0 unconnected, parity clean. PCB README
    as-built note, review README S5a status, guide decision row, Power figure.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
    [power.kicad_sch, receiver-module.kicad_pcb]
2026-10-23 Schematic/PCB: HV over-voltage limiter, TLV431A on the HV_MON tap pulling LT8365 EN low at about 228 V (review S6, decision 23)
    Power sheet: R21 100k -> 45.3k + new R45 54.9k (tap OVP_REF = 0.548 x HV_MON),
    U6 TLV431 (REF on the tap, cathode on EN, anode GND), R22/R23 200k -> 20k so
    the EN node sources the 80 uA minimum cathode current. Trip at HV_MON = 2.263 V
    = HV_OUT about 228 V, below the LT8365 1.545 V minimum falling EN threshold;
    the converter stops and sawtooths at the trip level instead of running the
    150 V diodes into avalanche about 3 ms after an open FBX ladder resistor.
    Symbol AharoniLab_Power:TLV431 from lab-library branch add-tlv431 (embedded
    copy identical).
    Board (script, K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
    [power.kicad_sch, receiver-module.kicad_pcb]
2026-10-23 PCB WIP (KiCad re-save)
    [receiver-module.kicad_pcb]
2026-10-23 Schematic/PCB: clamp pass transistor made a Darlington, Q4 MMBTA42 drives Q1's base (review S5b, decision 24)
    The single MMBTA42 dropped Ic x 10 M / hFE at the APD side (about 3 V per
    10 uA at hFE 30), invisible to HV_MON. Q4 as an emitter follower divides that
    by a second hFE: about 0.7 V at 60 uA plus a fixed 2 x Vbe. Daniel chose this
    over a MOSFET follower for Rev A; the MOSFET stays the Rev B option.
    Power sheet: Q4 in Q1's old place, Q1 moved right; R18/Q2 collector now drive
    Q4's base (Net-(Q2-C), added to the HV netclass patterns), Q4 emitter to Q1
    base (Net-(Q1-B)), both collectors on HV_OUT. Board (script, KiCad closed): Q4
    SOT-23 at (23.60, 6.73) right of Q1; HV_OUT extended thro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
    [power.kicad_sch, receiver-module.kicad_pcb]
2026-10-23 PCB/docs: D10 pads 1.2 -> 1.0 mm, HV pad-spacing waiver recorded (review P1, decision 25)
    The S12023 TO-18 leads sit on a 2.54 mm circle, so the 220 V cathode pad
    cannot reach the project's 1.5 mm / IPC 1.25 mm uncoated spacing from the
    case (GND) pad, and the "hv same footprint pads" DRC exception hid it.
    Lab-library PR #65 shrinks the pads to 1.0 mm on the 0.7 mm drill (annular
    0.15 mm); the board copy of the footprint gets the same sizes and text.
    Measured gaps from the cathode pad (pcbnew shape distances): case pad
    0.80 mm (was 0.60), anode pad 1.54 mm (was 1.34), zones 1.00 mm on all
    layers. Both exceed the 0.4 mm coated figure, so the assembly rule is clean
    and conformal-coat the solde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
    [receiver-module.kicad_pcb]
2026-10-23 PCB/docs: C50 at the cathode, HV_K radial exit, D10 on a 1.5 mm spacer (review P2, decision 26)
    C50 was 6.78 mm of trace from the APD cathode pad (calc rule 6 asked for
    3 mm) and the HV_K diagonal put 1.65 mm of 220 V copper under the grounded
    can flange. C8, R50 and C50 now stand in a column at x 4.60 left of D10:
    C50's HV_K pad is 4.43 mm from the cathode pad (4.59 mm of trace) with two
    GND vias in its ground pad, HV_K leaves the pad radially (0.93 mm under the
    flange plus the pad, the minimum the lead circle allows), APD_BIAS re-routed
    into C8, old stubs and vias removed. Rule 6 amended: a 1210 cannot get
    inside the 3.45 mm courtyard radius. KAPD1007E19 p.4 shows no standoff, so
    D10 gets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
    [receiver-module.kicad_pcb]
2026-10-23 PCB/schematic/docs: OPA855 cell re-laid out, plane windows, TP10 on LPF_OUT; parasitic sim (review P3, decision 27)
    Review P3 asked for a plane window under the OPA855 signal pins, the
    feedback parts closer to the pins and TP10 off the output node. Sim first
    (docs/simulation, new section): 0.5 pF on IN- and OUT costs 1.7 degrees of
    phase margin, 1.0 pF 3.4 degrees, with 1 GHz peaking the 68 MHz low-pass
    hides; the review's 10 to 15 degree estimate is not reproduced, so this is
    hygiene. Layout (script, KiCad closed): U11 rotated 270 degrees so pins
    1-4 face R53/R54 (FB 1.38 mm, IN- node 3.15 mm, was 2.5 / 4.97), R56, C54,
    C52 moved to the output side with GND and 3V3 vias, GND via at pin 5, t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
    [frontend.kicad_sch, receiver-module.kicad_pcb]
2026-10-23 Link budget revised for review A1/A2 (analysis only, authority docs unchanged pending Daniel)
    Independent redo of the emitter and APD budget: the old "30 mW/sr from
    25 mW average" implied 229 % wall-plug efficiency, the noise bandwidth is
    the built 70 MHz not 35 MHz, the Q-optimal M is 83 to 112 (capped at the
    datasheet 100), and the range figures were electrical dB. tools/link_budget.py
    now costs emitters from flux and WPE, defaults to 70 MHz, uses the 6 pF noise
    curve and has an --apd-budget mode; its output is pasted verbatim into
    docs/calculations/link-budget.md, section "Revision 2026-10-22", old
    sections kept for comparison. Headline: Q = 6 at 35 cm needs 11 to 12 mW/sr
    (72 to 194 mW a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
2026-10-23 PCB/docs: ground-return vias at C5, U3 EP, J50 shell posts, U50/C56/C57 (review P5/P7/P8, decision 28, partial)
    Checked placer (every candidate tested against all copper and holes on
    all layers: 0.21 mm, 0.32 mm to diff pairs, 1.3 mm to HV nets, 0.45 mm
    hole-to-hole). C5 GND pad 1 -> 3 vias; U3 exposed pad 2 -> 5 (left column
    only, the HV pad rule from pads 14/16 blocks the right); all eight J50 S1
    pads solid zone connection (four starved-thermal items gone) and ten GND
    vias beside five of the six posts; vias at U50 pin 8, C56, C57. No legal
    spot for the top-left J50 post and eleven P8 pads (LVDS/CAN pairs, In2
    signals, HV clearance above the bottom-side LDO); listed in decision 28
    for a loc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
    [receiver-module.kicad_pcb]
2026-10-23 PCB/docs: J50 shell stitching vias removed, decision 16 reworded (solid pad connection is the fix)
    The plated shell-post barrels already tie all six copper layers, so the
    eight GND vias added in decision 28 were redundant; what fixed the starved
    thermal connections was setting the S1 pads to solid zone connection.
    Vias and link tracks removed (Daniel, 2026-10-22). Decision 16's layout
    rule now reads "solid connection on every layer, no extra vias";
    decision 28, the board README, the review P7 status, the guide and
    connector.md say the same. DRC 48, 0 unconnected, parity clean.
    Claude-Session: https://claude.ai/code/session_01QZbpq84KQ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
    [receiver-module.kicad_pcb]
2026-10-23 PCB: zone refill after the J50 via removal
    Claude-Session: https://claude.ai/code/session_01QZbpq84KQe6jawehpgiA3s
    [receiver-module.kicad_pcb]
2026-10-23 Docs: HV vias on the clamp base nets accepted (review P4, decision 29); README via claim corrected
    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
2026-10-23 PCB WIP (Daniel, KiCad GUI): ground vias and 3V3_D re-route after review P8; zones refilled
    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
    [power.kicad_sch, receiver-module.kicad_pcb]
2026-10-23 PCB: all reference designators on dedicated RefDes_Top / RefDes_Bottom layers, centred, 0.5 mm
    Eco1.User and Eco2.User renamed RefDes_Top and RefDes_Bottom; every footprint's
    reference field moved there (132 top, 92 bottom, bottom ones mirrored), placed
    at the footprint origin, upright, 0.5 mm / 0.08 mm, nothing else on those
    layers. Silkscreen no longer carries designators. DRC 48, parity clean.
    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
    [receiver-module.kicad_pcb]
2026-10-23 Docs: link budget accepted (review A1/A2, decision 31); optics, arena and tiling credits; emitter working point; S3884 and dual footprint not adopted
    - decision-log: dated addenda to decisions 8 and 12; new decision 31 (corrected
    direct-path budget, collection credits, 1 W class LED at 30-100 mA on-state
    working assumption, A4 as G1 pre-board item, S3884 and dual TO-18/TO-5
    footprint rejected for Rev A)
    - requirements row 2 and environment facts (optics, reflective arena, tiling);
    architecture item 6 (M optimum 83-112 capped 100, optical-dB range figures);
    gates G1 pre-board arena measurement, G2 window restated; guide 2.1, 2.10,
    G1/G2 lists, open risks, decision row 31; review R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
2026-10-23 Docs: headstage-to-receiver optical link interface page (review A3); eye and jitter budget tool
    - docs/optical-link-interface.md (PROPOSED): physical layer (levels, ER, duty,
    optical edge <= 8 ns), line coding and framing pointing at the gateware
    README as the executable definition, continuity obligation (idle at all
    times, 1 ms idle after any LED stop, within-frame droop), eye and jitter
    budget with the 4x CDR quantisation, receiver guarantees, open items
    - tools/eye_budget.py: Gaussian-edge / white-noise eye budget versus LED edge;
    at the Q = 6 floor an 11 to 14 ns optical edge gives jitter-alone BER
    1.5e-7 to 6e-5 per transition (1.2 to 3.4 dB more light to recover)
    - requirem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
2026-10-23 Schematic+PCB: review MINOR set (decision 32); stale-doc corrections (review B8); PCB cleanups, DRC 48 -> 44
    Schematic (KiCad closed, text edits, ERC 0/0):
    - power: R1 17.8k -> 18.7k (3V3 3.42 V nominal, 3.34-3.50 V, clears the
    OPA855 3.3 V minimum; ceiling checked against OPA857 and LVDS104 3.6 V);
    D2 DFLS1150-7 fitted for the first bench build
    - frontend: R53/R54 0.1 % (gain 7.03 at the minimum stable gain of 7);
    C50 10nF 500V C0G, R50 10k 200V, C54 47pF C0G in the value fields
    - slicer: C87 100pF C0G
    - controller: R199 100k -> 91k (HVD230 Rs); C200 DNP (both pins on GND);
    new R214 2.2k in series between U60 IO20 and TIA_CTRL (JP10 short
    protection), net Net-(U60-GPIO20) on the U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
    [controller.kicad_sch, frontend.kicad_sch, power.kicad_sch, receiver-module.kicad_pcb, slicer.kicad_sch]
2026-10-25 PCB: H1-H4 on the no-via mounting-hole footprint, U20 pin 9 solid; DRC 48 -> 11, remaining items accepted in writing (decision 33)
    - H1-H4: AharoniLab_Connector:MountingHole_2.2mm_M2_Pad_Via -> _Pad in the
    board (positions, GND, paths kept) and in connector.kicad_sch footprint
    fields; clears the 32 hole_to_hole items. ERC 0/0, parity 199 field notes
    - U20 pad 9 solid zone connection (starved thermal cleared)
    - zones refilled; DRC 11 (5 silk_edge, 4 diff_pair_gap at R180, 1 uncoupled
    R87 stub, 1 silk_overlap), 0 unconnected
    - docs: decision 33; review README DRC table rewritten as the written
    disposition G4 asks for; board README, guide, CLAUDE.md, root README counts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
    [connector.kicad_sch, receiver-module.kicad_pcb]
2026-10-25 Schematic+PCB: VBUS TVS D50 (SMF5.0A) added on the Connector sheet and parked on the board (decision 34)
    - connector.kicad_sch: AharoniLab_Passive:SMF5.0A embedded, D50 cathode on a
    VBUS local label, anode on GND; ERC 0/0; Connector range gains D50-D59
    - receiver-module.kicad_pcb: D_SOD-123F footprint parked on F.Cu at
    (71.55, 17.17) next to the VBUS entry, unrouted by intent (Daniel places and
    routes); zones refilled; DRC 11, 0 unconnected, parity 199 field notes
    - docs/datasheets/smf5.0a-panjit.pdf + MANIFEST row (Panjit SMF5.0A series
    REV.13; Littelfuse SMF is the intended vendor, LCSC C151296)
    - decision 34; connector.md, sheet-spec designator range, review README MINOR
    status,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
    [connector.kicad_sch, receiver-module.kicad_pcb]
